lionsarmor/cyber-disk-site/site/boards/controller-r1/READ_BEFORE_ORDER.txt

Drive controller · R1
Audio R1 · routed prototype
Main board includes GP27 filtered PWM audio, LM386 and J6 speaker output. J4 pin6 reserved. Playback firmware and powered tests remain outstanding. Current hardware layout and assembly silkscreen. Static checks pass with zero unrouted connections. Gerbers are for prototype fabrication; powered and printed sample qualification is not yet complete. Firmware is unchanged and experimental.

KiCad 10 required. Stock KiCad libraries are needed in addition to bundled local libraries. ZIP contains this board only. No order is placed by downloading.
Source commit 6aa8da5d3b4f68ce047f3269cee6ab1ada03a126
PCB SHA256 d241955f942fde7b65e0d3dcb7b5b6f4355cdfbe41e1222cc3d9f77006061fe5
