lionsarmor/cyber-disk-site/site/downloads/master-bom.csv

id | supplier | part | mpn | drive | single | ab | sleeve | dock | unit | assembly | status | url | alternative | notes | evidence
E01 | Mouser | 4 MiB SPI flash | MX25L3233FM2I-08G-TR |  | 1 | 2 |  |  | each | Disk PCB | Listed in stock | https://www.mouser.com/en/ProductDetail/Macronix/MX25L3233FM2I-08G-TR?qs=mELouGlnn3cWHP7slfWMaw%3D%3D |  | 95-25L3233FM2I08TR. Replaces EOL W25Q32JVSSIQ. Wide M2 SOP8 only; pinout/land pattern match. Firmware now checks C2 20 16 JEDEC and rejects protected media; hardware testing pending. No larger-capacity alternate qualified. | Supplier listing reviewed 2026-11-07; stock must be rechecked at order time
E02 | Mouser | 100 nF 50 V X7R capacitor · 0805 | C0805C104K5RACTU |  | 1 | 2 |  |  | each | Disk PCB | Listed in stock | https://www.mouser.com/en/ProductDetail/KEMET/C0805C104K5RACTU?qs=Pc30aiB8zWUISNb2Qeyxfw%3D%3D |  | 80-C0805C104K5R. Replaces obsolete GRM21BR71C104KA01L; same capacitance and 0805 footprint. | Supplier listing reviewed 2026-11-07; stock must be rechecked at order time
E03 | Mouser | 10 kΩ 1% resistor · 0805 | RC0805FR-0710KL |  | 3 | 6 |  |  | each | Disk PCB | Listed in stock | https://www.mouser.com/ProductDetail/YAGEO/RC0805FR-0710KL |  | 603-RC0805FR-0710KL. Three pullups per independent storage bank. | Supplier listing reviewed 2026-11-07; stock must be rechecked at order time
E17 | Mouser | 20-way Pico socket strips | SSW-120-01-G-S | 2 |  |  |  | 2 | each | Controller and dock assembly | Specified · prototype validation required | https://www.mouser.com/c/?q=200-SSW12001GS |  | Two per carrier. The actual 8.5 mm socket stack is modeled; Pico 2 H plugs into these strips. | Manufacturer/supplier dimensions reviewed 2026-11-07; inventory not reserved
E18 | Mouser | Solderable metal spring contacts | S7131-45R | 7 |  |  |  |  | each | Contact PCB | Listed in stock | https://www.mouser.com/en/ProductDetail/Harwin/S7131-45R?qs=pffCcXpkxLy98k%2F0F4%2FdwQ%3D%3D |  | 855-S7131-45R. Manufacturer drawing controls: 2.0mm free height, 1.0–1.4mm working range. Mouser summary dimensions disagree; use Harwin drawing. Solder base only; sliding wear unqualified. | Supplier listing reviewed 2026-11-07; stock must be rechecked at order time
H01 | Mouser | M3 short tapered heat-set inserts | IUB-M3-1 | 22 |  |  |  | 2 | each | Drive structure | Specified · prototype validation required | https://www.mouser.com/c/?q=IUB-M3-1 |  | 3.43 mm length, 4.37 mm maximum OD. Pockets follow PEM 3.89–4.04 mm tapered bore and 4.44 mm minimum depth. Print insertion coupons; do not substitute Adafruit 4255. | Manufacturer/supplier dimensions reviewed 2026-11-07; inventory not reserved
H02 | Common hardware / McMaster | M3 × 8 countersunk cassette screws | DIN 7991 M3x8 | 4 |  |  |  | 6 | each | Drive structure | Specified · prototype validation required | https://www.mcmaster.com/screws/thread-size~m3/ |  | Four underside cassette screws. Overall length includes countersunk head; dock uses four bridge and two carrier screws. | Manufacturer/supplier dimensions reviewed 2026-11-07; inventory not reserved
H03 | Common hardware / McMaster | M3 × 10 button-head screws | ISO 7380-1 M3x10 | 6 |  |  |  |  | each | Drive structure | Specified · prototype validation required | https://www.mcmaster.com/screws/thread-size~m3/ |  | Four inside bezel screws and two latch-bracket screws; head Ø5.7 ×1.65 mm. | Manufacturer/supplier dimensions reviewed 2026-11-07; inventory not reserved
H04 | Common hardware / McMaster | M3 × 6 button-head PCB screws | ISO 7380-1 M3x6 | 4 |  |  |  | 6 | each | Controller mounting | Specified · prototype validation required | https://www.mcmaster.com/screws/thread-size~m3/ |  | Head Ø5.7 ×1.65 mm; four captive M3 nuts under main PCB. | Manufacturer/supplier dimensions reviewed 2026-11-07; inventory not reserved
H05 | Common hardware / McMaster | M3 hex nuts | ISO 4032 M3 | 4 |  |  |  | 12 | each | Controller mounting | Specified · prototype validation required | https://www.mcmaster.com/nuts/thread-size~m3/ |  | 5.5 mm AF, 2.4 mm thick; trap clearance in CAD. | Manufacturer/supplier dimensions reviewed 2026-11-07; inventory not reserved
H06 | Common hardware / McMaster | M3 × 6 tower/carrier screws | ISO 7380-1 M3x6 | 4 |  |  |  |  | each | Tower installation | Specified · prototype validation required | https://www.mcmaster.com/screws/thread-size~m3/ |  | Four screws per installation; do not count twice when core is inside external case. Check tower sheet thickness and screw engagement. | Manufacturer/supplier dimensions reviewed 2026-11-07; inventory not reserved
H07 | Common hardware / McMaster | M2 × 6 socket-head hinge-cap screws | DIN 912 M2x6 | 4 |  |  |  |  | each | Flap bearings | Specified · prototype validation required | https://www.mcmaster.com/screws/thread-size~m2/ |  | Four removable bearing-cap screws; Ø3.8 ×2 mm head. | Manufacturer/supplier dimensions reviewed 2026-11-07; inventory not reserved
H08 | Common hardware / McMaster | M2 hex nuts | ISO 4032 M2 | 8 |  |  |  | 4 | each | Flap bearings | Specified · prototype validation required | https://www.mcmaster.com/nuts/thread-size~m2/ |  | 4 mm AF ×1.6 mm thick. Four bearing caps plus four switch mounting nuts. | Manufacturer/supplier dimensions reviewed 2026-11-07; inventory not reserved
H09 | Common hardware / McMaster | M2 × 8 countersunk lid / clamp screws | DIN 7991 M2x8 | 6 |  |  |  | 6 | each | Lid and cable clamp | Specified · prototype validation required | https://www.mcmaster.com/screws/thread-size~m2/ |  | Four core lid screws and two contact-harness clamp screws. Overall length 8 mm. | Manufacturer/supplier dimensions reviewed 2026-11-07; inventory not reserved
H10 | MISUMI | M2 × 5 ultra-low-head contact PCB screws | CBSTSR2-5 | 2 |  |  |  |  | each | Contact cartridge | Specified · prototype validation required | https://my.misumi-ec.com/vona2/detail/110302280540/?HissuCode=CBSTSR2-5 |  | Use the ultra-low-head part only: specified head Ø4 ×0.5 mm. Do not substitute a tall socket head in the disk path. | Manufacturer/supplier dimensions reviewed 2026-11-07; inventory not reserved
H11 | Mouser | M2 heat-set inserts | IUTB-M2 | 6 |  |  |  | 6 | each | Lid and contact PCB | Specified · prototype validation required | https://www.mouser.com/c/?q=IUTB-M2 |  | 4 mm long, 3.73 mm maximum OD; Ø3.23 mm hole, ≥4.76 mm depth. Lid and cartridge mounts. | Manufacturer/supplier dimensions reviewed 2026-11-07; inventory not reserved
H12 | Mouser | M2 harness clamp heat-set inserts | IUTB-M2 | 2 |  |  |  |  | each | Cable clamp | Specified · prototype validation required | https://www.mouser.com/c/?q=IUTB-M2 |  | Same 4 mm insert as H11; clamp bosses deepened accordingly. | Manufacturer/supplier dimensions reviewed 2026-11-07; inventory not reserved
H13 | Common hardware / McMaster | Smooth Ø3 mm steel rod, cut to length | 3 mm precision steel rod | 1 |  |  |  |  | cutting stock | Eject carriage | Specified · prototype validation required | https://www.mcmaster.com/rods/diameter~3-mm/ |  | Cut two 71 mm eject rods and one 11.9 mm left flap pivot. Deburr and polish ends. No grooves, D-flats or threaded sliding surfaces. | Manufacturer/supplier dimensions reviewed 2026-11-07; inventory not reserved
H14 | Lee Spring | Matched eject compression springs | LC022D14M | 2 |  |  |  |  | each | Eject carriage | Specified · prototype validation required | https://www.leespring.in/sites/default/files/2019-09/lee-spring-catalog-in.pdf |  | Two springs: free 63.5 mm, OD7.62, wire0.5588, solid9.93; rate1.10 lbf/in (0.193 N/mm). Installed27.6–55.6 mm; combined nominal preload3.0–13.8 N. Catalog specified; confirm current availability with Lee. | Manufacturer/supplier dimensions reviewed 2026-11-07; inventory not reserved
H15 | Lee Spring | Eject-button return spring | LC018C09M | 1 |  |  |  |  | each | Eject button | Specified · prototype validation required | https://www.leespring.in/sites/default/files/2019-09/lee-spring-catalog-in.pdf |  | Free19.05 mm, OD6.096, wire.4572, solid3.35, rate2.80 lbf/in. Installed8.3–14.3 mm; avoids coil bind at full 6 mm button stroke. | Manufacturer/supplier dimensions reviewed 2026-11-07; inventory not reserved
H16 | Lee Spring | Latch bias spring | CI008BC03M | 1 |  |  |  |  | each | Latch | Specified · prototype validation required | https://www.leespring.in/sites/default/files/2019-09/lee-spring-catalog-in.pdf |  | Free6.35 mm, OD2.3876, wire.2032, solid1.53; rate2.14 lbf/in. Installed2.7–5.5 mm. | Manufacturer/supplier dimensions reviewed 2026-11-07; inventory not reserved
H17 | Lee Spring | Flap torsion spring | LTR014A04M | 1 |  |  |  |  | each | Flap hinge | Specified · prototype validation required | https://www.leespring.in/sites/default/files/2019-09/lee-spring-catalog-in.pdf |  | Right-hand, 180° free legs; OD4.93 mm, wire.3556, body1.91. Trim straight legs to6 mm; closed preload65°, full-open deflection155°. Rated torque.075 in-lb at180°. Physical torque/friction test required. | Manufacturer/supplier dimensions reviewed 2026-11-07; inventory not reserved
H18 | Mouser / common hardware | Flap right pivot screw and metal bearing spacer | R30-5001002 + DIN7991 M3x25 + DIN985 M3 | 1 |  |  |  |  | set | Flap hinge | Specified · prototype validation required | https://www.harwin.com/products/R30-5001002 |  | Spacer is10 mm long, Ø4.76, M3 through-threaded. One countersunk M3x25 and one M3 nylon-lock nut clamp flap and rocker to spacer; round bearing runs freely in split housing. | Manufacturer/supplier dimensions reviewed 2026-11-07; inventory not reserved
H19 | Common hardware / McMaster | Standard metal follower screws | DIN912 M2x20 + DIN912 M2x10 | 1 |  |  |  |  | set | Actuator and latch | Specified · prototype validation required | https://www.mcmaster.com/screws/thread-size~m2/ |  | One M2x20 latch follower and one M2x10 flap follower; replaceable smooth brass sleeves carry cam wear. | Manufacturer/supplier dimensions reviewed 2026-11-07; inventory not reserved
H20 | Common hardware / McMaster | Follower locking nuts | DIN985 M2 | 2 |  |  |  |  | each | Actuator and latch | Specified · prototype validation required | https://www.mcmaster.com/nuts/thread-size~m2/ |  | Two M2 nylon-lock nuts, 4 mm AF ×2.8 mm maximum height. Replaces all small follower retaining clips. | Manufacturer/supplier dimensions reviewed 2026-11-07; inventory not reserved
H21 | Hobby / K&S | Brass wear-sleeve stock | K&S 9821 | 1 |  |  |  |  | cutting stock | Flap actuator | Specified · prototype validation required | https://ksmetals.com/collections/all-products-1?page=10 |  | Ø3 mm OD ×0.45 wall (2.1 mm ID). Cut sleeves3.3 mm,4.4 mm and5.0 mm; square/deburr ends. No retaining grooves required. | Manufacturer/supplier dimensions reviewed 2026-11-07; inventory not reserved
H22 | Common hardware / McMaster | Compliant contact-harness grip pad | Silicone sheet 2 mm, Shore A40 | 1 |  |  |  |  | each | Cable clamp | Specified · prototype validation required | https://www.mcmaster.com/silicone-sheets/ |  | Cut4×5×2 mm. Clamp on insulation only; check grip without crushing conductors. | Manufacturer/supplier dimensions reviewed 2026-11-07; inventory not reserved
E19 | Mouser | 26 AWG stranded contact/switch wire | 6821 BK005 | 2 |  |  |  |  | metres | Contact harness | Specified · prototype validation required | https://www.mouser.com/ProductDetail/Alpha-Wire/6821-BK005 |  | 0.89 mm nominal OD (0.94 mm max), 7/34 strands, compatible with terminal 26–20 AWG range. Seven contact wires cut150 mm each; number both ends 1–7. Colours in preview identify signals; numbered black wire is sufficient. Do not tin ends clamped under screws. Quantity is cut length, not 100 ft spools. | Manufacturer/supplier dimensions reviewed 2026-11-07; inventory not reserved
B01 | PCBWay | Single-bank disk PCB | Custom project PCB |  | 1 |  |  |  | each | Disk PCB | Prototype only | https://www.pcbway.com/pcb-assembly.html |  | 87 x91 x1.6mm R4; 2 layers; verify contact plating and wear. Provisional Gerbers exist. Turnkey assembly is a quote option; components are not included automatically with bare boards. | Supplier listing reviewed 2026-11-07; stock must be rechecked at order time
B02 | PCBWay | Independent A/B disk PCB | Custom project PCB |  |  | 1 |  |  | each | Disk PCB | Prototype only | https://www.pcbway.com/pcb-assembly.html |  | Same outline, two independent banks; both component banks on top for one stencil. Turnkey assembly is a quote option; components are not included automatically with bare boards. | Supplier listing reviewed 2026-11-07; stock must be rechecked at order time
B03 | PCBWay | Passive contact cartridge PCB | Custom project PCB | 1 |  |  |  |  | each | Contact PCB | Prototype only | https://www.pcbway.com/pcb-assembly.html |  | 18.525 x49 x1.6mm; routed R1; seven soldered spring lands and pigtail pads. Turnkey assembly is a quote option; components are not included automatically with bare boards. | Supplier listing reviewed 2026-11-07; stock must be rechecked at order time
B04 | PCBWay | Routed drive-controller PCB | cyber-drive-controller-r1 | 1 |  |  |  |  | each | Controller PCB | Specified · prototype validation required | https://www.pcbway.com/ |  | 136×65×1.6 mm; rounded corners; current R3 hardware changes, silkscreen/logo, isolated media rails and interlock. Use current per-board Gerbers, not R0. | Manufacturer/supplier dimensions reviewed 2026-11-07; inventory not reserved
P01 | Print at home | 01 base tray | Project STL / STEP | 1 |  |  |  |  | each | Drive printed parts | Prototype only | index.html?model=drive%2Fexploded |  | Print material, orientation and tolerances require prototype testing. | Current drive R4 parts.json
P02 | Print at home | 02 top cover | Project STL / STEP | 1 |  |  |  |  | each | Drive printed parts | Prototype only | index.html?model=drive%2Fexploded |  | Print material, orientation and tolerances require prototype testing. | Current drive R4 parts.json
P03 | Print at home | 04b left hinge bearing cap | Project STL / STEP | 1 |  |  |  |  | each | Drive printed parts | Prototype only | index.html?model=drive%2Fexploded |  | Print material, orientation and tolerances require prototype testing. | Current drive R4 parts.json
P04 | Print at home | 04b right hinge bearing cap | Project STL / STEP | 1 |  |  |  |  | each | Drive printed parts | Prototype only | index.html?model=drive%2Fexploded |  | Print material, orientation and tolerances require prototype testing. | Current drive R4 parts.json
P05 | Print at home | 03 bezel | Project STL / STEP | 1 |  |  |  |  | each | Drive printed parts | Prototype only | index.html?model=drive%2Fexploded |  | Print material, orientation and tolerances require prototype testing. | Current drive R4 parts.json
P06 | Print at home | 04 door flap | Project STL / STEP | 1 |  |  |  |  | each | Drive printed parts | Prototype only | index.html?model=drive%2Fexploded |  | Print material, orientation and tolerances require prototype testing. | Current drive R4 parts.json
P07 | Print at home | flap actuator rocker | Project STL / STEP | 1 |  |  |  |  | each | Drive printed parts | Prototype only | index.html?model=drive%2Fexploded |  | Print material, orientation and tolerances require prototype testing. | Current drive R4 parts.json
P08 | Print at home | 05 left guide | Project STL / STEP | 1 |  |  |  |  | each | Drive printed parts | Prototype only | index.html?model=drive%2Fexploded |  | Print material, orientation and tolerances require prototype testing. | Current drive R4 parts.json
P09 | Print at home | 06 right guide | Project STL / STEP | 1 |  |  |  |  | each | Drive printed parts | Prototype only | index.html?model=drive%2Fexploded |  | Print material, orientation and tolerances require prototype testing. | Current drive R4 parts.json
P10 | Print at home | 07b left eject sled | Project STL / STEP | 1 |  |  |  |  | each | Drive printed parts | Prototype only | index.html?model=drive%2Fexploded |  | Print material, orientation and tolerances require prototype testing. | Current drive R4 parts.json
P11 | Print at home | 07 right eject sled and keeper | Project STL / STEP | 1 |  |  |  |  | each | Drive printed parts | Prototype only | index.html?model=drive%2Fexploded |  | Print material, orientation and tolerances require prototype testing. | Current drive R4 parts.json
P12 | Print at home | 08 keyed latch slide | Project STL / STEP | 1 |  |  |  |  | each | Drive printed parts | Prototype only | index.html?model=drive%2Fexploded |  | Print material, orientation and tolerances require prototype testing. | Current drive R4 parts.json
P13 | Print at home | 09 latch guide block | Project STL / STEP | 1 |  |  |  |  | each | Drive printed parts | Prototype only | index.html?model=drive%2Fexploded |  | Print material, orientation and tolerances require prototype testing. | Current drive R4 parts.json
P14 | Print at home | 10 sequenced eject slider | Project STL / STEP | 1 |  |  |  |  | each | Drive printed parts | Prototype only | index.html?model=drive%2Fexploded |  | Print material, orientation and tolerances require prototype testing. | Current drive R4 parts.json
P15 | Print at home | 12 bottom contact cassette | Project STL / STEP | 1 |  |  |  |  | each | Drive printed parts | Prototype only | index.html?model=drive%2Fexploded |  | Print material, orientation and tolerances require prototype testing. | Current drive R4 parts.json
P16 | Print at home | 13 harness strain clamp | Project STL / STEP | 1 |  |  |  |  | each | Drive printed parts | Prototype only | index.html?model=drive%2Fexploded |  | Print material, orientation and tolerances require prototype testing. | Current drive R4 parts.json
P30 | Print at home | Upper and lower disk shell | Matching style and single / A/B geometry |  | 2 | 2 |  |  | halves | Disk shell | Prototype only | index.html?model=basic%2Fab |  | Current snap-fit shells; no disk-face screws or nuts. Choose basic, recessed, Cyber Runner or Deep Space. Do not mix archived screw-service shells. | Current inspector model catalog
P31 | Print at home | Optional Cyber Runner accents / inlays | 4 accents + 4 inlay pieces |  |  |  |  |  | 8 per styled disk | Optional styling | Prototype only | index.html?model=cyber-runner%2Fab |  | Per styled disk: 8 optional printed pieces. Excluded from base disk quantity totals. | Current inspector model catalog
P32 | Print at home | Optional Deep Space accents | 4 wrap accents |  |  |  |  |  | 4 per styled disk | Optional styling | Prototype only | index.html?model=deep-space%2Fab |  | Per styled disk: 4 optional accents. Excluded from base disk quantity totals. | Current inspector model catalog
P33 | Print at home | Modular sleeve | Project sleeve R0 |  |  |  | 1 |  | each | Sleeve | Prototype only | index.html?model=sleeve%2Fempty |  | Optional accessory; slide joints and Sega case fit remain unverified. | Current inspector model catalog
A01 | Local print / office supplier | White wrap label | Single-sided or full A/B wrap |  | 1 | 1 |  |  | each | Artwork | Unselected |  |  | Use the current rounded straight-fold template, white stock and Roddy branding; adhesive/finish and exact stock not selected. | Project requirement; not a sourced SKU
A02 | Included | Media isolation and interlock hardware | Included in controller + CR1-SW |  |  |  |  |  | each | Controller and interlock | Specified · prototype validation required | http://disk.roddy.world/electrical.html |  | No extra unselected isolation board: switched rail, signal isolation, active discharge and physical switches are in current hardware. Avoid double-counting components. | Manufacturer/supplier dimensions reviewed 2026-11-07; inventory not reserved
A03 | Included | Sound / lighting / external ports | Included in dock and DX86/DX90 |  |  |  |  |  | each | External dock features | Specified · prototype validation required | http://disk.roddy.world/?model=pcb%2Fdock |  | USB-B, RS232, Commodore IEC and custom3.3V accessory connector. ESP32/Next protocol adapters and emulation software are separate from this board; connector presence is not firmware support. | Manufacturer/supplier dimensions reviewed 2026-11-07; inventory not reserved
A04 | Not specified yet | External host cables and optional Sega case | Choose for host / packaging |  |  |  |  |  | As required | Optional accessories | Unselected |  |  | Optional host-side cables and retail packaging depend on the chosen computer. The regulated 5V supply is already specified separately as DX80; do not count another supply here. | Not yet specified
A05 | Local hardware / electronics supplier | Solder or paste, flux and heat-shrink | Assembly consumables |  |  |  |  |  | As required | Assembly supplies | Unselected |  |  | Tools and consumables are not counted as fitted parts. A stencil is optional for paste assembly; PCBWay can quote stencils. | Assembly requirement; not a sourced SKU
DX81 | Mouser | Internal USB-A to micro-B jumper, 6.5 inch | Adafruit 898 |  |  |  |  | 1 | each | External dock R3 | Fit pending | https://www.mouser.com/ProductDetail/Adafruit/898 |  | 485-898. Plugs into J10 and Pico micro-B; no test-pad soldering. Cable envelope needs physical fit test. | Mouser listing and Adafruit specification reviewed 2026-11-07
DX86 | Mouser | Through-hole diffused addressable RGB LEDs | Adafruit 1938 |  |  |  |  | 1 | five-pack | External dock R3 | Specified · prototype validation required | https://www.mouser.com/c/?q=485-1938 |  | Three fitted LEDs from one five-pack, max60mA each, total180mA within200mA light allocation. Three local100nF caps required. Screw-retained lightwell; programmable effects are firmware work. | Manufacturer/supplier dimensions reviewed 2026-11-07; inventory not reserved
DX80 | Mouser | External regulated 5V 2A adapter, centre positive | WSU050-2000 |  |  |  |  | 1 | each | External dock R3 | Listed in stock; electrical qualification pending | https://www.mouser.com/en/ProductDetail/Triad-Magnetics/WSU050-2000?qs=B4sXYbYweUrLCvb6OyMLMA%3D%3D |  | 553-WSU050-2000. 5.5 x 2.1 x 11 mm plug. About $7.62 each when checked. Verify loaded board voltage including cable/ripple; not an internal supply. | Mouser US listing read 2026-11-07; 60 shown, not reserved
DX88 | Common hardware / Mouser | External-case fasteners and feet | See hardware cut/fastener table |  |  |  |  |  | reference only | External dock R3 | Specified · prototype validation required | https://www.mcmaster.com/ |  | SixM2x8 lid screws+IUTB-M2 inserts; fourM3x8 chassis screws+M3 nuts; sixM3x6 board screws; twoM2x10 lightwell screws+M2 nuts; fourM3x6 core side screws shared with H06. Four10×10×2 mm rubber feet. See assembly drawing for retention hardware. | Manufacturer/supplier dimensions reviewed 2026-11-07; inventory not reserved
DX89 | 3D print | Rounded enclosure, carriers and opal diffuser | External dock R4 |  |  |  |  | 1 | printed set | External dock R3 | Specified · prototype validation required | http://disk.roddy.world/?model=external%2Fclosed |  | 168×280×57 mm including feet; shallow roof recess, shell-matched RODDY artwork and wraparound diffuser. Core raised for solid TH-LED retention bridge; same bay-standard core. | Manufacturer/supplier dimensions reviewed 2026-11-07; inventory not reserved
DX27 | Mouser | 10-way 1:1 internal signal ribbon | 1658621-1 + 3365/10-100SF |  |  |  |  | 1 | harness | External dock R3 | Specified · prototype validation required | https://www.mouser.com/c/?q=571-1658621-1 |  | Two TE10-way IDC sockets,220 mm of 3M1.27 mm pitch28AWG ribbon. Straight1:1, no PC floppy twist. Pin1 stripe matched at both ends; dock pins2/7 remain NC. | Manufacturer/supplier dimensions reviewed 2026-11-07; inventory not reserved
DX28 | Mouser | 5V internal power harness | 171822-4 + 170204-2 + 3051 BK005 |  |  |  |  | 1 | harness | External dock R3 | Specified · prototype validation required | https://www.mouser.com/c/?q=571-1718224 |  | TE4-way housing, two170204-2 sockets.22AWG stranded Alpha3051 wire,150 mm each red-marked5V and blackGND. Other end Harwin2-way J6. Berg cavity4(12V) remains empty; verify continuity before connection. | Manufacturer/supplier dimensions reviewed 2026-11-07; inventory not reserved
CR1-SW | Mouser | Seat NO and pre-eject NC switches | D2F-01-D | 2 |  |  |  |  | each | Drive mechanism | Specified · prototype validation required | https://www.mouser.com/c/?q=653-D2F-01-D |  | Compact solder-lug plunger version. SW1 NO and SW2 NC in series to J5. R5 includes screw mounts, cams and lug wiring. Adjust to manufacturer operating position before powered tests. | Manufacturer/supplier dimensions reviewed 2026-11-07; inventory not reserved
H02G | Common hardware / McMaster | M3 × 6 countersunk guide screws | DIN 7991 M3x6 | 4 |  |  |  |  | each | Hardware R3 | Specified · prototype validation required | https://www.mcmaster.com/screws/thread-size~m3/ |  | Four guide screws; 6 mm overall, head diameter 6 mm. | Manufacturer/supplier dimensions reviewed 2026-11-07; inventory not reserved
H23 | Common hardware / McMaster | Switch mounting screws | DIN912 M2x12 + DIN7991 M2x12 | 1 |  |  |  |  | set | Hardware R3 | Specified · prototype validation required | https://www.mcmaster.com/screws/thread-size~m2/ |  | Two socket-head screws for seat switch, two countersunk screws through base for eject switch. | Manufacturer/supplier dimensions reviewed 2026-11-07; inventory not reserved
HX01 | Mouser | Contact-board seven-way screw terminal | 1725708 | 1 |  |  |  |  | each | Hardware R3 | Specified · prototype validation required | https://www.mouser.com/c/?q=651-1725708 |  | Phoenix MPT0.5/7-2.54; 18.24×6.2×8.5 mm installed. Mounted underneath contact PCB; wire 1:1 to identical core J3. Core terminal is counted in CR1 BOM. Strip 4.5 mm, torque 0.12–0.15 Nm; support housing while tightening. Trim contact-board solder tails to <=0.5 mm above PCB. | Manufacturer/supplier dimensions reviewed 2026-11-07; inventory not reserved
HX02 | Mouser | 2-way removable header housings | M20-1060200 | 2 |  |  |  | 2 | each | Hardware R3 | Specified · prototype validation required | https://www.mouser.com/c/?q=855-M20-1060200 |  | Drive J5 interlock and J6 speaker; dock J6 power and J8 passive piezo. | Manufacturer/supplier dimensions reviewed 2026-11-07; inventory not reserved
HX03 | Mouser | 3-way lighting header housing | M20-1060300 |  |  |  |  | 1 | each | Hardware R3 | Specified · prototype validation required | https://www.mouser.com/c/?q=855-M20-1060300 |  | Dock J7: verify 5V/data/GND order against silkscreen. | Manufacturer/supplier dimensions reviewed 2026-11-07; inventory not reserved
HX04 | Mouser | Loose crimp sockets,22–30 AWG | M20-1180042 | 4 |  |  |  | 7 | each | Hardware R3 | Specified · prototype validation required | https://www.mouser.com/c/?q=855-M20-1180042 |  | Harwin M20 socket contacts; one per populated housing cavity. Crimp with proper die, pull-test each wire. | Manufacturer/supplier dimensions reviewed 2026-11-07; inventory not reserved
DX90 | Mouser | Passive piezo sounder | PS1240P02CT3 |  |  |  |  | 1 | each | Hardware R3 | Specified · prototype validation required | https://www.mouser.com/c/?q=810-PS1240P02CT3 |  | 12.2×3.5 mm TDK piezo; existing GPIO26 feeds J8 through added R11=1k. Maximum pin current3.3mA; intended for chirps/tones. | Manufacturer/supplier dimensions reviewed 2026-11-07; inventory not reserved
DX91 | Mouser | LED local decoupling capacitors | C315C104M5U5TA |  |  |  |  | 3 | each | Hardware R3 | Specified · prototype validation required | https://www.mouser.com/c/?q=80-C315C104M5U |  | One100nF across each TH pixel supply, short leads; insulate hand-wired connections. | Manufacturer/supplier dimensions reviewed 2026-11-07; inventory not reserved
H24 | Common hardware / McMaster | M2 × 10 countersunk lightwell / piezo screws | DIN7991 M2x10 |  |  |  |  | 4 | each | Hardware R3 | Specified · prototype validation required | https://www.mcmaster.com/screws/thread-size~m2/ |  | Two lightwell and two piezo-cap screws; nuts counted in H08. | Manufacturer/supplier dimensions reviewed 2026-11-07; inventory not reserved
H25 | Common hardware / McMaster | M3 × 10 countersunk rear-tray screws | DIN7991 M3x10 |  |  |  |  | 2 | each | Hardware R3 | Specified · prototype validation required | https://www.mcmaster.com/screws/thread-size~m3/ |  | Two rear panel screws; inserts counted in H01. | Manufacturer/supplier dimensions reviewed 2026-11-07; inventory not reserved
H26 | Common hardware / McMaster | Self-adhesive rubber feet | 10 × 10 × 2 mm |  |  |  |  | 4 | each | Hardware R3 | Specified · prototype validation required | https://www.mcmaster.com/rubber-feet/ |  | Four feet; use at least 2 mm height for underfloor joint bridge clearance. | Manufacturer/supplier dimensions reviewed 2026-11-07; inventory not reserved
H27 | Common hardware / McMaster | Piezo isolation washer | 2 mm closed-cell foam |  |  |  |  | 1 | each | Hardware R3 | Specified · prototype validation required | https://www.mcmaster.com/foam/ |  | Cut 12 mm OD / 8 mm ID ring; supports piezo above insulated solder joints. | Manufacturer/supplier dimensions reviewed 2026-11-07; inventory not reserved
B05 | PCBWay | Routed external daughterboard PCB | cyber-external-dock-r3 |  |  |  |  | 1 | each | Hardware R3 | Specified · prototype validation required | https://www.pcbway.com/ |  | Current dock R3 board with RODDY silkscreen and board-mounted ports. Use external-r3 PCBWay Gerber package; no mains circuitry. | Manufacturer/supplier dimensions reviewed 2026-11-07; inventory not reserved
SP01 | Mouser | Drive dynamic speaker, 20 mm × 3 mm, 8 ohm 0.5 W | AS02008MR-R | 1 |  |  |  |  | each | Hardware R3 | Specified · prototype validation required | https://www.mouser.com/en/ProductDetail/PUI-Audio/AS02008MR-R?qs=e16JbV5WBEsk5k09rzRy6w%3D%3D |  | Main-board LM386 drives this speaker through J6. Solder two 26 AWG leads to pads (<=3 seconds per PUI); terminate in removable 2-way housing. Rear-wall printed cradle and screw ring, no diaphragm loading. Mouser 665-AS02008MRR listed in stock at review; not reserved. | Manufacturer/supplier dimensions reviewed 2026-11-07; inventory not reserved
SP02 | Common hardware / McMaster | Speaker retention hardware | M2x8 + M2x10 countersunk + M2 nuts | 1 |  |  |  |  | set | Hardware R3 | Specified · prototype validation required | https://www.mcmaster.com/screws/thread-size~m2/ |  | Two M2x8 ring screws, two M2x10 rear cradle screws and four M2 nuts; keep separate from existing mechanism fastener counts. | Manufacturer/supplier dimensions reviewed 2026-11-07; inventory not reserved
SP03 | Common hardware / McMaster | Speaker rim isolation foam | 0.6 mm closed-cell foam | 1 |  |  |  |  | each | Hardware R3 | Specified · prototype validation required | https://www.mcmaster.com/foam/ |  | Cut 20.4 mm OD / 19.2 mm ID ring, compressed to approximately0.4 mm. Frame only: never cover or press diaphragm. Verify supplied speaker rim on physical sample. | Manufacturer/supplier dimensions reviewed 2026-11-07; inventory not reserved
SP04 | Mouser | Speaker wiring pair | Alpha 6821 BK005 | 1 |  |  |  |  | pair | Hardware R3 | Specified · prototype validation required | https://www.mouser.com/ProductDetail/Alpha-Wire/6821-BK005 |  | Two 100 mm lengths of26AWG stranded wire, red-mark positive; 2 Harwin M20 crimp contacts for J6 housing (same family as interlock). Measure final loom before cutting. | Manufacturer/supplier dimensions reviewed 2026-11-07; inventory not reserved
CR1-01 | Mouser | 34-PIN PC FLOPPY | 5103310-7 | 1 |  |  |  |  | each | Controller R1 | Specified · listed by supplier | https://www.mouser.com/c/?q=571-5103310-7 |  | J1; Connector_IDC:IDC-Header_2x17_P2.54mm_Horizontal. Builder assembly through-hole; Pico is a factory-assembled module. Check stock when ordering. | Saved-board BOM reconciled 2026-11-07; exact Mouser SKU 571-5103310-7
CR1-02 | Mouser | FLOPPY POWER 5V GND GND 12V | 171826-4 | 1 |  |  |  |  | each | Controller R1 | Specified · listed by supplier | https://www.mouser.com/c/?q=571-1718264 |  | J2; Drive:TE_171826-4. Builder assembly through-hole; Pico is a factory-assembled module. Check stock when ordering. | Saved-board BOM reconciled 2026-11-07; exact Mouser SKU 571-1718264
CR1-03 | Mouser | PICO 2 SC1632 SOCKETED | SC1632 | 1 |  |  |  |  | each | Controller R1 | Specified · listed by supplier | https://www.mouser.com/c/?q=358-SC1632 |  | A1; Module:RaspberryPi_Pico_Common_THT. Builder assembly through-hole; Pico is a factory-assembled module. Check stock when ordering. | Saved-board BOM reconciled 2026-11-07; exact Mouser SKU 358-SC1632
CR1-04 | Mouser | SN74LVC245AN / 5V-TOL INPUT | SN74LVC245AN | 3 |  |  |  |  | each | Controller R1 | Specified · listed by supplier | https://www.mouser.com/c/?q=595-SN74LVC245AN |  | U1, U2, U4; Package_DIP:DIP-20_W7.62mm. Builder assembly through-hole; Pico is a factory-assembled module. Check stock when ordering. | Saved-board BOM reconciled 2026-11-07; exact Mouser SKU 595-SN74LVC245AN
CR1-05 | Mouser | TN0702 / FDD INDEX | TN0702N3-G | 9 |  |  |  |  | each | Controller R1 | Specified · listed by supplier | https://www.mouser.com/c/?q=689-TN0702N3-G |  | Q4, Q5, Q6, Q7, Q8, Q2, Q3, Q10, Q11; Package_TO_SOT_THT:TO-92_Inline. Builder assembly through-hole; Pico is a factory-assembled module. Check stock when ordering. | Saved-board BOM reconciled 2026-11-07; exact Mouser SKU 689-TN0702N3-G
CR1-06 | Mouser | 8x10k BUSSED / COMMON PIN1 | 4609X-101-103LF | 2 |  |  |  |  | each | Controller R1 | Specified · listed by supplier | https://www.mouser.com/c/?q=652-4609X-1LF-10K |  | RN1, RN2; Resistor_THT:R_Array_SIP9. Builder assembly through-hole; Pico is a factory-assembled module. Check stock when ordering. | Saved-board BOM reconciled 2026-11-07; exact Mouser SKU 652-4609X-1LF-10K
CR1-07 | Mouser | 8x1k BUSSED / COMMON GND | 4609X-101-102LF | 1 |  |  |  |  | each | Controller R1 | Specified · listed by supplier | https://www.mouser.com/c/?q=652-4609X-1LF-1K |  | RN3; Resistor_THT:R_Array_SIP9. Builder assembly through-hole; Pico is a factory-assembled module. Check stock when ordering. | Saved-board BOM reconciled 2026-11-07; exact Mouser SKU 652-4609X-1LF-1K
CR1-08 | Mouser | 2A FAST / LOW DROP | 0251002.MXL | 1 |  |  |  |  | each | Controller R1 | Specified · listed by supplier | https://www.mouser.com/c/?q=576-0251002.MXL |  | F1; Resistor_THT:R_Axial_DIN0309_L9.0mm_D3.2mm_P12.70mm_Horizontal. Builder assembly through-hole; Pico is a factory-assembled module. Check stock when ordering. | Saved-board BOM reconciled 2026-11-07; exact Mouser SKU 576-0251002.MXL
CR1-09 | Mouser | 1N5819 / USB BACKFEED BLOCK | 1N5819-E3/54 | 1 |  |  |  |  | each | Controller R1 | Specified · listed by supplier | https://www.mouser.com/c/?q=625-1N5819-E3 |  | D1; Diode_THT:D_DO-41_SOD81_P10.16mm_Horizontal. Builder assembly through-hole; Pico is a factory-assembled module. Check stock when ordering. | Saved-board BOM reconciled 2026-11-07; exact Mouser SKU 625-1N5819-E3
CR1-10 | Mouser | 47uF 16V | EEU-FC1C470 | 2 |  |  |  |  | each | Controller R1 | Specified · listed by supplier | https://www.mouser.com/c/?q=667-EEU-FC1C470 |  | C1, C14; Capacitor_THT:CP_Radial_D5.0mm_P2.00mm. Builder assembly through-hole; Pico is a factory-assembled module. Check stock when ordering. | Saved-board BOM reconciled 2026-11-07; exact Mouser SKU 667-EEU-FC1C470
CR1-11 | Mouser | 100nF 50V | C315C104M5U5TA | 7 |  |  |  |  | each | Controller R1 | Specified · listed by supplier | https://www.mouser.com/c/?q=80-C315C104M5U |  | C2, C3, C5, C7, C12, C15, C16; Drive:KEMET_C315_P2.54. Builder assembly through-hole; Pico is a factory-assembled module. Check stock when ordering. | Saved-board BOM reconciled 2026-11-07; exact Mouser SKU 80-C315C104M5U
CR1-12 | Mouser | 1725708 / CONTACT WIRES 1 TO 7 | 1725708 | 1 |  |  |  |  | each | Controller R1 | Specified · listed by supplier | https://www.mouser.com/c/?q=651-1725708 |  | J3; HardwareSilk:Terminal7_Phoenix1725708. Builder assembly through-hole; Pico is a factory-assembled module. Check stock when ordering. | Saved-board BOM reconciled 2026-11-07; exact Mouser SKU 651-1725708
CR1-13 | Mouser | DOCK LINK 3V3 UART | TSW-105-07-G-D | 1 |  |  |  |  | each | Controller R1 | Specified · listed by supplier | https://www.mouser.com/c/?q=200-TSW10507GD |  | J4; Connector_PinHeader_2.54mm:PinHeader_2x05_P2.54mm_Vertical. Builder assembly through-hole; Pico is a factory-assembled module. Check stock when ordering. | Saved-board BOM reconciled 2026-11-07; exact Mouser SKU 200-TSW10507GD
CR1-14 | Mouser | 10k SPI CS DEFAULT | MFR-25FBF52-10K | 5 |  |  |  |  | each | Controller R1 | Specified · listed by supplier | https://www.mouser.com/c/?q=603-MFR-25FBF52-10K |  | R1, R2, R5, R9, R13; Resistor_THT:R_Axial_DIN0207_L6.3mm_D2.5mm_P7.62mm_Horizontal. Builder assembly through-hole; Pico is a factory-assembled module. Check stock when ordering. | Saved-board BOM reconciled 2026-11-07; exact Mouser SKU 603-MFR-25FBF52-10K
CR1-15 | Mouser | 3V3 OUT / INTERLOCK RETURN | TSW-102-07-G-S | 2 |  |  |  |  | each | Controller R1 | Specified · listed by supplier | https://www.mouser.com/c/?q=200-TSW10207GS |  | J5, J6; Connector_PinHeader_2.54mm:PinHeader_1x02_P2.54mm_Vertical. Builder assembly through-hole; Pico is a factory-assembled module. Check stock when ordering. | Saved-board BOM reconciled 2026-11-07; exact Mouser SKU 200-TSW10207GS
CR1-16 | Mouser | LP2951ACN / SWITCHED 3V1 100mA | LP2951ACN/NOPB | 1 |  |  |  |  | each | Controller R1 | Specified · listed by supplier | https://www.mouser.com/c/?q=926-LP2951ACN/NOPB |  | U6; Package_DIP:DIP-8_W7.62mm. Builder assembly through-hole; Pico is a factory-assembled module. Check stock when ordering. | Saved-board BOM reconciled 2026-11-07; exact Mouser SKU 926-LP2951ACN/NOPB
CR1-17 | Mouser | 15k 1% | MFR-25FBF52-15K | 1 |  |  |  |  | each | Controller R1 | Specified · listed by supplier | https://www.mouser.com/c/?q=603-MFR-25FBF52-15K |  | R4; Resistor_THT:R_Axial_DIN0207_L6.3mm_D2.5mm_P7.62mm_Horizontal. Builder assembly through-hole; Pico is a factory-assembled module. Check stock when ordering. | Saved-board BOM reconciled 2026-11-07; exact Mouser SKU 603-MFR-25FBF52-15K
CR1-18 | Mouser | 68R FAILSAFE BLEED | MF1/4DC68R0F | 1 |  |  |  |  | each | Controller R1 | Specified · listed by supplier | https://www.mouser.com/c/?q=660-MF1/4DC68R0F |  | R6; Resistor_THT:R_Axial_DIN0207_L6.3mm_D2.5mm_P7.62mm_Horizontal. Builder assembly through-hole; Pico is a factory-assembled module. Check stock when ordering. | Saved-board BOM reconciled 2026-11-07; exact Mouser SKU 660-MF1/4DC68R0F
CR1-19 | Mouser | 680R DEFAULT OFF | MFR-25FBF52-680R | 1 |  |  |  |  | each | Controller R1 | Specified · listed by supplier | https://www.mouser.com/c/?q=603-MFR-25FBF52-680R |  | R7; Resistor_THT:R_Axial_DIN0207_L6.3mm_D2.5mm_P7.62mm_Horizontal. Builder assembly through-hole; Pico is a factory-assembled module. Check stock when ordering. | Saved-board BOM reconciled 2026-11-07; exact Mouser SKU 603-MFR-25FBF52-680R
CR1-20 | Mouser | 2R2 DISCHARGE | MFR-25FBF52-2R2 | 1 |  |  |  |  | each | Controller R1 | Specified · listed by supplier | https://www.mouser.com/c/?q=603-MFR-25FBF52-2R2 |  | R8; Resistor_THT:R_Axial_DIN0207_L6.3mm_D2.5mm_P7.62mm_Horizontal. Builder assembly through-hole; Pico is a factory-assembled module. Check stock when ordering. | Saved-board BOM reconciled 2026-11-07; exact Mouser SKU 603-MFR-25FBF52-2R2
CR1-21 | Mouser | 1 OHM CAP ESR | MFR-25FBF52-1R | 1 |  |  |  |  | each | Controller R1 | Specified · listed by supplier | https://www.mouser.com/c/?q=603-MFR-25FBF52-1R |  | R10; Resistor_THT:R_Axial_DIN0207_L6.3mm_D2.5mm_P7.62mm_Horizontal. Builder assembly through-hole; Pico is a factory-assembled module. Check stock when ordering. | Saved-board BOM reconciled 2026-11-07; exact Mouser SKU 603-MFR-25FBF52-1R
CR1-22 | Mouser | 2k2 ARM GATE | MFR-25FBF52-2K2 | 4 |  |  |  |  | each | Controller R1 | Specified · listed by supplier | https://www.mouser.com/c/?q=603-MFR-25FBF52-2K2 |  | R11, R12, R15, R16; Resistor_THT:R_Axial_DIN0207_L6.3mm_D2.5mm_P7.62mm_Horizontal. Builder assembly through-hole; Pico is a factory-assembled module. Check stock when ordering. | Saved-board BOM reconciled 2026-11-07; exact Mouser SKU 603-MFR-25FBF52-2K2
CR1-23 | Mouser | IRLZ44N / HARD DISCHARGE | IRLZ44NPBF | 1 |  |  |  |  | each | Controller R1 | Specified · listed by supplier | https://www.mouser.com/c/?q=942-IRLZ44NPBF |  | Q1; Package_TO_SOT_THT:TO-220-3_Vertical. Builder assembly through-hole; Pico is a factory-assembled module. Check stock when ordering. | Saved-board BOM reconciled 2026-11-07; exact Mouser SKU 942-IRLZ44NPBF
CR1-24 | Mouser | 22uF 16V / OUTPUT | EEU-FC1C220 | 2 |  |  |  |  | each | Controller R1 | Specified · listed by supplier | https://www.mouser.com/c/?q=667-EEU-FC1C220 |  | C6, C17; Capacitor_THT:CP_Radial_D5.0mm_P2.00mm. Builder assembly through-hole; Pico is a factory-assembled module. Check stock when ordering. | Saved-board BOM reconciled 2026-11-07; exact Mouser SKU 667-EEU-FC1C220
CR1-25 | Mouser | 1uF 50V X7R | C330C105K5R5TA | 1 |  |  |  |  | each | Controller R1 | Specified · listed by supplier | https://www.mouser.com/c/?q=80-C330C105K5R |  | C9; Drive:KEMET_C340_P5.08. Builder assembly through-hole; Pico is a factory-assembled module. Check stock when ordering. | Saved-board BOM reconciled 2026-11-07; exact Mouser SKU 80-C330C105K5R
CR1-26 | Mouser | SUP53P06 / MEDIA INPUT CUT | SUP53P06-20-E3 | 1 |  |  |  |  | each | Controller R1 | Specified · listed by supplier | https://www.mouser.com/c/?q=781-SUP53P06-20-E3 |  | Q9; Package_TO_SOT_THT:TO-220-3_Vertical. Builder assembly through-hole; Pico is a factory-assembled module. Check stock when ordering. | Saved-board BOM reconciled 2026-11-07; exact Mouser SKU 781-SUP53P06-20-E3
CR1-27 | Mouser | LM386N-1 / SAMPLE AUDIO | LM386N-1/NOPB | 1 |  |  |  |  | each | Controller R1 | Specified · listed by supplier | https://www.mouser.com/c/?q=926-LM386N-1/NOPB |  | U7; Package_DIP:DIP-8_W7.62mm. Builder assembly through-hole; Pico is a factory-assembled module. Check stock when ordering. | Saved-board BOM reconciled 2026-11-07; exact Mouser SKU 926-LM386N-1/NOPB
CR1-28 | Mouser | 47k AUDIO ATTENUATOR | MFR-25FBF52-47K | 1 |  |  |  |  | each | Controller R1 | Specified · listed by supplier | https://www.mouser.com/c/?q=603-MFR-25FBF52-47K |  | R14; Resistor_THT:R_Axial_DIN0207_L6.3mm_D2.5mm_P7.62mm_Horizontal. Builder assembly through-hole; Pico is a factory-assembled module. Check stock when ordering. | Saved-board BOM reconciled 2026-11-07; exact Mouser SKU 603-MFR-25FBF52-47K
CR1-29 | Mouser | 10R AUDIO STABILITY | MFR-25FBF52-10R | 1 |  |  |  |  | each | Controller R1 | Specified · listed by supplier | https://www.mouser.com/c/?q=603-MFR-25FBF52-10R |  | R17; Resistor_THT:R_Axial_DIN0207_L6.3mm_D2.5mm_P7.62mm_Horizontal. Builder assembly through-hole; Pico is a factory-assembled module. Check stock when ordering. | Saved-board BOM reconciled 2026-11-07; exact Mouser SKU 603-MFR-25FBF52-10R
CR1-30 | Mouser | 22nF AUDIO LP1 | C315C223K5R5TA | 2 |  |  |  |  | each | Controller R1 | Specified · listed by supplier | https://www.mouser.com/c/?q=80-C315C223K5R |  | C10, C11; Drive:KEMET_C315_P2.54. Builder assembly through-hole; Pico is a factory-assembled module. Check stock when ordering. | Saved-board BOM reconciled 2026-11-07; exact Mouser SKU 80-C315C223K5R
CR1-31 | Mouser | 100uF 16V / SPEAKER DC BLOCK | EEU-FC1C101 | 1 |  |  |  |  | each | Controller R1 | Specified · listed by supplier | https://www.mouser.com/c/?q=667-EEU-FC1C101 |  | C13; Capacitor_THT:CP_Radial_D6.3mm_P2.50mm. Builder assembly through-hole; Pico is a factory-assembled module. Check stock when ordering. | Saved-board BOM reconciled 2026-11-07; exact Mouser SKU 667-EEU-FC1C101
DR3-01 | Mouser | Pico 2 / internal USB jumper | SC1632 |  |  |  |  | 1 | each | Daughterboard R3 | Specified · listed by supplier | https://www.mouser.com/c/?q=358-SC1632 |  | A1; Module:RaspberryPi_Pico_Common_THT. Builder assembly through-hole; Pico is a factory-assembled module. Check stock when ordering. | Saved-board BOM reconciled 2026-11-07; exact Mouser SKU 358-SC1632
DR3-02 | Mouser | SN74LVC245AN | SN74LVC245AN |  |  |  |  | 3 | each | Daughterboard R3 | Specified · listed by supplier | https://www.mouser.com/c/?q=595-SN74LVC245AN |  | U1, U4, U5; Package_DIP:DIP-20_W7.62mm. Builder assembly through-hole; Pico is a factory-assembled module. Check stock when ordering. | Saved-board BOM reconciled 2026-11-07; exact Mouser SKU 595-SN74LVC245AN
DR3-03 | Mouser | TN0702 / IEC CLK | TN0702N3-G |  |  |  |  | 3 | each | Daughterboard R3 | Specified · listed by supplier | https://www.mouser.com/c/?q=689-TN0702N3-G |  | Q2, Q3, Q4; Package_TO_SOT_THT:TO-92_Inline. Builder assembly through-hole; Pico is a factory-assembled module. Check stock when ordering. | Saved-board BOM reconciled 2026-11-07; exact Mouser SKU 689-TN0702N3-G
DR3-04 | Mouser | MAX232N / 5V RS232 | MAX232N |  |  |  |  | 1 | each | Daughterboard R3 | Specified · listed by supplier | https://www.mouser.com/c/?q=595-MAX232N |  | U3; Package_DIP:DIP-16_W7.62mm. Builder assembly through-hole; Pico is a factory-assembled module. Check stock when ordering. | Saved-board BOM reconciled 2026-11-07; exact Mouser SKU 595-MAX232N
DR3-05 | Mouser | SN74AHCT125N / LED + serial TX | SN74AHCT125N |  |  |  |  | 1 | each | Daughterboard R3 | Specified · listed by supplier | https://www.mouser.com/c/?q=595-SN74AHCT125N |  | U6; Package_DIP:DIP-14_W7.62mm. Builder assembly through-hole; Pico is a factory-assembled module. Check stock when ordering. | Saved-board BOM reconciled 2026-11-07; exact Mouser SKU 595-SN74AHCT125N
DR3-06 | Mouser | IEC / Switchcraft sequential pin numbers | 61PC6F |  |  |  |  | 1 | each | Daughterboard R3 | Specified · listed by supplier | https://www.mouser.com/c/?q=502-61PC6F |  | J1; Dock:DIN_61PC6F. Builder assembly through-hole; Pico is a factory-assembled module. Check stock when ordering. | Saved-board BOM reconciled 2026-11-07; exact Mouser SKU 502-61PC6F
DR3-07 | Mouser | DE9 female DCE | 09661527612 |  |  |  |  | 1 | each | Daughterboard R3 | Specified · listed by supplier | https://www.mouser.com/c/?q=617-09-66-152-7612 |  | J2; Dock:DE9_09661527612. Builder assembly through-hole; Pico is a factory-assembled module. Check stock when ordering. | Saved-board BOM reconciled 2026-11-07; exact Mouser SKU 617-09-66-152-7612
DR3-08 | Mouser | ACCESSORY SPI / 3V3 SIGNALS / NO POWER | 61202021721 |  |  |  |  | 1 | each | Daughterboard R3 | Specified · listed by supplier | https://www.mouser.com/c/?q=710-61202021721 |  | J3; Dock:WR_BHD_61202021721. Builder assembly through-hole; Pico is a factory-assembled module. Check stock when ordering. | Saved-board BOM reconciled 2026-11-07; exact Mouser SKU 710-61202021721
DR3-09 | Mouser | USB-B / HOST INPUT | 61729-0010BLF |  |  |  |  | 1 | each | Daughterboard R3 | Specified · listed by supplier | https://www.mouser.com/c/?q=649-61729-0010BLF |  | J9; Dock:USB_B_61729. Builder assembly through-hole; Pico is a factory-assembled module. Check stock when ordering. | Saved-board BOM reconciled 2026-11-07; exact Mouser SKU 649-61729-0010BLF
DR3-10 | Mouser | INTERNAL ONLY / TO PICO | 67643-0910 |  |  |  |  | 1 | each | Daughterboard R3 | Specified · listed by supplier | https://www.mouser.com/c/?q=538-67643-0910 |  | J10; Connector_USB:USB_A_Molex_67643_Horizontal. Builder assembly through-hole; Pico is a factory-assembled module. Check stock when ordering. | Saved-board BOM reconciled 2026-11-07; exact Mouser SKU 538-67643-0910
DR3-11 | Mouser | CORE J4 / SIGNALS ONLY | 61201021621 |  |  |  |  | 1 | each | Daughterboard R3 | Specified · listed by supplier | https://www.mouser.com/c/?q=710-61201021621 |  | J4; Connector_IDC:IDC-Header_2x05_P2.54mm_Vertical. Builder assembly through-hole; Pico is a factory-assembled module. Check stock when ordering. | Saved-board BOM reconciled 2026-11-07; exact Mouser SKU 710-61201021621
DR3-12 | Mouser | 5V ONLY / CENTRE + | PJ-102AH |  |  |  |  | 1 | each | Daughterboard R3 | Specified · listed by supplier | https://www.mouser.com/c/?q=490-PJ-102AH |  | J5; Dock:BarrelJack_PJ102AH_2024. Builder assembly through-hole; Pico is a factory-assembled module. Check stock when ordering. | Saved-board BOM reconciled 2026-11-07; exact Mouser SKU 490-PJ-102AH
DR3-13 | Mouser | 2A fast / input | 0251002.MXL |  |  |  |  | 1 | each | Daughterboard R3 | Specified · listed by supplier | https://www.mouser.com/c/?q=576-0251002.MXL |  | F1; Resistor_THT:R_Axial_DIN0309_L9.0mm_D3.2mm_P12.70mm_Horizontal. Builder assembly through-hole; Pico is a factory-assembled module. Check stock when ordering. | Saved-board BOM reconciled 2026-11-07; exact Mouser SKU 576-0251002.MXL
DR3-14 | Mouser | SUP53P06-20-E3 / reverse polarity | SUP53P06-20-E3 |  |  |  |  | 1 | each | Daughterboard R3 | Specified · listed by supplier | https://www.mouser.com/c/?q=781-SUP53P06-20-E3 |  | Q1; Package_TO_SOT_THT:TO-220-3_Vertical. Builder assembly through-hole; Pico is a factory-assembled module. Check stock when ordering. | Saved-board BOM reconciled 2026-11-07; exact Mouser SKU 781-SUP53P06-20-E3
DR3-15 | Mouser | CORE BERG 5V / 12V NC | TSW-102-07-G-S |  |  |  |  | 2 | each | Daughterboard R3 | Specified · listed by supplier | https://www.mouser.com/c/?q=200-TSW10207GS |  | J6, J8; Connector_PinHeader_2.54mm:PinHeader_1x02_P2.54mm_Vertical. Builder assembly through-hole; Pico is a factory-assembled module. Check stock when ordering. | Saved-board BOM reconciled 2026-11-07; exact Mouser SKU 200-TSW10207GS
DR3-16 | Mouser | LED STRIP 5V / 0.2A MAX | TSW-103-07-G-S |  |  |  |  | 1 | each | Daughterboard R3 | Specified · listed by supplier | https://www.mouser.com/c/?q=200-TSW10307GS |  | J7; Connector_PinHeader_2.54mm:PinHeader_1x03_P2.54mm_Vertical. Builder assembly through-hole; Pico is a factory-assembled module. Check stock when ordering. | Saved-board BOM reconciled 2026-11-07; exact Mouser SKU 200-TSW10307GS
DR3-17 | Mouser | 1N5819 / VSYS feed only | 1N5819-E3/54 |  |  |  |  | 1 | each | Daughterboard R3 | Specified · listed by supplier | https://www.mouser.com/c/?q=625-1N5819-E3 |  | D1; Diode_THT:D_DO-41_SOD81_P10.16mm_Horizontal. Builder assembly through-hole; Pico is a factory-assembled module. Check stock when ordering. | Saved-board BOM reconciled 2026-11-07; exact Mouser SKU 625-1N5819-E3
DR3-18 | Mouser | 1uF 50V nonpolar | C330C105K5R5TA |  |  |  |  | 4 | each | Daughterboard R3 | Specified · listed by supplier | https://www.mouser.com/c/?q=80-C330C105K5R |  | C1, C2, C3, C4; Dock:C330_P5.08. Builder assembly through-hole; Pico is a factory-assembled module. Check stock when ordering. | Saved-board BOM reconciled 2026-11-07; exact Mouser SKU 80-C330C105K5R
DR3-19 | Mouser | 100nF 50V | C315C104M5U5TA |  |  |  |  | 6 | each | Daughterboard R3 | Specified · listed by supplier | https://www.mouser.com/c/?q=80-C315C104M5U |  | C5, C7, C8, C9, C10, C11; Dock:C315_P2.54. Builder assembly through-hole; Pico is a factory-assembled module. Check stock when ordering. | Saved-board BOM reconciled 2026-11-07; exact Mouser SKU 80-C315C104M5U
DR3-20 | Mouser | 100uF 16V | EEU-FR1C101 |  |  |  |  | 1 | each | Daughterboard R3 | Specified · listed by supplier | https://www.mouser.com/c/?q=667-EEU-FR1C101 |  | C12; Capacitor_THT:CP_Radial_D6.3mm_P2.50mm. Builder assembly through-hole; Pico is a factory-assembled module. Check stock when ordering. | Saved-board BOM reconciled 2026-11-07; exact Mouser SKU 667-EEU-FR1C101
DR3-21 | Mouser | 1000uF 10V LED bulk | EEU-FR1A102 |  |  |  |  | 1 | each | Daughterboard R3 | Specified · listed by supplier | https://www.mouser.com/c/?q=667-EEU-FR1A102 |  | C13; Capacitor_THT:CP_Radial_D10.0mm_P5.00mm. Builder assembly through-hole; Pico is a factory-assembled module. Check stock when ordering. | Saved-board BOM reconciled 2026-11-07; exact Mouser SKU 667-EEU-FR1A102
DR3-22 | Mouser | 5 x 47k IEC DISCONNECTED LOW | 4606X-101-473LF |  |  |  |  | 1 | each | Daughterboard R3 | Specified · listed by supplier | https://www.mouser.com/c/?q=652-4606X-1LF-47K |  | RN1; Resistor_THT:R_Array_SIP6. Builder assembly through-hole; Pico is a factory-assembled module. Check stock when ordering. | Saved-board BOM reconciled 2026-11-07; exact Mouser SKU 652-4606X-1LF-47K
DR3-23 | Mouser | 3 x 1k GATE boot pulldown | 4604X-101-102LF |  |  |  |  | 1 | each | Daughterboard R3 | Specified · listed by supplier | https://www.mouser.com/c/?q=652-4604X-1LF-1K |  | RN2; Resistor_THT:R_Array_SIP4. Builder assembly through-hole; Pico is a factory-assembled module. Check stock when ordering. | Saved-board BOM reconciled 2026-11-07; exact Mouser SKU 652-4604X-1LF-1K
DR3-24 | Mouser | 10k | MFR-25FBF52-10K |  |  |  |  | 7 | each | Daughterboard R3 | Specified · listed by supplier | https://www.mouser.com/c/?q=603-MFR-25FBF52-10K |  | R1, R2, R3, R5, R6, R9, R10; Resistor_THT:R_Axial_DIN0207_L6.3mm_D2.5mm_P7.62mm_Horizontal. Builder assembly through-hole; Pico is a factory-assembled module. Check stock when ordering. | Saved-board BOM reconciled 2026-11-07; exact Mouser SKU 603-MFR-25FBF52-10K
DR3-25 | Mouser | 330 | MFR-25FBF52-330R |  |  |  |  | 1 | each | Daughterboard R3 | Specified · listed by supplier | https://www.mouser.com/c/?q=603-MFR-25FBF52-330R |  | R4; Resistor_THT:R_Axial_DIN0207_L6.3mm_D2.5mm_P7.62mm_Horizontal. Builder assembly through-hole; Pico is a factory-assembled module. Check stock when ordering. | Saved-board BOM reconciled 2026-11-07; exact Mouser SKU 603-MFR-25FBF52-330R
DR3-26 | Mouser | 8 x 4k7 INPUT DEFAULTS | 4609X-101-472LF |  |  |  |  | 1 | each | Daughterboard R3 | Specified · listed by supplier | https://www.mouser.com/c/?q=652-4609X-1LF-4.7K |  | RN3; Resistor_THT:R_Array_SIP9. Builder assembly through-hole; Pico is a factory-assembled module. Check stock when ordering. | Saved-board BOM reconciled 2026-11-07; exact Mouser SKU 652-4609X-1LF-4.7K
DR3-27 | Mouser | 4k7 MARK / DEASSERT | MFR-25FBF52-4K7 |  |  |  |  | 2 | each | Daughterboard R3 | Specified · listed by supplier | https://www.mouser.com/c/?q=603-MFR-25FBF52-4K7 |  | R7, R8; Resistor_THT:R_Axial_DIN0207_L6.3mm_D2.5mm_P7.62mm_Horizontal. Builder assembly through-hole; Pico is a factory-assembled module. Check stock when ordering. | Saved-board BOM reconciled 2026-11-07; exact Mouser SKU 603-MFR-25FBF52-4K7
DR3-28 | Mouser | 1k PIEZO CURRENT LIMIT | MFR-25FBF52-1K |  |  |  |  | 1 | each | Daughterboard R3 | Specified · listed by supplier | https://www.mouser.com/c/?q=603-MFR-25FBF52-1K |  | R11; Resistor_THT:R_Axial_DIN0207_L6.3mm_D2.5mm_P7.62mm_Horizontal. Builder assembly through-hole; Pico is a factory-assembled module. Check stock when ordering. | Saved-board BOM reconciled 2026-11-07; exact Mouser SKU 603-MFR-25FBF52-1K
