lionsarmor/cyber-disk-site/site/boards/contact-r1/documents/BOM.csv

Reference | Qty | Part | Supplier | Assembly
SC1-SC7 | 7 | Harwin S7131-45R | https://www.mouser.com/ProductDetail/Harwin/S7131-45R | SMD; 3.30 x 2.80 mm land; hand solder or reflow
J1 | 1 | Phoenix Contact 1725708 / MPT 0.5/7-2.54 | https://www.mouser.com/ProductDetail/Phoenix-Contact/1725708 | Through-hole, underside; trim soldered tails to <=0.5 mm above top face. 26 AWG stranded wire, strip 4.5 mm, torque 0.12-0.15 Nm.
PCB | 1 | 18.525 x 49 x 1.6 mm FR4, two layers | PCB fabrication | R1 outline; 2 x 2.2 mm NPTH M2
