lionsarmor/cyber-disk-site/site/boards/single-r0/documents/cyber-disk-single-r0-bom.csv

References | Quantity | Value | Footprint | Suggested_MPN | Notes
U1 | 1 | 4 MiB SPI NOR | SOIC-8 5.3x5.3mm 1.27mm | W25Q32JVSSIQ | Default; optionally substitute W25Q128JVSIQ 16 MiB after verification
C1 | 1 | 100nF 16V X7R | 0805 | GRM21BR71C104KA01L | Candidate order code; confirm supplier/package/reflow spec
R1,R2,R3 | 3 | 10k 1% | 0805 | RC0805FR-0710KL | Candidate; three pull-ups per circuit
