lionsarmor/cyber-disk-site/site/boards/controller-r0/READ_BEFORE_ORDER.txt

Drive controller · R0
Unrouted · do not fabricate
Electrical R1: 1k reset/ARM defaults, buffered dock RX, 20 component positions. Still unrouted; contact isolation/interlock, power budget and firmware unfinished. Reference files only; do not manufacture.

KiCad 10 required. Stock KiCad libraries are needed in addition to bundled local libraries. ZIP contains this board only. No order is placed by downloading.
Source commit a20239f2e25a1f29534a25ecbcd7e1e4af3bcc7d
PCB SHA256 6add68c0985c42701c7ce6b39f055b023740ebd5bcd876f170098fd5c3c0395b
