lionsarmor/cyber-disk-site/site/downloads/recessed-single-assembly.step

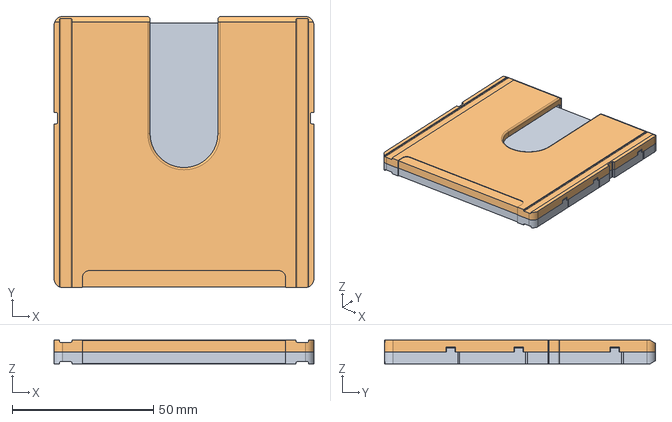
[picture p2: CAD file, 2026-11-07]
site/downloads/recessed-single-assembly.step
92.0 x 96.0 x 8.50 mm
body-lower
body-upper
