lionsarmor/cyber-disk-site/site/downloads/recessed-ab-assembly.step

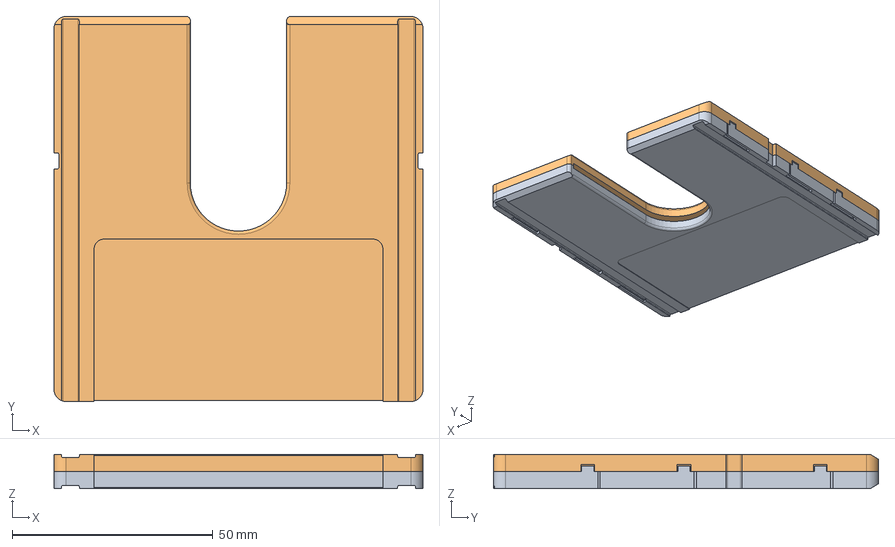
[picture p3: CAD file, 2026-11-07]
site/downloads/recessed-ab-assembly.step
92.0 x 96.0 x 8.50 mm
body-lower
body-upper
