lionsarmor/cyber-disk-site/site/downloads/deep-space-ab-assembly.step

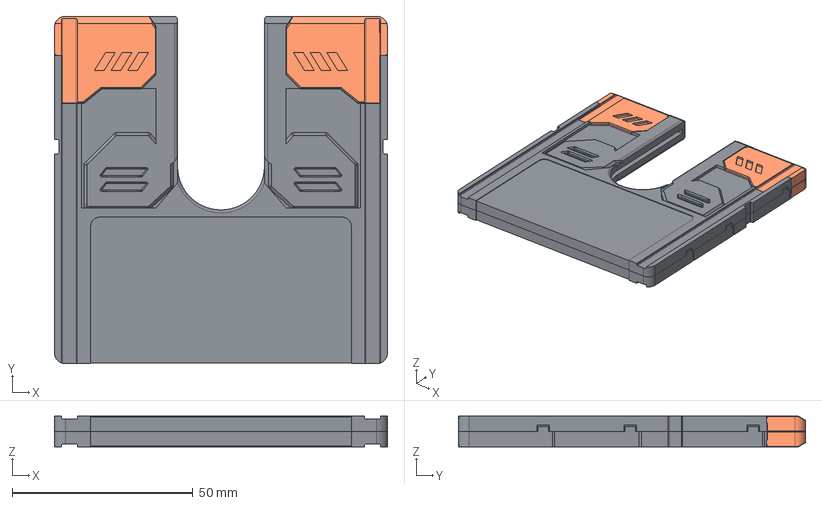
[picture p5: CAD file, 2026-11-07]
site/downloads/deep-space-ab-assembly.step
92.0 x 96.0 x 8.50 mm
body-lower
body-upper
accent-left-A
accent-left-B
accent-right-A
accent-right-B
