lionsarmor/cyber-disk-site/site/boards/contact-r1/kicad/models/Terminal7_Phoenix1725708.step

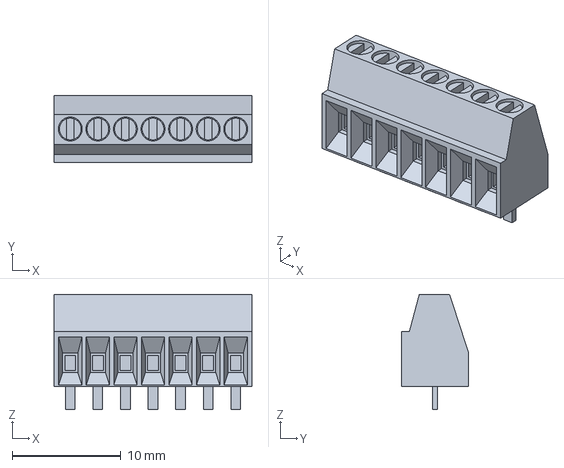
[picture p6: CAD file, 2026-11-08]
site/boards/contact-r1/kicad/models/Terminal7_Phoenix1725708.step
18.2 x 6.20 x 10.6 mm
