lionsarmor/cyber-disk-site/site/boards/controller-r1/kicad/models/KEMET-C315-envelope.step

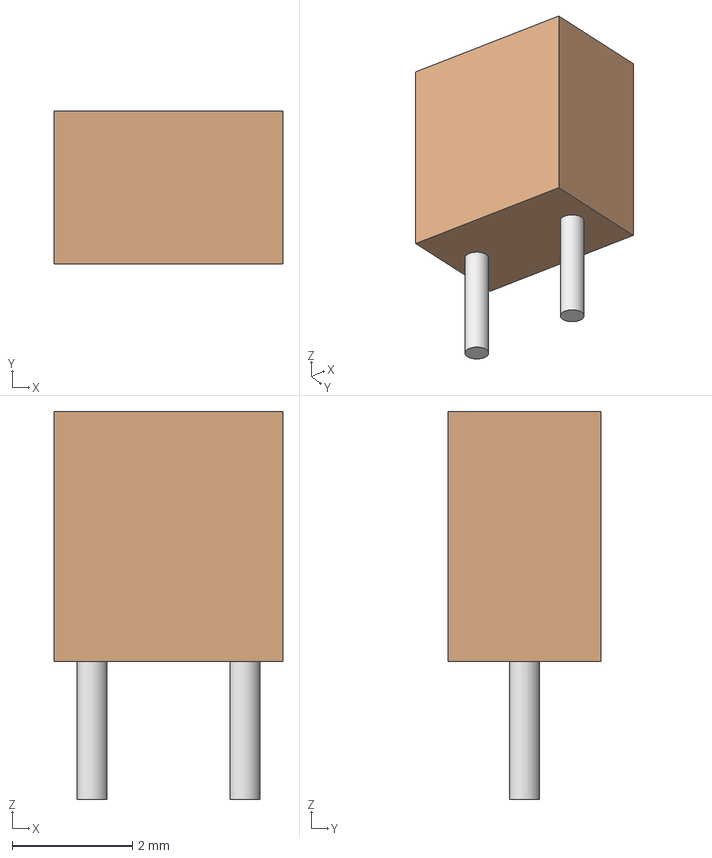
[picture p7: CAD file, 2026-11-08]
site/boards/controller-r1/kicad/models/KEMET-C315-envelope.step
3.81 x 2.54 x 6.46 mm
ceramic-body
lead-0
lead-2.54
