lionsarmor/cyber-disk-site/site/boards/external-r3/kicad/models/DE9_09661527612.step

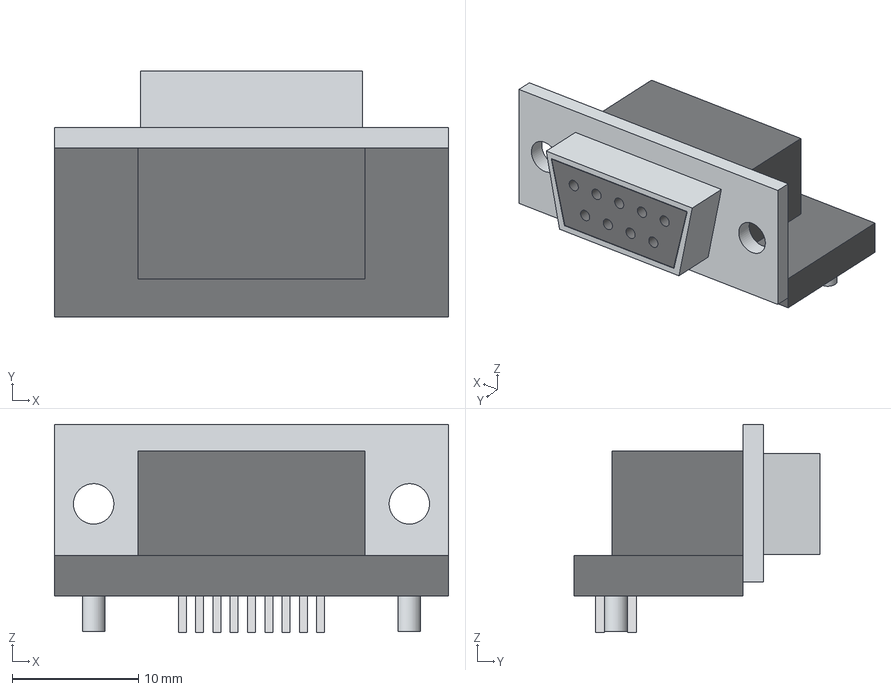
[picture p8: CAD file, 2026-11-07]
site/boards/external-r3/kicad/models/DE9_09661527612.step
31.2 x 19.5 x 16.5 mm
insulator
mounting-flange-4-40
D-shell
socket-insulator
pin-1
pin-2
pin-3
pin-4
pin-5
pin-6
pin-7
pin-8
pin-9
shell-tail-0
shell-tail-1
