lionsarmor/cyber-disk-site/site/boards/contact-r1/kicad/models/S7131-45R-envelope.step

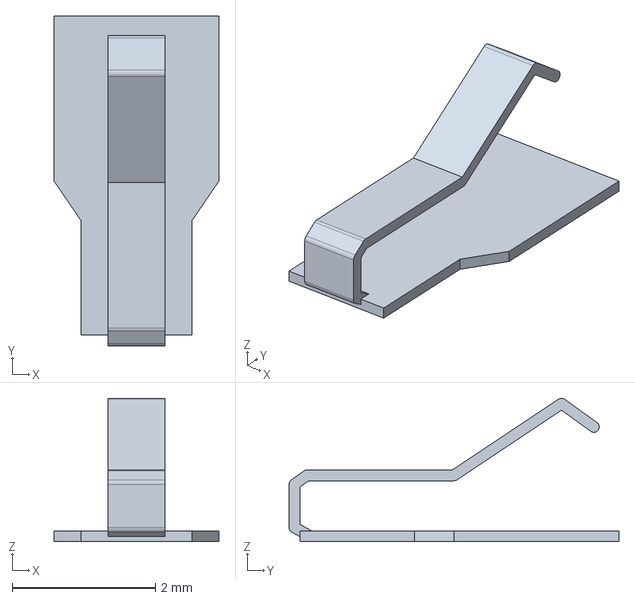
[picture p10: CAD file, 2026-11-07]
site/boards/contact-r1/kicad/models/S7131-45R-envelope.step
2.30 x 4.60 x 2.00 mm
