lionsarmor/cyber-disk-site/site/boards/external-r3/kicad/models/USB_B_61729.step

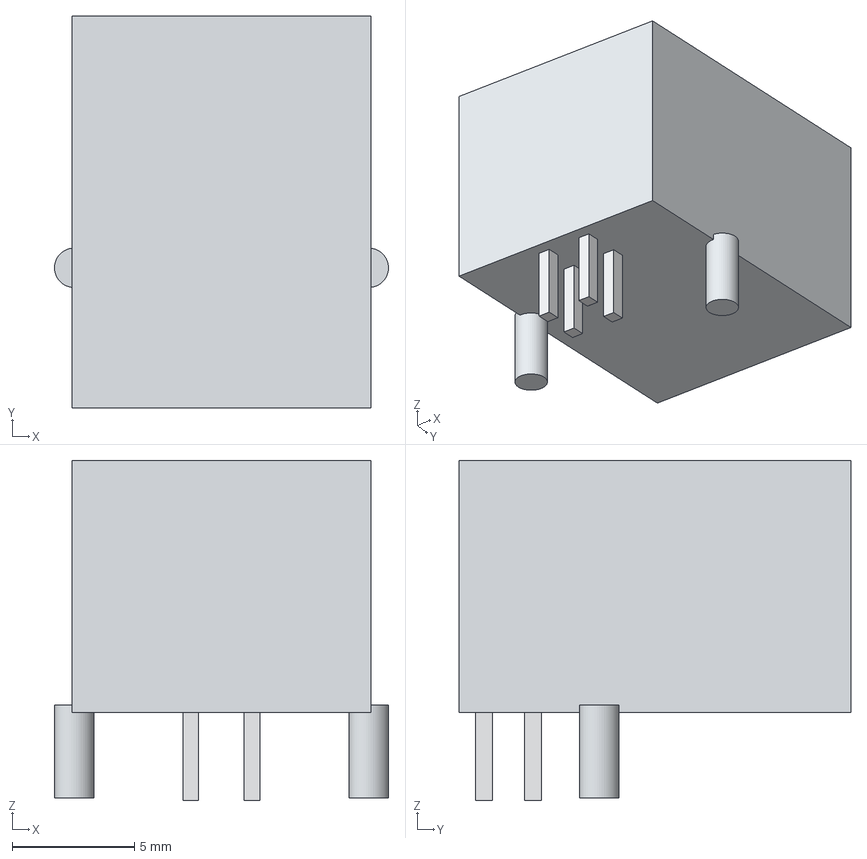
[picture p11: CAD file, 2026-11-07]
site/boards/external-r3/kicad/models/USB_B_61729.step
13.6 x 16.0 x 13.9 mm
metal-shell
insulator
pin-1
pin-2
pin-3
pin-4
shell-tail-0
shell-tail-1
