lionsarmor/cyber-disk-site/site/downloads/drive-audio-r1-15-removable-speaker-cradle.stl

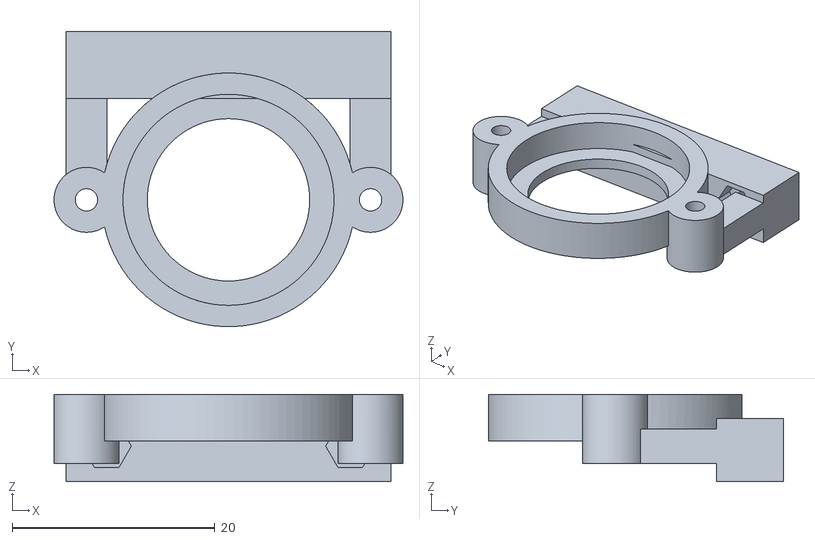
[picture p12: CAD file, 2026-11-08]
site/downloads/drive-audio-r1-15-removable-speaker-cradle.stl
34.4 x 29.1 x 8.60
