lionsarmor/cyber-disk-site/site/boards/contact-r1/kicad/models/board-outline.step

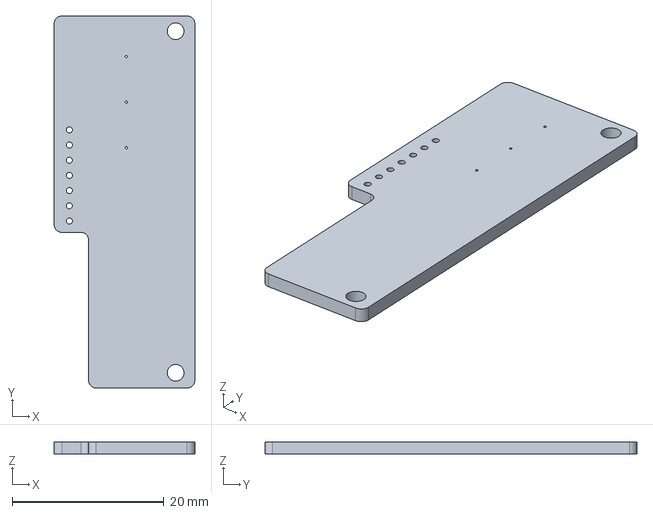
[picture p13: CAD file, 2026-11-07]
site/boards/contact-r1/kicad/models/board-outline.step
18.5 x 49.0 x 1.60 mm
