lionsarmor/cyber-disk-site/site/boards/controller-r1/kicad/models/Terminal7_Phoenix1725708.step

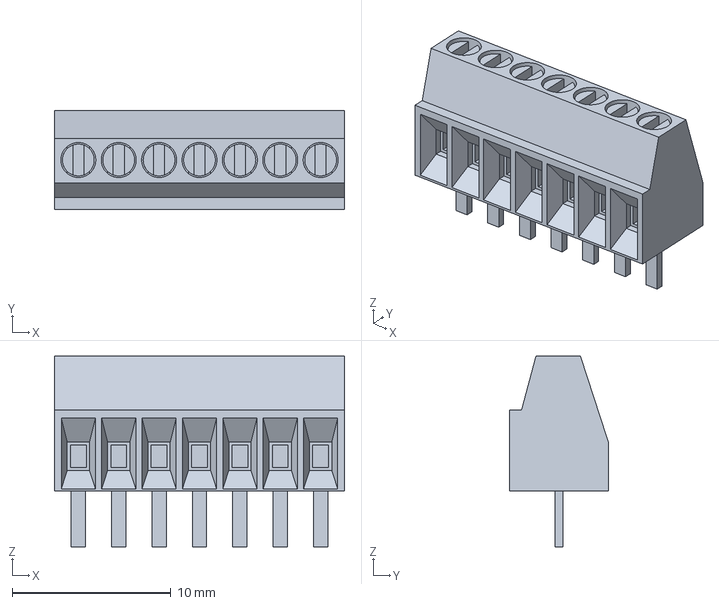
[picture p14: CAD file, 2026-11-08]
site/boards/controller-r1/kicad/models/Terminal7_Phoenix1725708.step
18.2 x 6.20 x 12.0 mm
