lionsarmor/cyber-disk-site/site/boards/external-r3/kicad/models/DIN_61PC6F.step

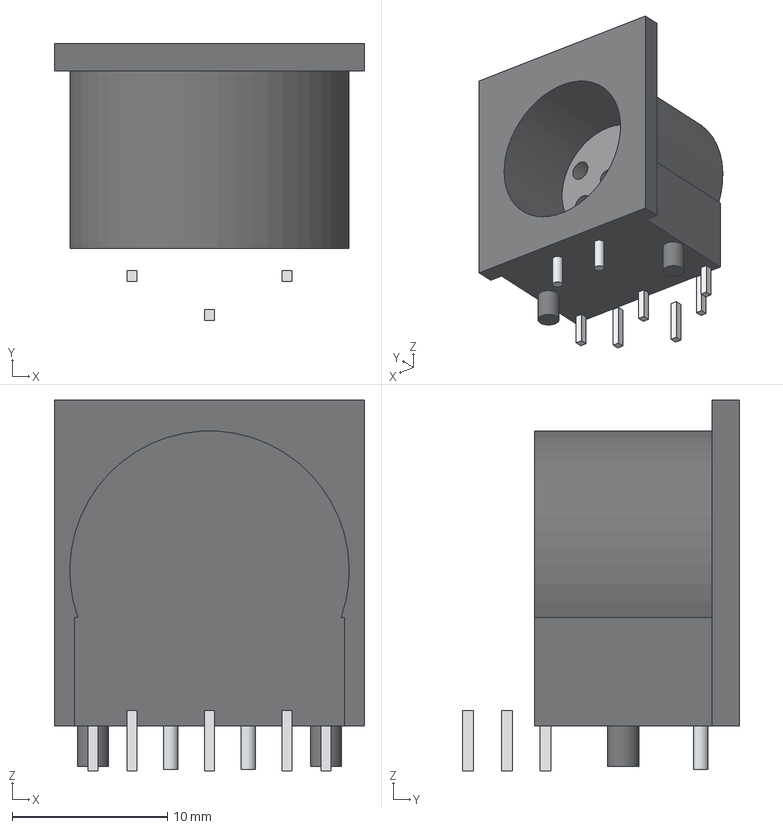
[picture p15: CAD file, 2026-11-07]
site/boards/external-r3/kicad/models/DIN_61PC6F.step
20.0 x 17.9 x 23.9 mm
DIN-housing
contact-insert
pin-1
pin-2
pin-3
pin-4
pin-5
pin-6
shell-tail-0
shell-tail-1
