lionsarmor/cyber-disk-site/site/downloads/drive-audio-r1-14-speaker-retaining-ring.stl

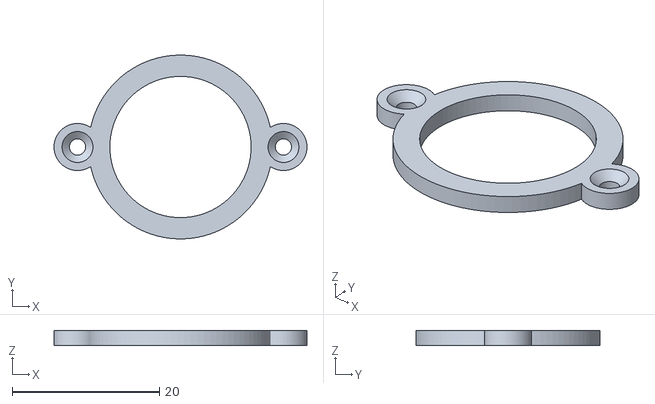
[picture p16: CAD file, 2026-11-08]
site/downloads/drive-audio-r1-14-speaker-retaining-ring.stl
34.4 x 25.0 x 2.00
