lionsarmor/cyber-disk-site/site/boards/external-r3/kicad/models/PJ102AH-envelope.step

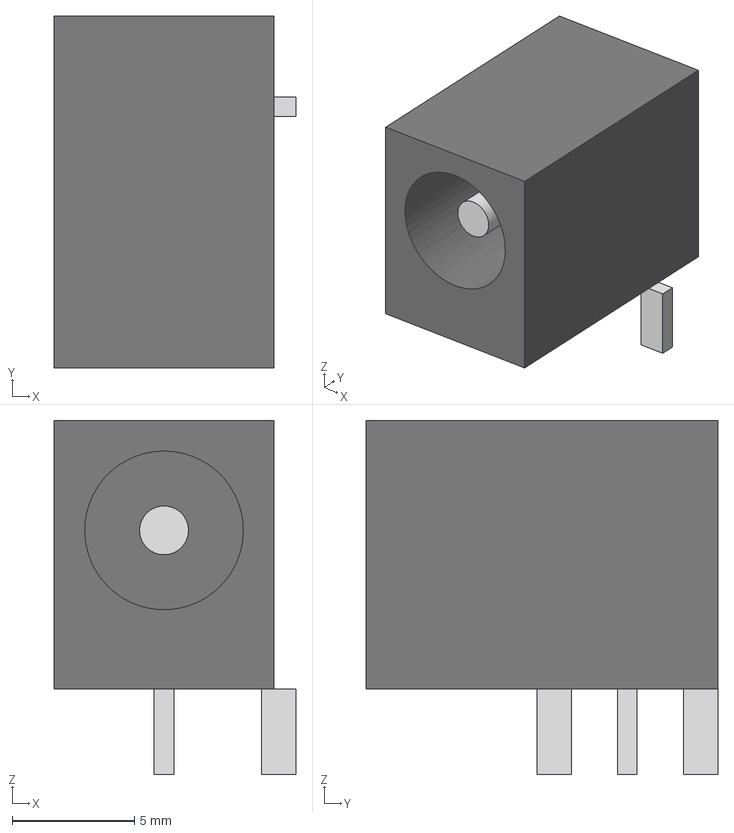
[picture p17: CAD file, 2026-11-07]
site/boards/external-r3/kicad/models/PJ102AH-envelope.step
9.90 x 14.4 x 14.5 mm
housing
centre-positive-pin
lead1
lead2
lead3
