lionsarmor/cyber-disk-site/site/downloads/drive-audio-r1-closed.step

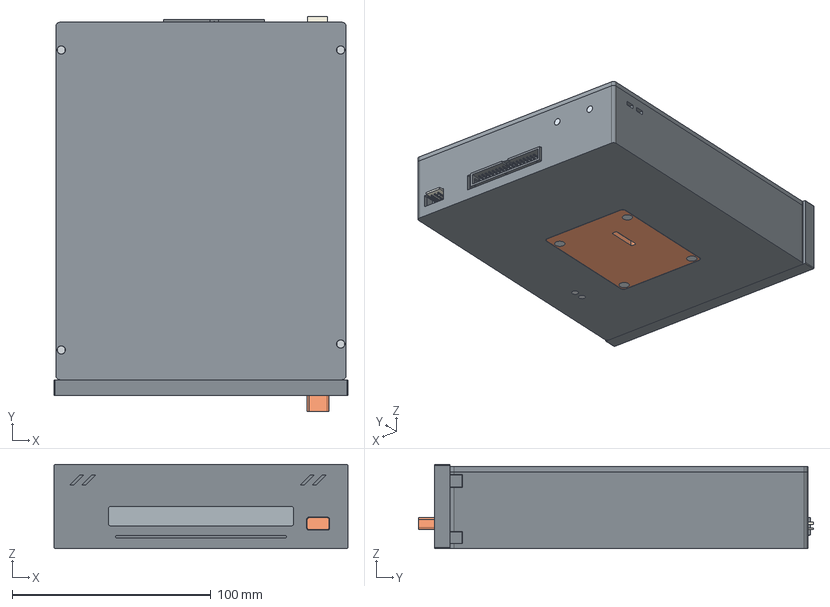
[picture p18: CAD file, 2026-11-08]
site/downloads/drive-audio-r1-closed.step
148.0 x 198.9 x 42.3 mm
15-removable-speaker-cradle
01-base-tray
02-top-cover
hinge-cap-left-M2-nut-1
hinge-cap-left-M2-screw-1
hinge-cap-left-M2-nut-2
hinge-cap-left-M2-screw-2
04b-left-hinge-bearing-cap
hinge-cap-right-M2-nut-1
hinge-cap-right-M2-screw-1
hinge-cap-right-M2-nut-2
hinge-cap-right-M2-screw-2
04b-right-hinge-bearing-cap
03-bezel
04-door-flap
flap-smooth-pivot-1
flap-bearing-spacer-R30-5001002
flap-smooth-pivot-2
flap-shaft-M3-nyloc
flap-actuator-rocker
flap-actuator-steel-follower
flap-actuator-wear-sleeve
flap-actuator-M2-nyloc
flap-torsion-coil-envelope
flap-torsion-fixed-leg-envelope
flap-torsion-moving-leg-envelope
05-left-guide
06-right-guide
disk-body-lower
disk-body-upper
disk-pcb-reference
disk-gold-contact-A
disk-gold-contact-B
pcb-main-reference
current-controller-components
floppy-power-header-TE1718264
07b-left-eject-sled
07-right-eject-sled-and-keeper
steel-rod-10.5
steel-rod-138
eject-spring-10.5
eject-spring-138
08-keyed-latch-slide
latch-steel-follower
latch-follower-lower-bush
latch-follower-upper-bush
latch-follower-M2-nyloc
09-latch-guide-block
10-sequenced-eject-slider
button-return-spring
latch-bias-coil
12-bottom-contact-cassette
pcb-contact-cartridge
harness-contact-termination-pads
harness-clamp-M2-screw-55
harness-clamp-M2-insert-55
harness-clamp-M2-screw-66
harness-clamp-M2-insert-66
13-harness-strain-clamp
harness-clamp-compliant-pad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
