lionsarmor/cyber-disk-site/site/boards/external-r3/kicad/models/C330-envelope.step

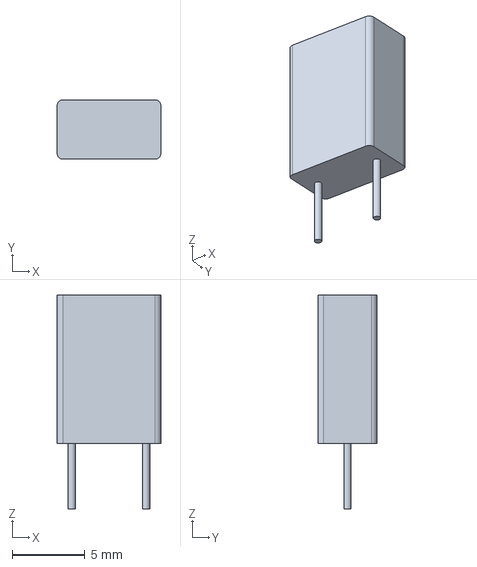
[picture p19: CAD file, 2026-11-07]
site/boards/external-r3/kicad/models/C330-envelope.step
7.11 x 4.07 x 14.7 mm
