lionsarmor/cyber-disk-site/site/downloads/pcb-controller-audio-r1.step

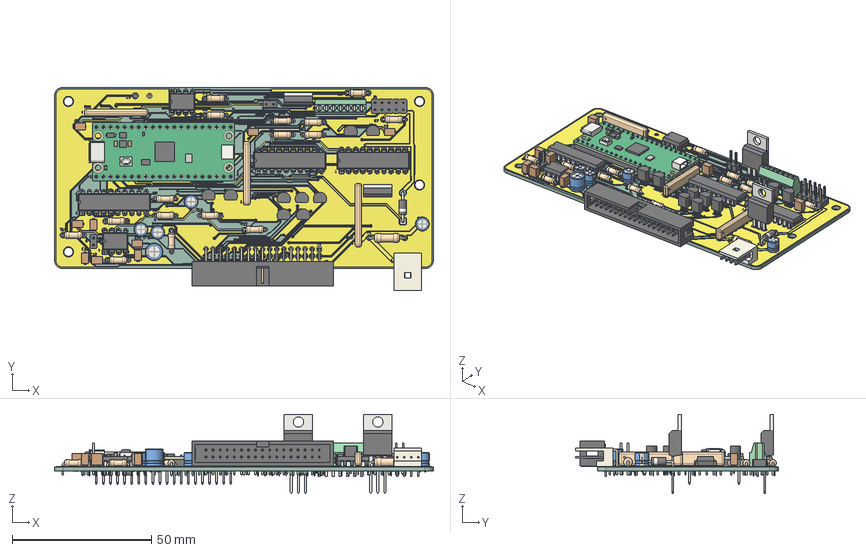
[picture p20: CAD file, 2026-11-08]
site/downloads/pcb-controller-audio-r1.step
136.0 x 72.9 x 28.5 mm
DIP-8_W7.62mm x 2
ceramic-body x 9
lead-0 x 9
lead-2.54 x 9
R_Axial_DIN0207_L63mm_D25mm_P762mm_Horizontal x 16
PinHeader_2x05_P254mm_Vertical
TO-92_Inline_Narrow x 9
TerminalBlock_Phoenix_MPT_05_7_254_1x07_P254mm_Horizontal
RaspberryPi_Pico_H_Module_KiCad
RaspberryPi_Pico_Header_DIP-40_H2.54mm_KiCad
IDC_Header_2x17_P254mm_Horizontal
TO-220-3_Vertical x 2
R_Array_SIP9 x 3
PinHeader_1x02_P254mm_Vertical x 2
CP_Radial_D50mm_P200mm x 4
D_DO-41_SOD81_P10.16mm_Horizontal
DIP-20_W7.62mm x 3
CP_Radial_D63mm_P250mm
TE1718264-floppy-power-body
TE1718264-pin-1
TE1718264-pin-2
TE1718264-pin-3
TE1718264-pin-4
R_Axial_DIN0309_L90mm_D32mm_P1270mm_Horizontal
cyber-drive-controller-r1_copper
cyber-drive-controller-r1_pad
cyber-drive-controller-r1_via
cyber-drive-controller-r1_silkscreen x 2
cyber-drive-controller-r1_PCB
