lionsarmor/cyber-disk-site/site/downloads/external-r4-01-front-chassis.stl

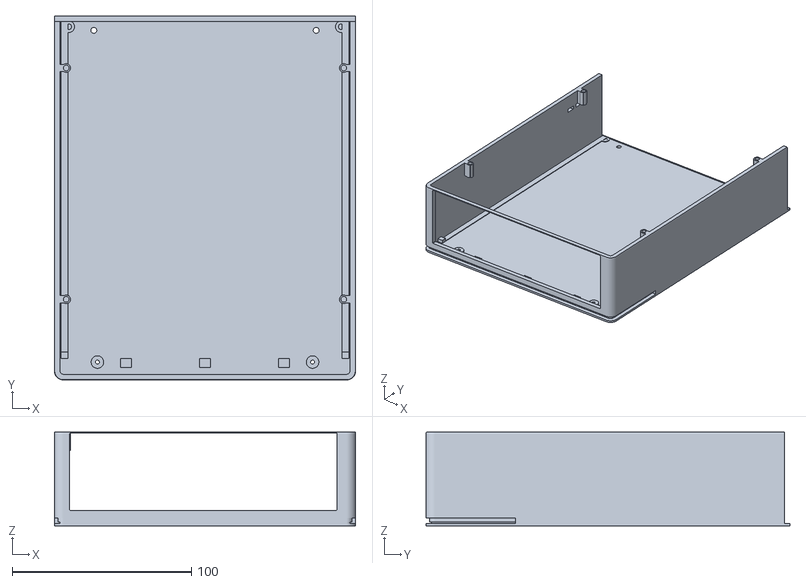
[picture p21: CAD file, 2026-11-08]
site/downloads/external-r4-01-front-chassis.stl
168.0 x 203.0 x 52.2
