lionsarmor/cyber-disk-site/site/downloads/drive-audio-r1-01-base-tray.stl

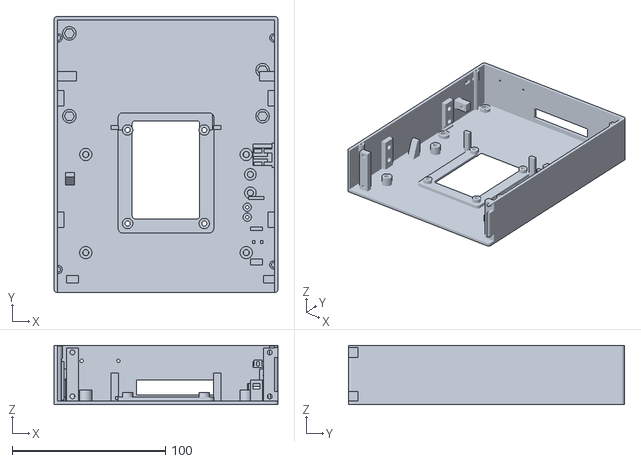
[picture p22: CAD file, 2026-11-08]
site/downloads/drive-audio-r1-01-base-tray.stl
146.1 x 180.0 x 38.5
