lionsarmor/cyber-disk-site/site/downloads/drive-audio-r1-12-bottom-contact-cassette.stl

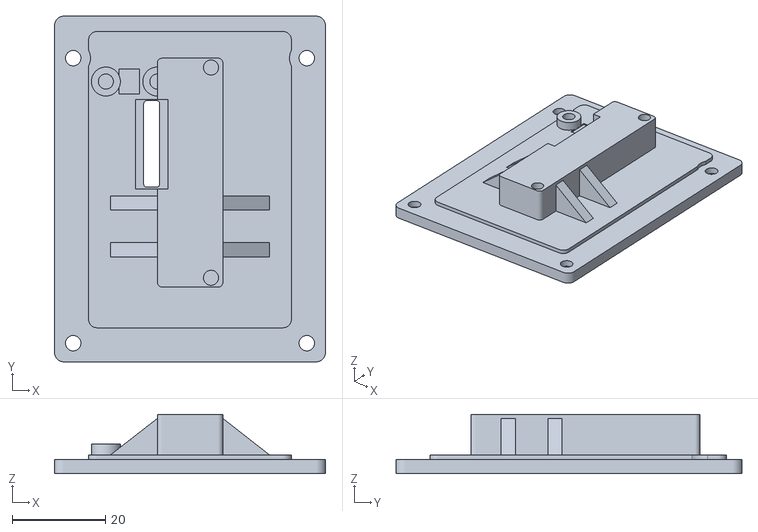
[picture p25: CAD file, 2026-11-08]
site/downloads/drive-audio-r1-12-bottom-contact-cassette.stl
58.0 x 74.0 x 12.6
