lionsarmor/cyber-disk-site/site/downloads/pcb-contact-terminals-r1.step

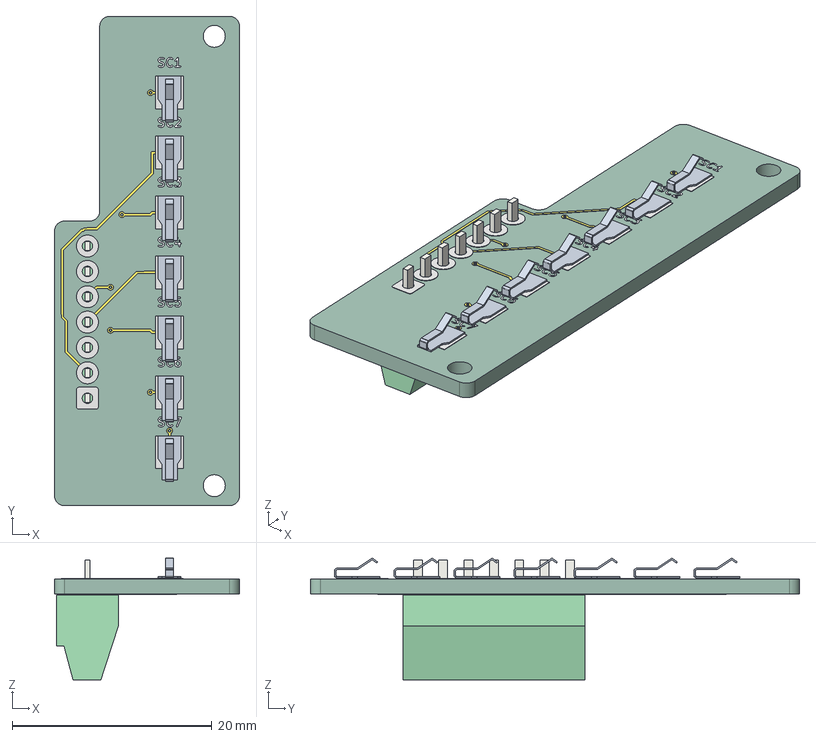
[picture p26: CAD file, 2026-11-08]
site/downloads/pcb-contact-terminals-r1.step
18.5 x 49.0 x 12.2 mm
TerminalBlock_Phoenix_MPT_05_7_254_1x07_P254mm_Horizontal
cyber-drive-contact-r1_copper
cyber-drive-contact-r1_pad
cyber-drive-contact-r1_via
cyber-drive-contact-r1_silkscreen x 2
cyber-drive-contact-r1_PCB
