lionsarmor/cyber-disk-site/site/downloads/drive-audio-r1-flap-actuator-rocker.stl

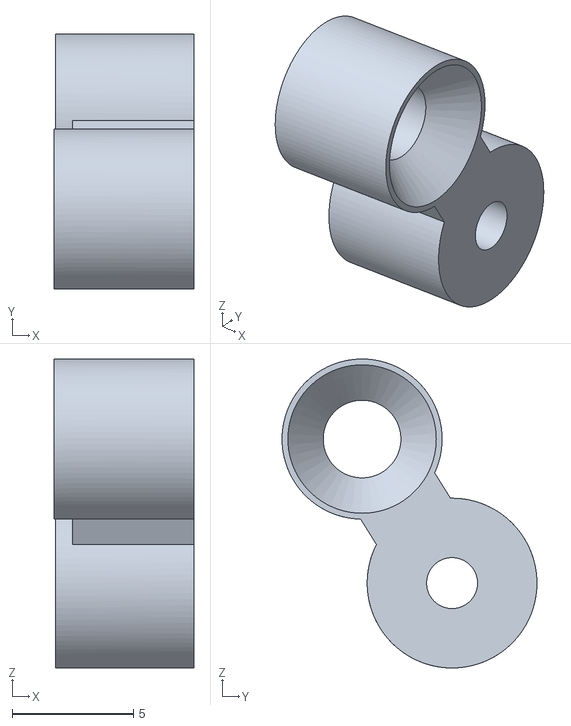
[picture p27: CAD file, 2026-11-08]
site/downloads/drive-audio-r1-flap-actuator-rocker.stl
5.75 x 10.5 x 12.7
