lionsarmor/cyber-disk-site/site/downloads/external-r4-07-daughterboard-slide-tray.stl

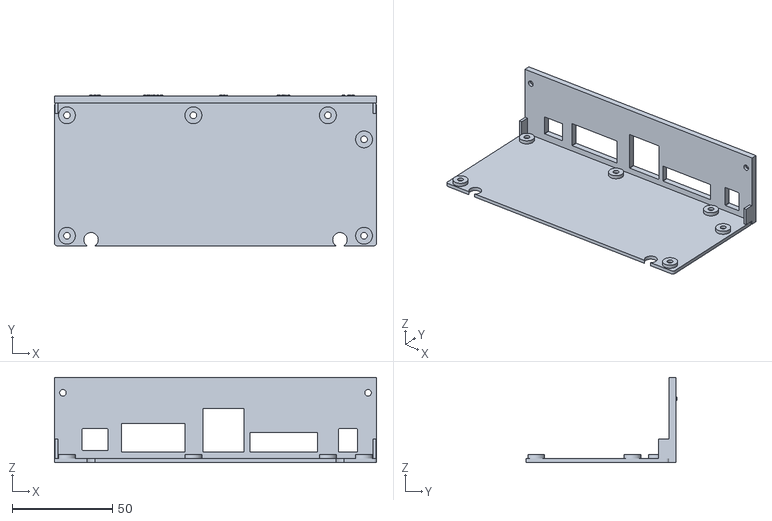
[picture p28: CAD file, 2026-11-08]
site/downloads/external-r4-07-daughterboard-slide-tray.stl
160.4 x 75.0 x 42.5
