lionsarmor/cyber-disk-site/site/downloads/drive-audio-r1-07-right-eject-sled-and-keeper.stl

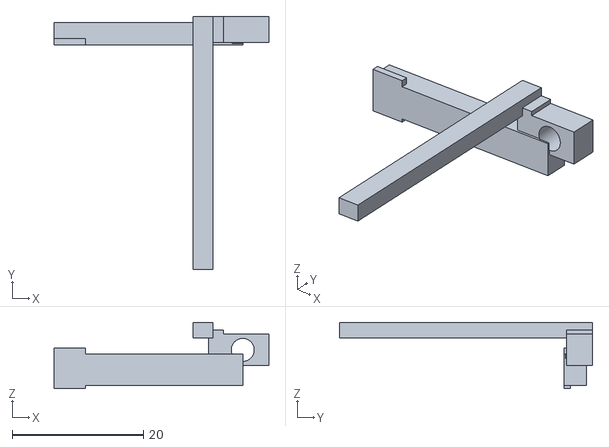
[picture p29: CAD file, 2026-11-08]
site/downloads/drive-audio-r1-07-right-eject-sled-and-keeper.stl
32.8 x 38.6 x 10.1
