lionsarmor/cyber-disk-site/site/downloads/external-r4-11-rear-lid.stl

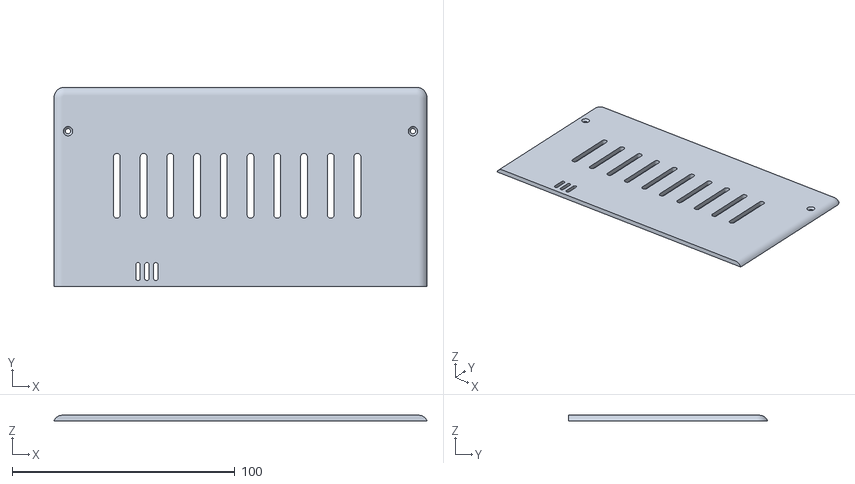
[picture p30: CAD file, 2026-11-08]
site/downloads/external-r4-11-rear-lid.stl
167.4 x 89.5 x 2.50
