lionsarmor/cyber-disk-site/site/downloads/external-r4-10-front-lid.stl

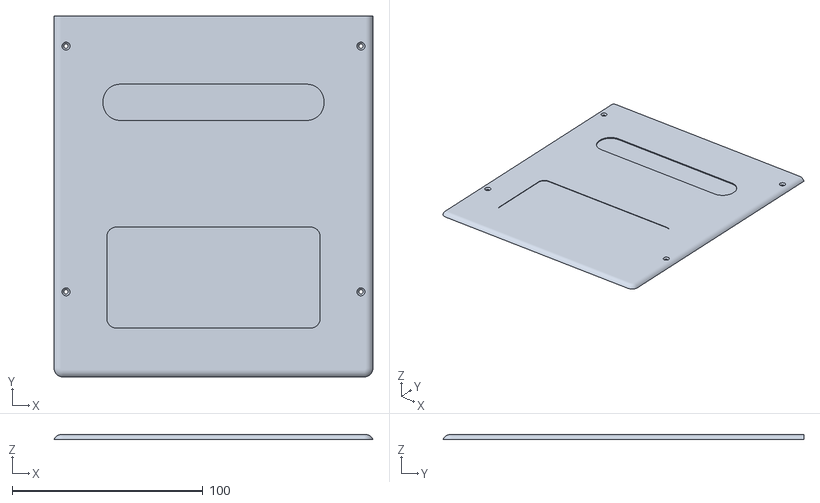
[picture p31: CAD file, 2026-11-08]
site/downloads/external-r4-10-front-lid.stl
167.4 x 189.5 x 2.50
