lionsarmor/cyber-disk-site/site/downloads/drive-audio-r1-03-bezel.stl

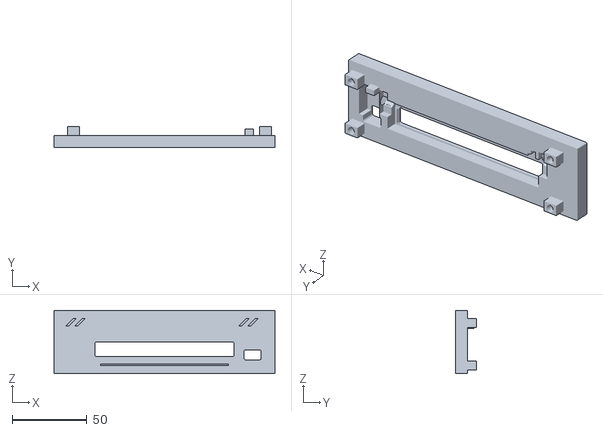
[picture p32: CAD file, 2026-11-08]
site/downloads/drive-audio-r1-03-bezel.stl
148.0 x 14.0 x 42.3
