lionsarmor/cyber-disk-site/site/downloads/drive-audio-r1-04b-right-hinge-bearing-cap.stl

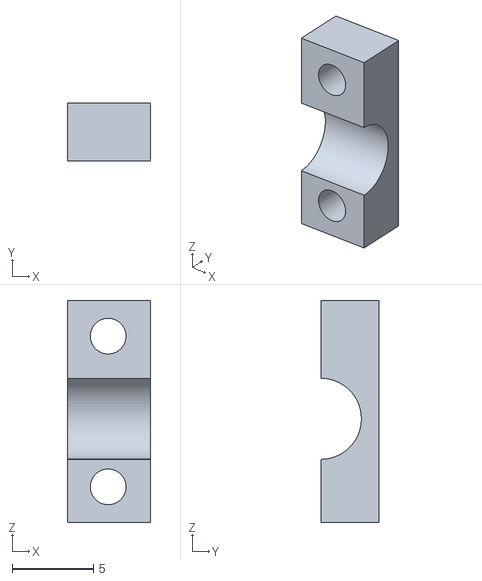
[picture p34: CAD file, 2026-11-08]
site/downloads/drive-audio-r1-04b-right-hinge-bearing-cap.stl
5.10 x 3.60 x 13.7
