lionsarmor/cyber-disk-site/site/downloads/external-r4-piezo-retaining-cap.stl

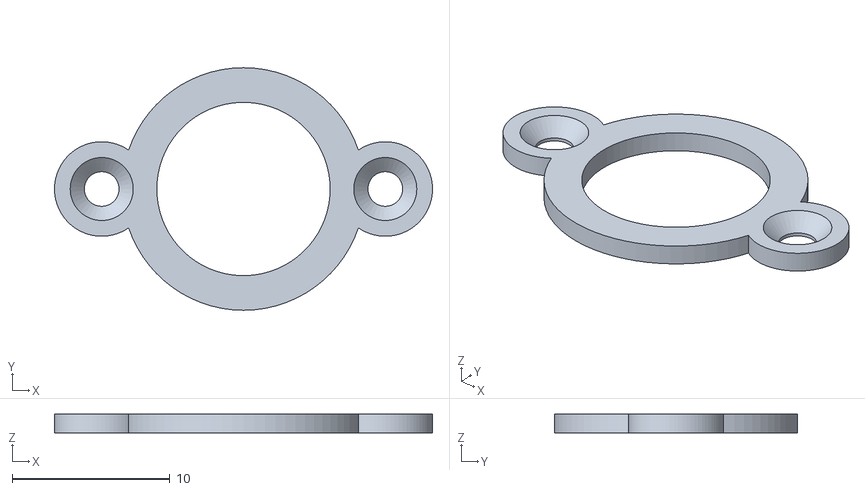
[picture p35: CAD file, 2026-11-08]
site/downloads/external-r4-piezo-retaining-cap.stl
24.0 x 15.4 x 1.20
