lionsarmor/cyber-disk-site/site/downloads/external-r4-02-rear-chassis.stl

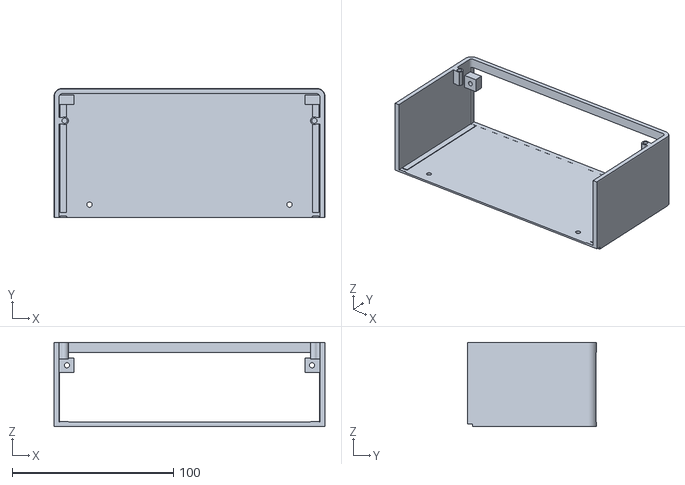
[picture p36: CAD file, 2026-11-08]
site/downloads/external-r4-02-rear-chassis.stl
168.0 x 80.0 x 52.2
