lionsarmor/cyber-disk-site/site/downloads/external-r4-05-lightwell.stl

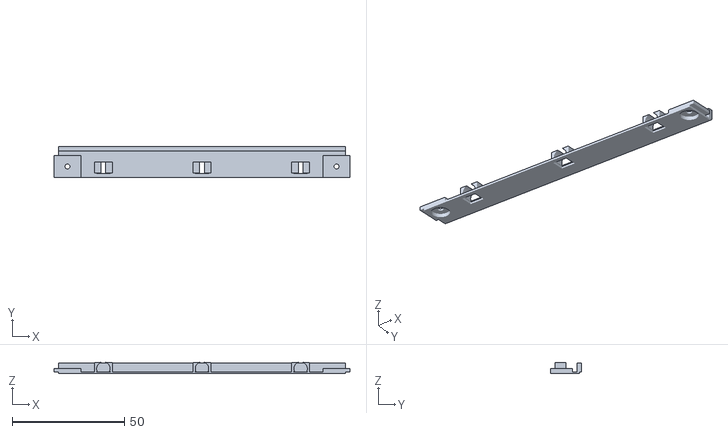
[picture p37: CAD file, 2026-11-08]
site/downloads/external-r4-05-lightwell.stl
132.0 x 14.0 x 5.00
