lionsarmor/cyber-disk-site/site/downloads/pcb-single-hardware-r3.step

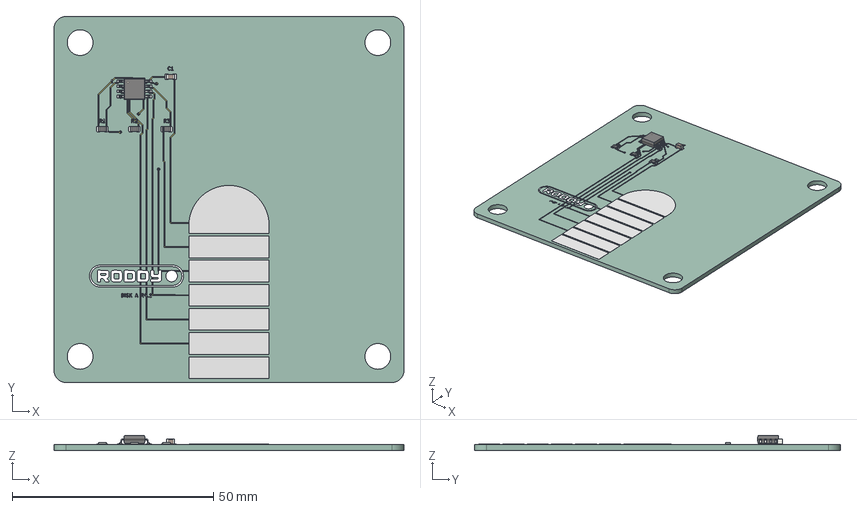
[picture p38: CAD file, 2026-11-08]
site/downloads/pcb-single-hardware-r3.step
87.0 x 91.0 x 3.79 mm
SOIC-8_5.3x5.3mm_P1.27mm
R_0805_2012Metric x 3
C_0805_2012Metric
cyber-disk-single-r4_copper
cyber-disk-single-r4_pad
cyber-disk-single-r4_via
cyber-disk-single-r4_silkscreen
cyber-disk-single-r4_PCB
