lionsarmor/cyber-disk-site/site/downloads/drive-audio-r1-09-latch-guide-block.stl

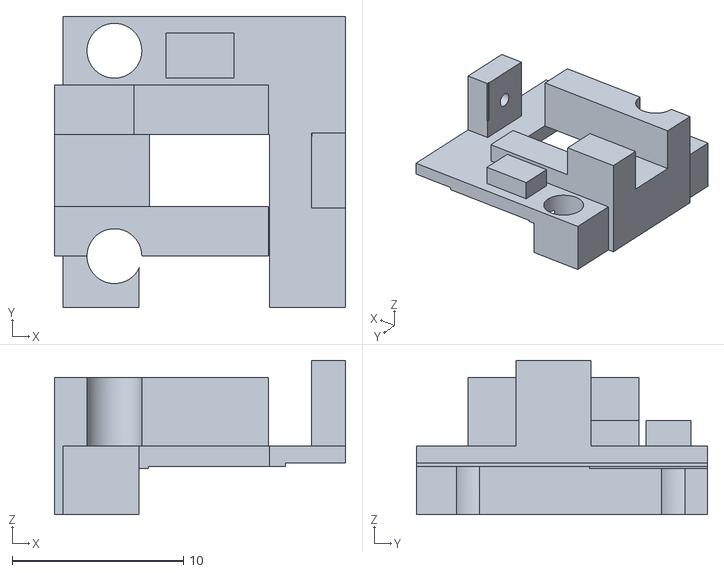
[picture p39: CAD file, 2026-11-08]
site/downloads/drive-audio-r1-09-latch-guide-block.stl
17.0 x 17.0 x 9.00
