lionsarmor/cyber-disk-site/site/downloads/drive-audio-r1-10-sequenced-eject-slider.stl

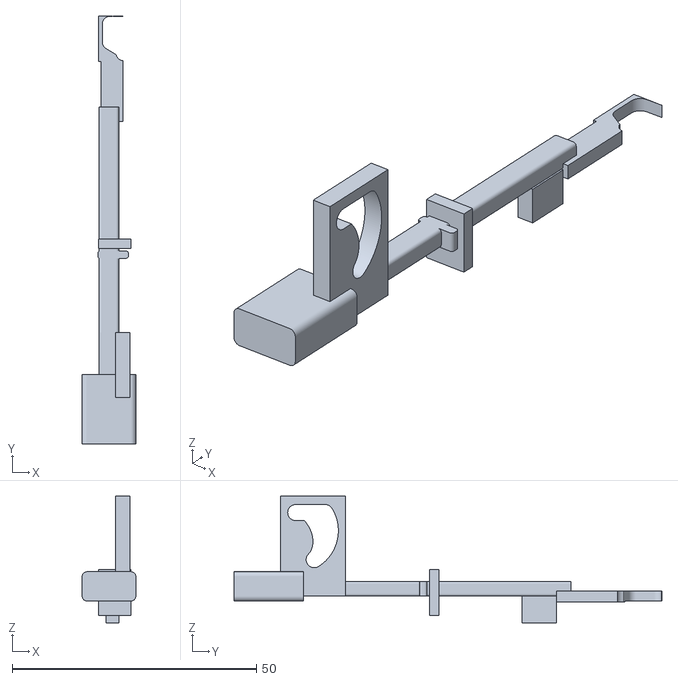
[picture p40: CAD file, 2026-11-08]
site/downloads/drive-audio-r1-10-sequenced-eject-slider.stl
11.0 x 87.6 x 26.0
