lionsarmor/cyber-disk-site/site/downloads/drive-audio-r1-08-keyed-latch-slide.stl

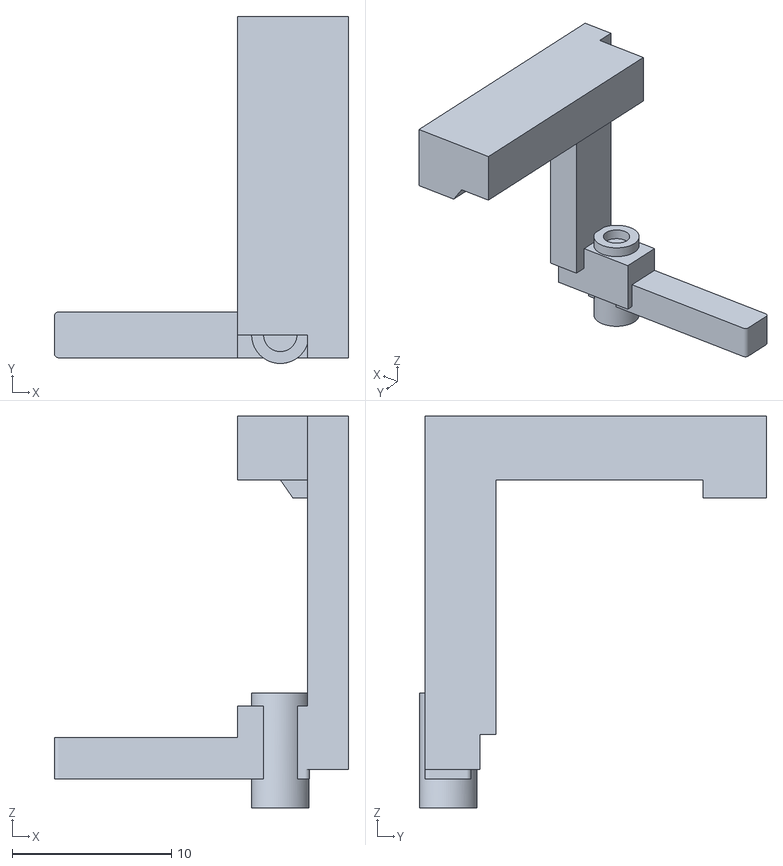
[picture p41: CAD file, 2026-11-08]
site/downloads/drive-audio-r1-08-keyed-latch-slide.stl
18.5 x 21.8 x 24.6
