lionsarmor/cyber-disk-site/site/downloads/drive-audio-r1-07b-left-eject-sled.stl

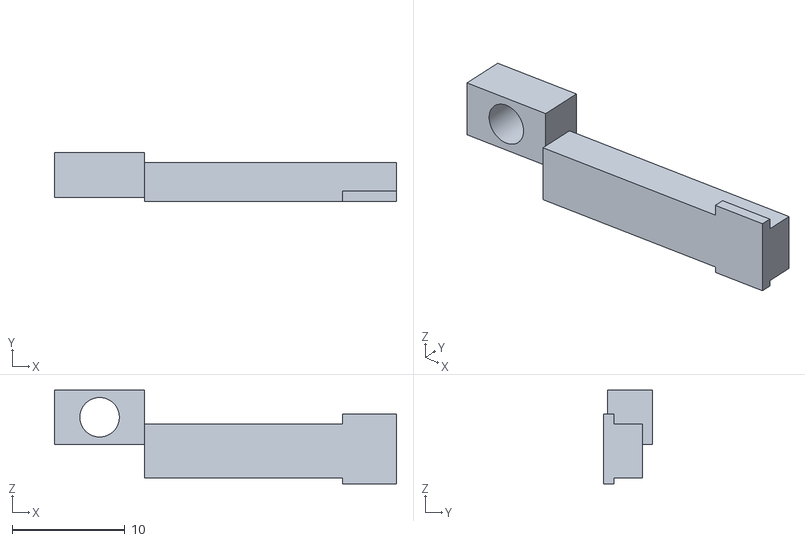
[picture p42: CAD file, 2026-11-08]
site/downloads/drive-audio-r1-07b-left-eject-sled.stl
30.3 x 4.35 x 8.30
