lionsarmor/cyber-disk-site/site/downloads/external-r4-04-core-slide-carrier.stl

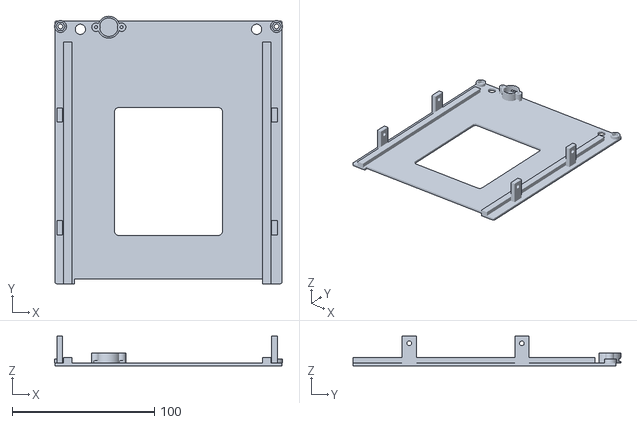
[picture p43: CAD file, 2026-11-08]
site/downloads/external-r4-04-core-slide-carrier.stl
160.4 x 188.2 x 20.8
