lionsarmor/cyber-disk-site/site/downloads/pcb-ab-hardware-r3.step

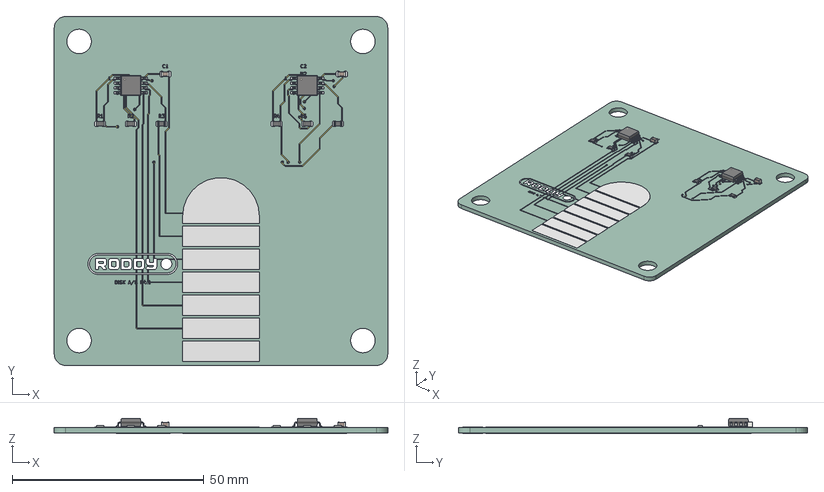
[picture p44: CAD file, 2026-11-08]
site/downloads/pcb-ab-hardware-r3.step
87.0 x 91.0 x 3.79 mm
R_0805_2012Metric x 6
SOIC-8_5.3x5.3mm_P1.27mm x 2
C_0805_2012Metric x 2
cyber-disk-ab-r4_copper
cyber-disk-ab-r4_pad
cyber-disk-ab-r4_via
cyber-disk-ab-r4_silkscreen
cyber-disk-ab-r4_PCB
