lionsarmor/cyber-disk-site/site/downloads/drive-audio-r1-04-door-flap.stl

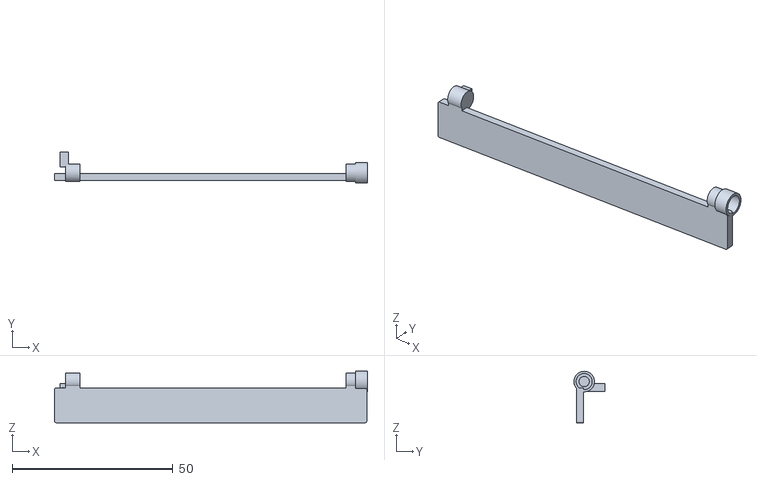
[picture p45: CAD file, 2026-11-08]
site/downloads/drive-audio-r1-04-door-flap.stl
97.2 x 9.70 x 16.0
