lionsarmor/cyber-disk-site/site/downloads/external-r4-lightwell-retaining-strip.stl

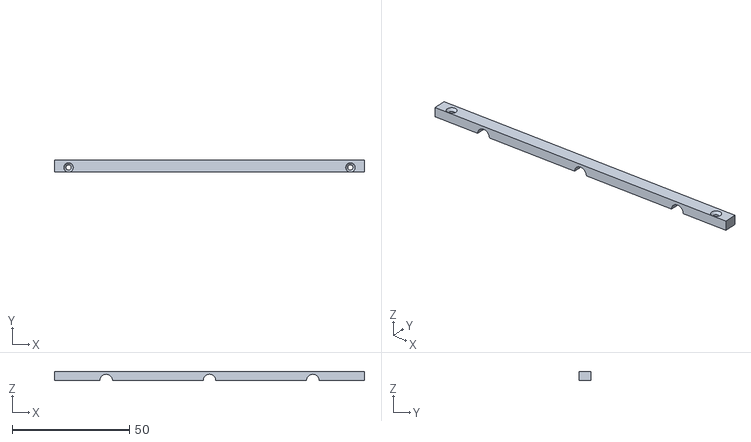
[picture p46: CAD file, 2026-11-08]
site/downloads/external-r4-lightwell-retaining-strip.stl
132.0 x 5.30 x 3.80
