lionsarmor/cyber-disk-site/site/downloads/external-r4-06-opal-base-diffuser.stl

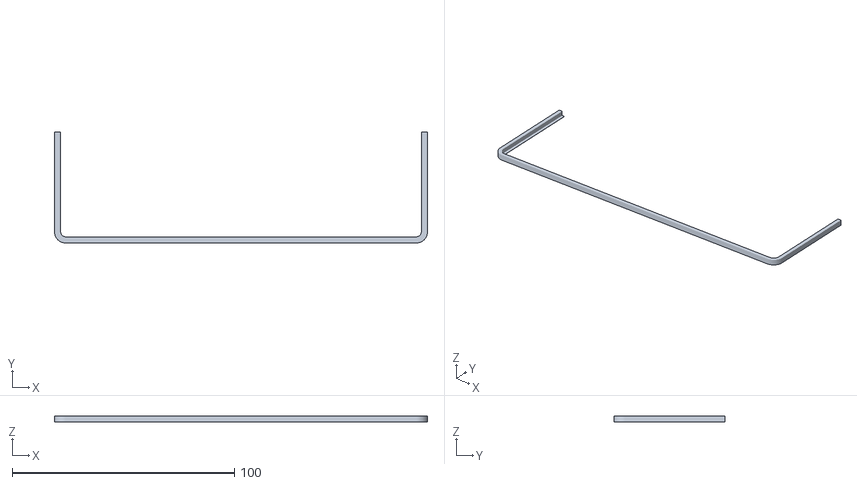
[picture p47: CAD file, 2026-11-07]
site/downloads/external-r4-06-opal-base-diffuser.stl
168.0 x 50.0 x 2.70
