lionsarmor/cyber-disk-site/site/downloads/external-r4-03-underfloor-joint-bridge.stl

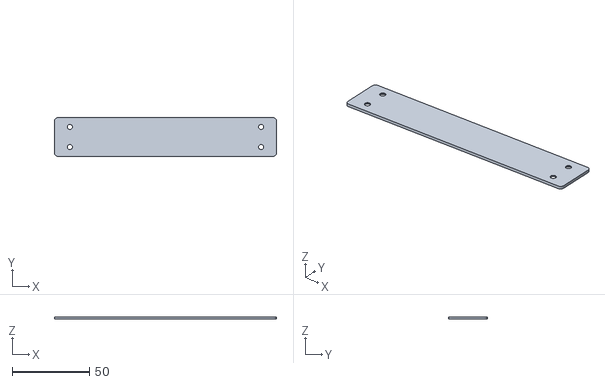
[picture p48: CAD file, 2026-11-07]
site/downloads/external-r4-03-underfloor-joint-bridge.stl
144.0 x 25.0 x 1.60
