lionsarmor/cyber-disk-site/site/downloads/drive-audio-r1-02-top-cover.stl

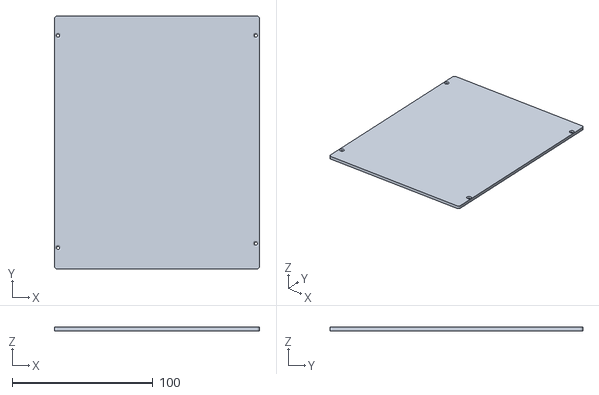
[picture p49: CAD file, 2026-11-07]
site/downloads/drive-audio-r1-02-top-cover.stl
146.1 x 180.0 x 2.70
