lionsarmor/cyber-disk-site/site/downloads/drive-audio-r1-13-harness-strain-clamp.stl

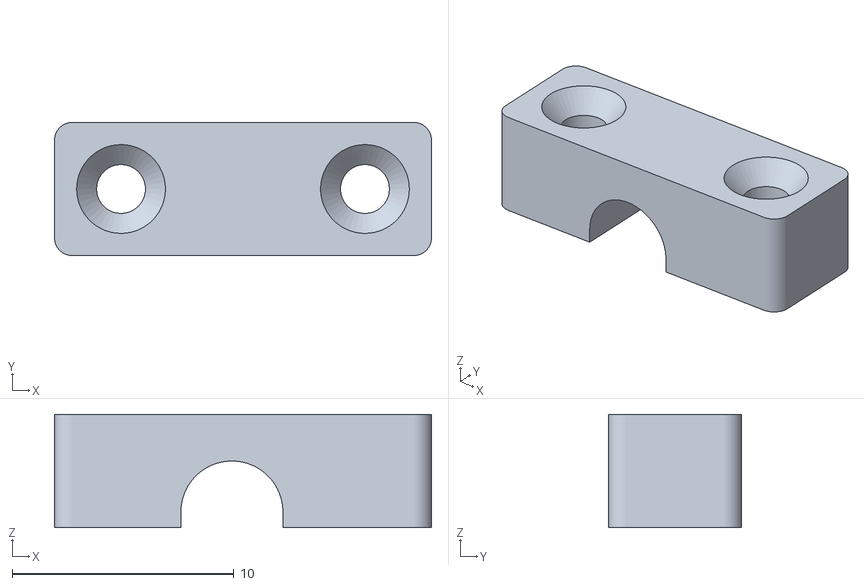
[picture p50: CAD file, 2026-11-07]
site/downloads/drive-audio-r1-13-harness-strain-clamp.stl
17.0 x 6.00 x 5.10
