lionsarmor/cyber-disk-site/site/downloads/pcb-single-r0.step

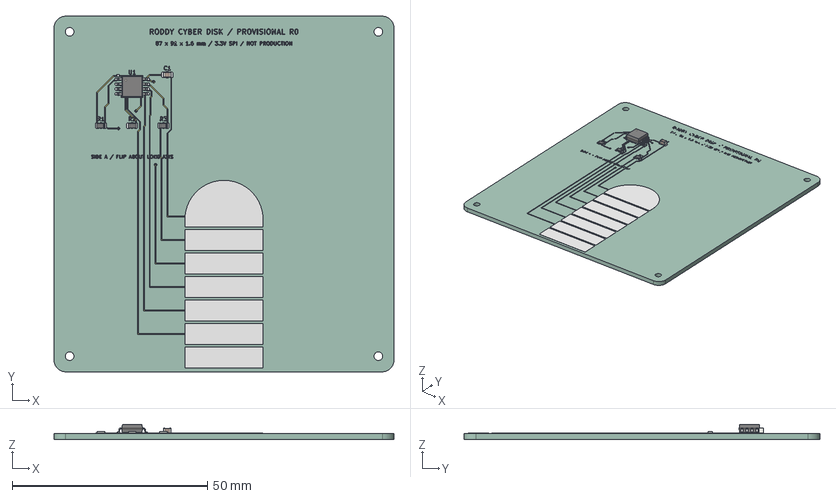
[picture p51: CAD file, 2026-11-07]
site/downloads/pcb-single-r0.step
87.0 x 91.0 x 3.79 mm
R_0805_2012Metric x 3
SOIC-8_5.3x5.3mm_P1.27mm
C_0805_2012Metric
cyber-disk-single-r0_copper
cyber-disk-single-r0_pad
cyber-disk-single-r0_via
cyber-disk-single-r0_silkscreen
cyber-disk-single-r0_PCB
