lionsarmor/cyber-disk-site/site/downloads/drive-audio-r1-06-right-guide.stl

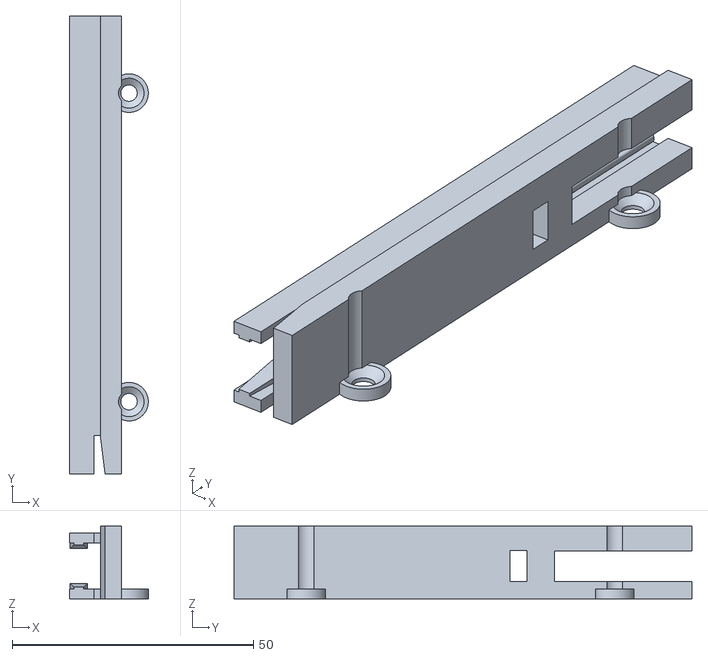
[picture p52: CAD file, 2026-11-07]
site/downloads/drive-audio-r1-06-right-guide.stl
16.3 x 95.0 x 15.1
