lionsarmor/cyber-disk-site/site/downloads/cyber-runner-ab-inlay-tracer-A-print.stl

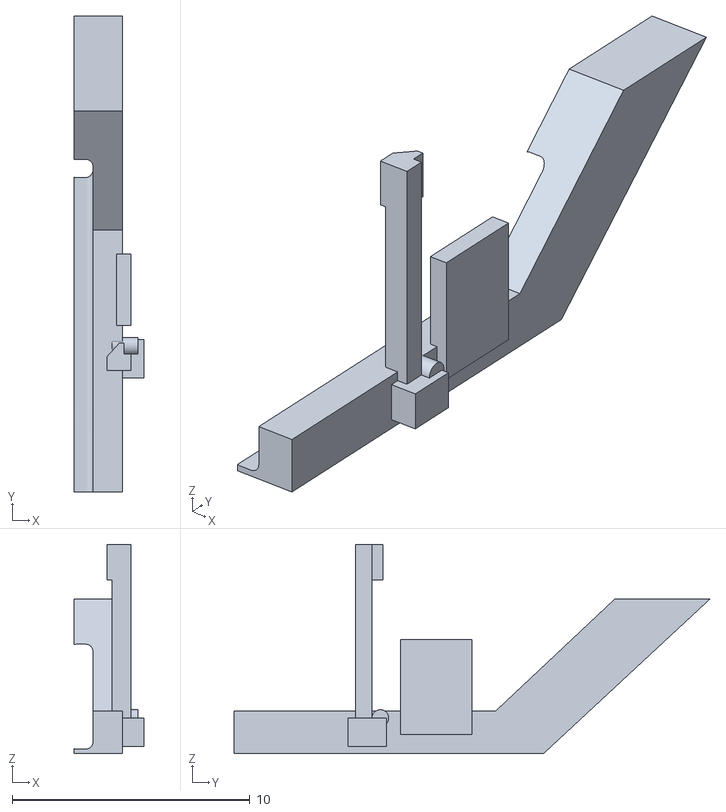
[picture p53: CAD file, 2026-11-07]
site/downloads/cyber-runner-ab-inlay-tracer-A-print.stl
2.95 x 20.0 x 8.80
