lionsarmor/cyber-disk-site/site/downloads/recessed-ab-body-upper-print.stl

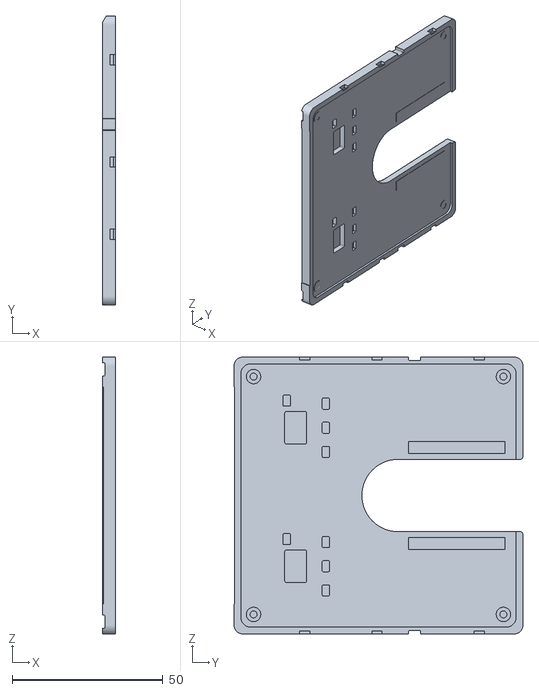
[picture p56: CAD file, 2026-11-07]
site/downloads/recessed-ab-body-upper-print.stl
4.25 x 96.0 x 92.0
