lionsarmor/cyber-disk-site/site/downloads/deep-space-single-accent-right-A-print.stl

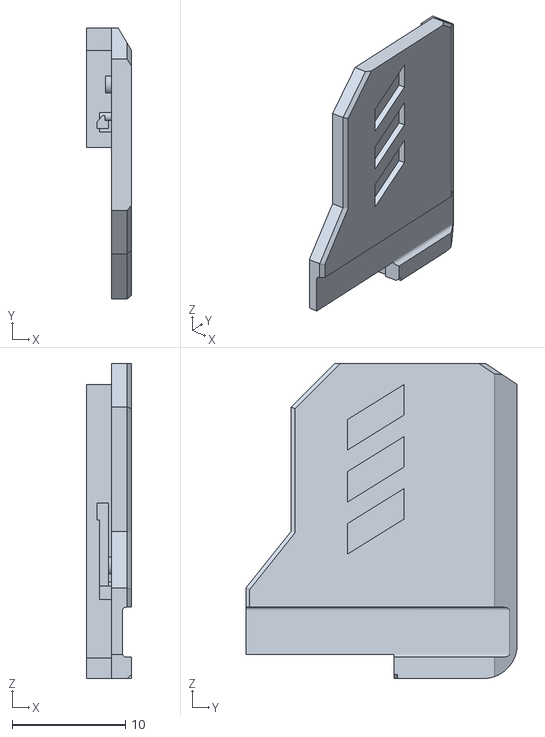
[picture p57: CAD file, 2026-11-07]
site/downloads/deep-space-single-accent-right-A-print.stl
4.00 x 24.0 x 27.9
