lionsarmor/cyber-disk-site/site/downloads/cyber-runner-ab-accent-left-B-print.stl

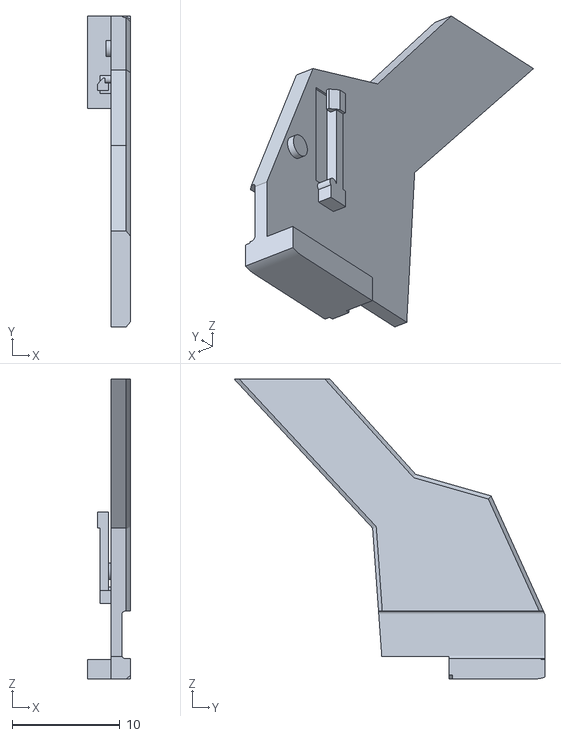
[picture p58: CAD file, 2026-11-07]
site/downloads/cyber-runner-ab-accent-left-B-print.stl
4.00 x 28.9 x 27.9
