lionsarmor/cyber-disk-site/site/downloads/deep-space-single-accent-right-B-print.stl

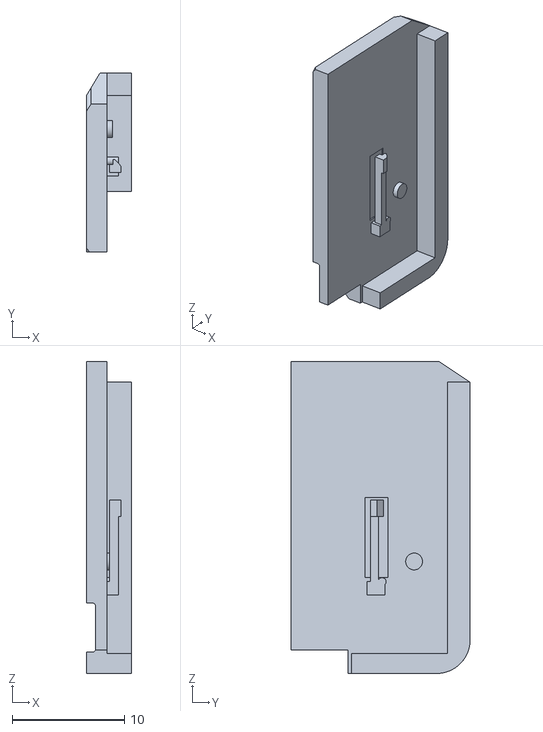
[picture p59: CAD file, 2026-11-07]
site/downloads/deep-space-single-accent-right-B-print.stl
4.00 x 16.0 x 27.9
