lionsarmor/cyber-disk-site/site/downloads/cyber-runner-ab-accent-right-A-print.stl

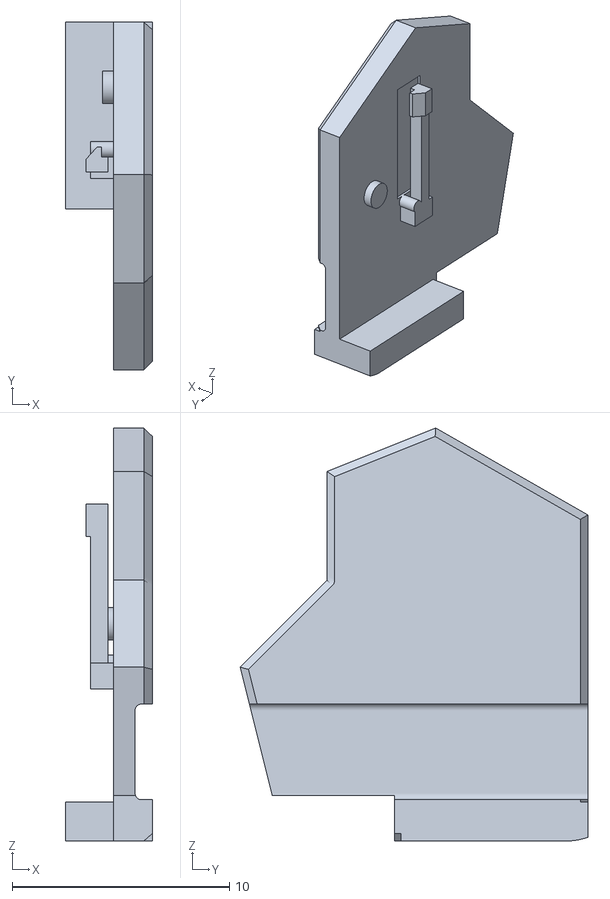
[picture p60: CAD file, 2026-11-07]
site/downloads/cyber-runner-ab-accent-right-A-print.stl
4.00 x 16.0 x 19.0
