lionsarmor/cyber-disk-site/site/downloads/cyber-runner-ab-inlay-stripes-A-print.stl

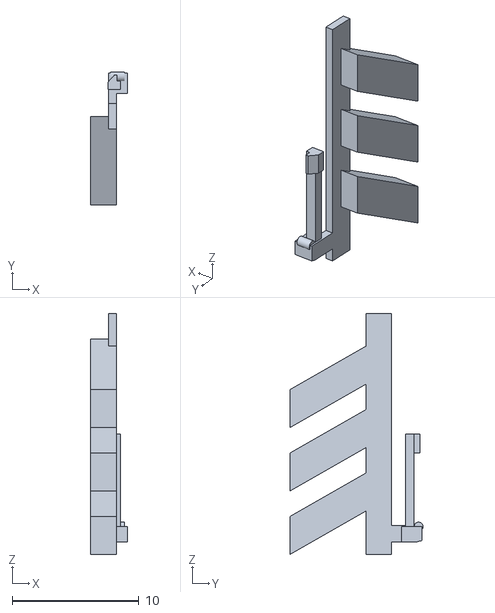
[picture p61: CAD file, 2026-11-07]
site/downloads/cyber-runner-ab-inlay-stripes-A-print.stl
2.95 x 10.5 x 19.0
