lionsarmor/cyber-disk-site/site/downloads/basic-ab-body-lower-print.stl

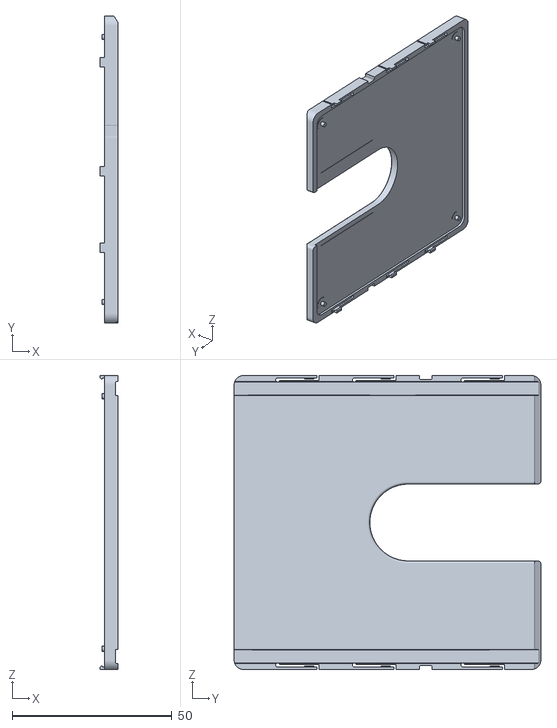
[picture p62: CAD file, 2026-11-07]
site/downloads/basic-ab-body-lower-print.stl
5.60 x 96.0 x 92.0
