lionsarmor/cyber-disk-site/site/downloads/cyber-runner-ab-body-upper-print.stl

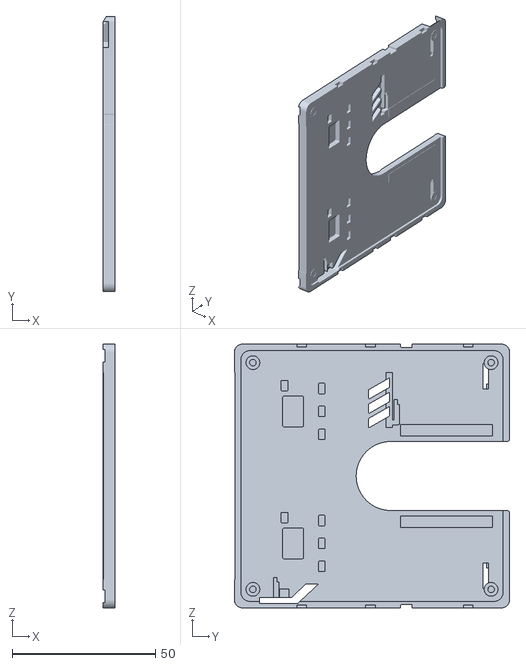
[picture p63: CAD file, 2026-11-07]
site/downloads/cyber-runner-ab-body-upper-print.stl
4.25 x 96.0 x 92.0
