lionsarmor/cyber-disk-site/site/downloads/cyber-runner-single-accent-right-B-print.stl

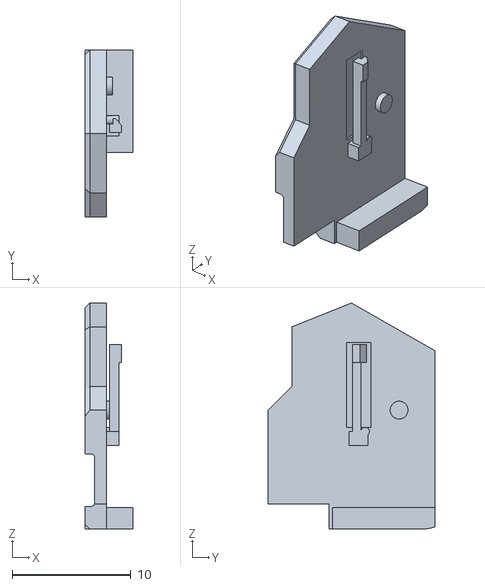
[picture p64: CAD file, 2026-11-07]
site/downloads/cyber-runner-single-accent-right-B-print.stl
4.00 x 14.0 x 19.0
