lionsarmor/cyber-disk-site/site/downloads/sleeve-r0.step

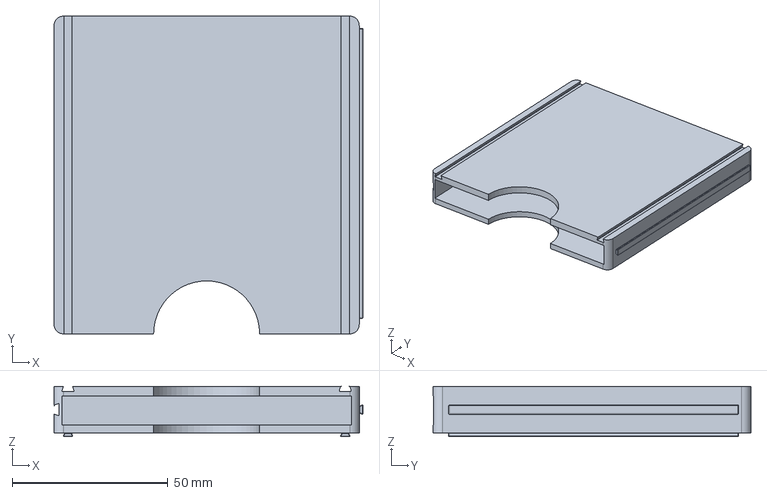
[picture p65: CAD file, 2026-11-07]
site/downloads/sleeve-r0.step
99.2 x 102.0 x 16.2 mm
