lionsarmor/cyber-disk-site/site/downloads/cyber-runner-single-accent-left-B-print.stl

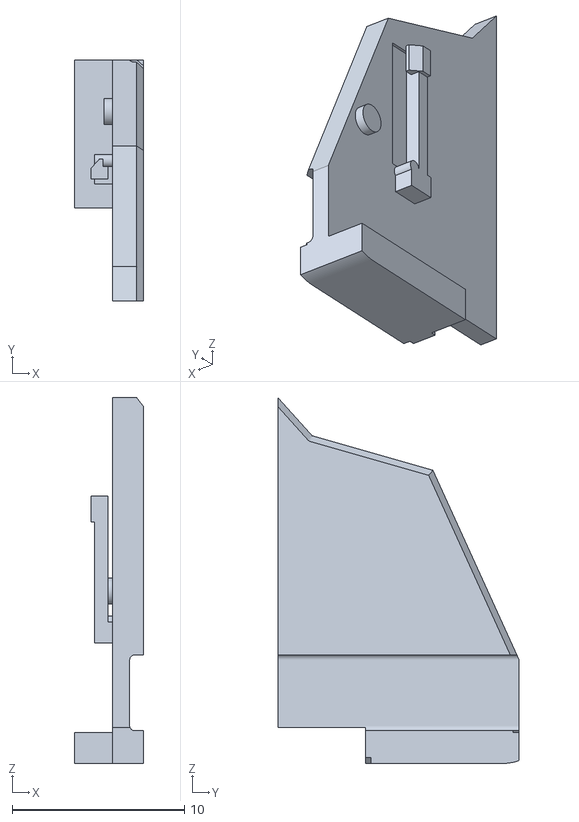
[picture p66: CAD file, 2026-11-07]
site/downloads/cyber-runner-single-accent-left-B-print.stl
4.00 x 14.0 x 21.2
