lionsarmor/cyber-disk-site/(list of files, cad)

Other CAD files:
site/downloads/basic-ab-assembly.step
site/downloads/basic-single-assembly.step
site/downloads/cyber-runner-ab-assembly.step
site/downloads/external-r4-core-base-with-dock-cable-exit.stl
site/downloads/drive-audio-r1-service.step
site/downloads/pcb-dock-hardware-r3.step
site/downloads/pcb-ab-r0.step
site/downloads/drive-audio-r1-05-left-guide.stl
site/downloads/deep-space-single-body-upper-print.stl
site/downloads/deep-space-ab-body-lower-print.stl
site/downloads/deep-space-single-accent-left-A-print.stl
site/downloads/deep-space-ab-accent-left-A-print.stl
site/downloads/cyber-runner-single-accent-left-A-print.stl
site/downloads/basic-single-body-lower-print.stl
site/downloads/cyber-runner-ab-accent-left-A-print.stl
site/downloads/deep-space-single-accent-left-B-print.stl
site/downloads/cyber-runner-ab-accent-right-B-print.stl
site/downloads/cyber-runner-single-body-upper-print.stl
site/downloads/cyber-runner-ab-inlay-tracer-B-print.stl
site/downloads/deep-space-ab-accent-left-B-print.stl
site/downloads/basic-single-body-upper-print.stl
site/downloads/basic-ab-body-upper-print.stl
site/downloads/deep-space-ab-body-upper-print.stl
site/downloads/recessed-single-body-lower-print.stl
site/downloads/deep-space-ab-accent-right-B-print.stl
site/downloads/cyber-runner-ab-inlay-stripes-B-print.stl
site/downloads/recessed-single-body-upper-print.stl
site/downloads/recessed-ab-body-lower-print.stl
site/boards/controller-r1/kicad/models/TE1718264-floppy-power.step
site/downloads/sleeve-r0.stl
