lionsarmor/cyber-disk-site/site/boards/controller-r1/schematic.pdf

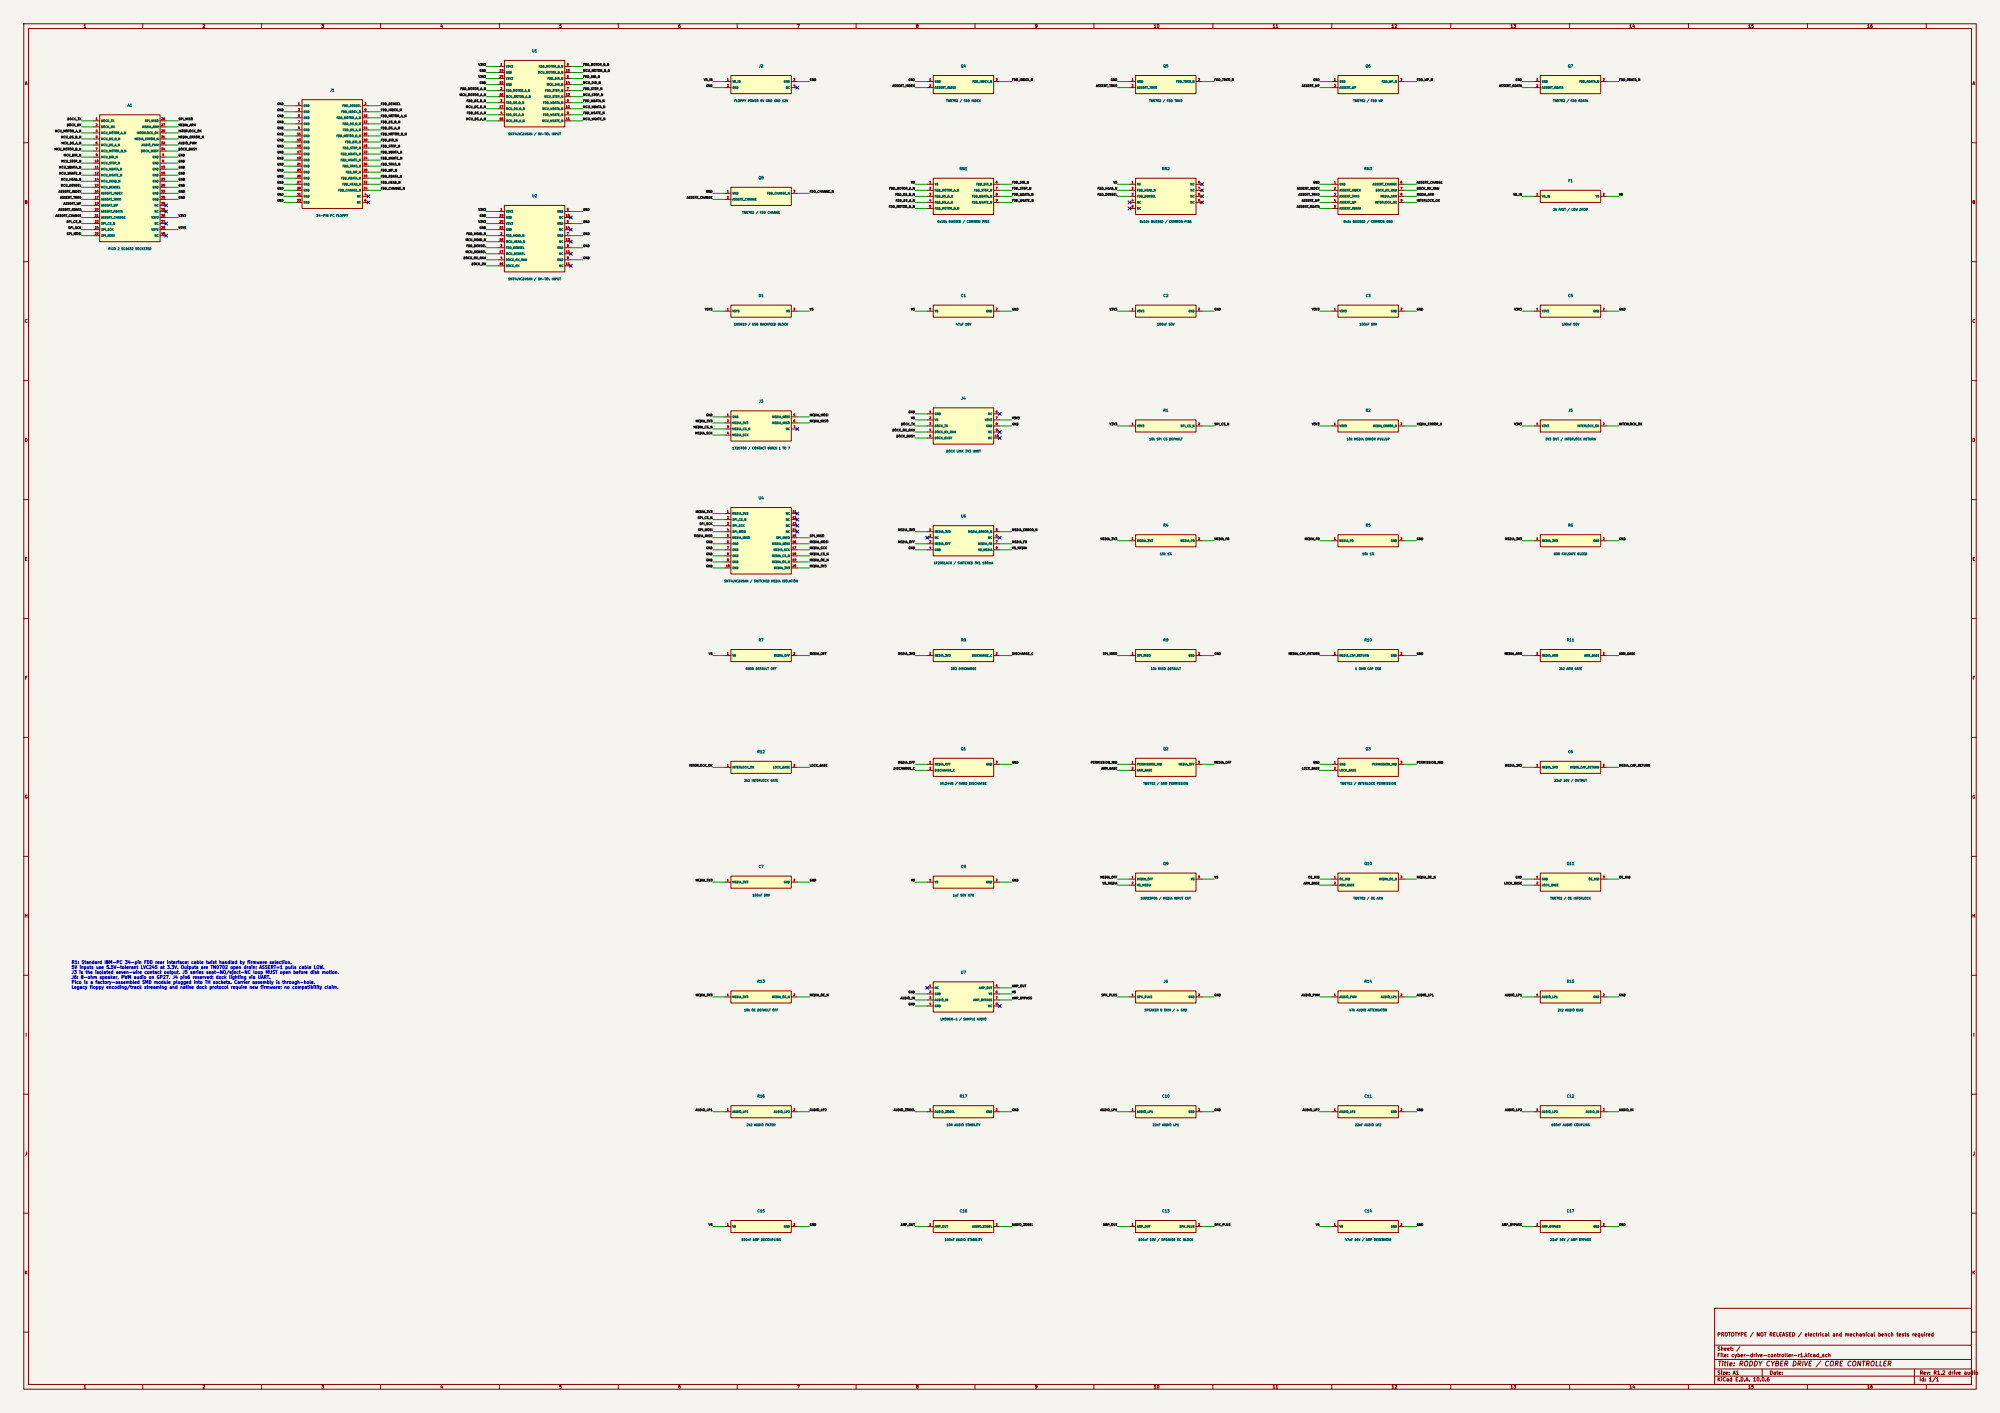
[picture p68: page 1]

FLOPPY POWER 5V GND GND 12V

R1: Standard IBM-PC 34-pin FDD rear interface; cable twist handled by firmware selection. 5V inputs use 5.5V-tolerant LVC245 at 3.3V. Outputs are TN0702 open drain; ASSERT=1 pulls cable LOW. J3 is the isolated seven-wire contact output. J5 series seat-NO/eject-NC loop MUST open before disk motion. J6: 8-ohm speaker, PWM audio on GP27. J4 pin6 reserved; dock lighting via UART. Pico is a factory-assembled SMD module plugged into TH sockets. Carrier assembly is through-hole.

Legacy floppy encoding/track streaming and native dock protocol require new firmware; no compatibility claim.

PROTOTYPE / NOT RELEASED / electrical and mechanical bench tests required

Sheet: /
File: cyber-drive-controller-r1.kicad_sch
Title: RODDY CYBER DRIVE / CORE CONTROLLER
