lionsarmor/cyber-disk-site/site/boards/contact-r1/schematic.pdf

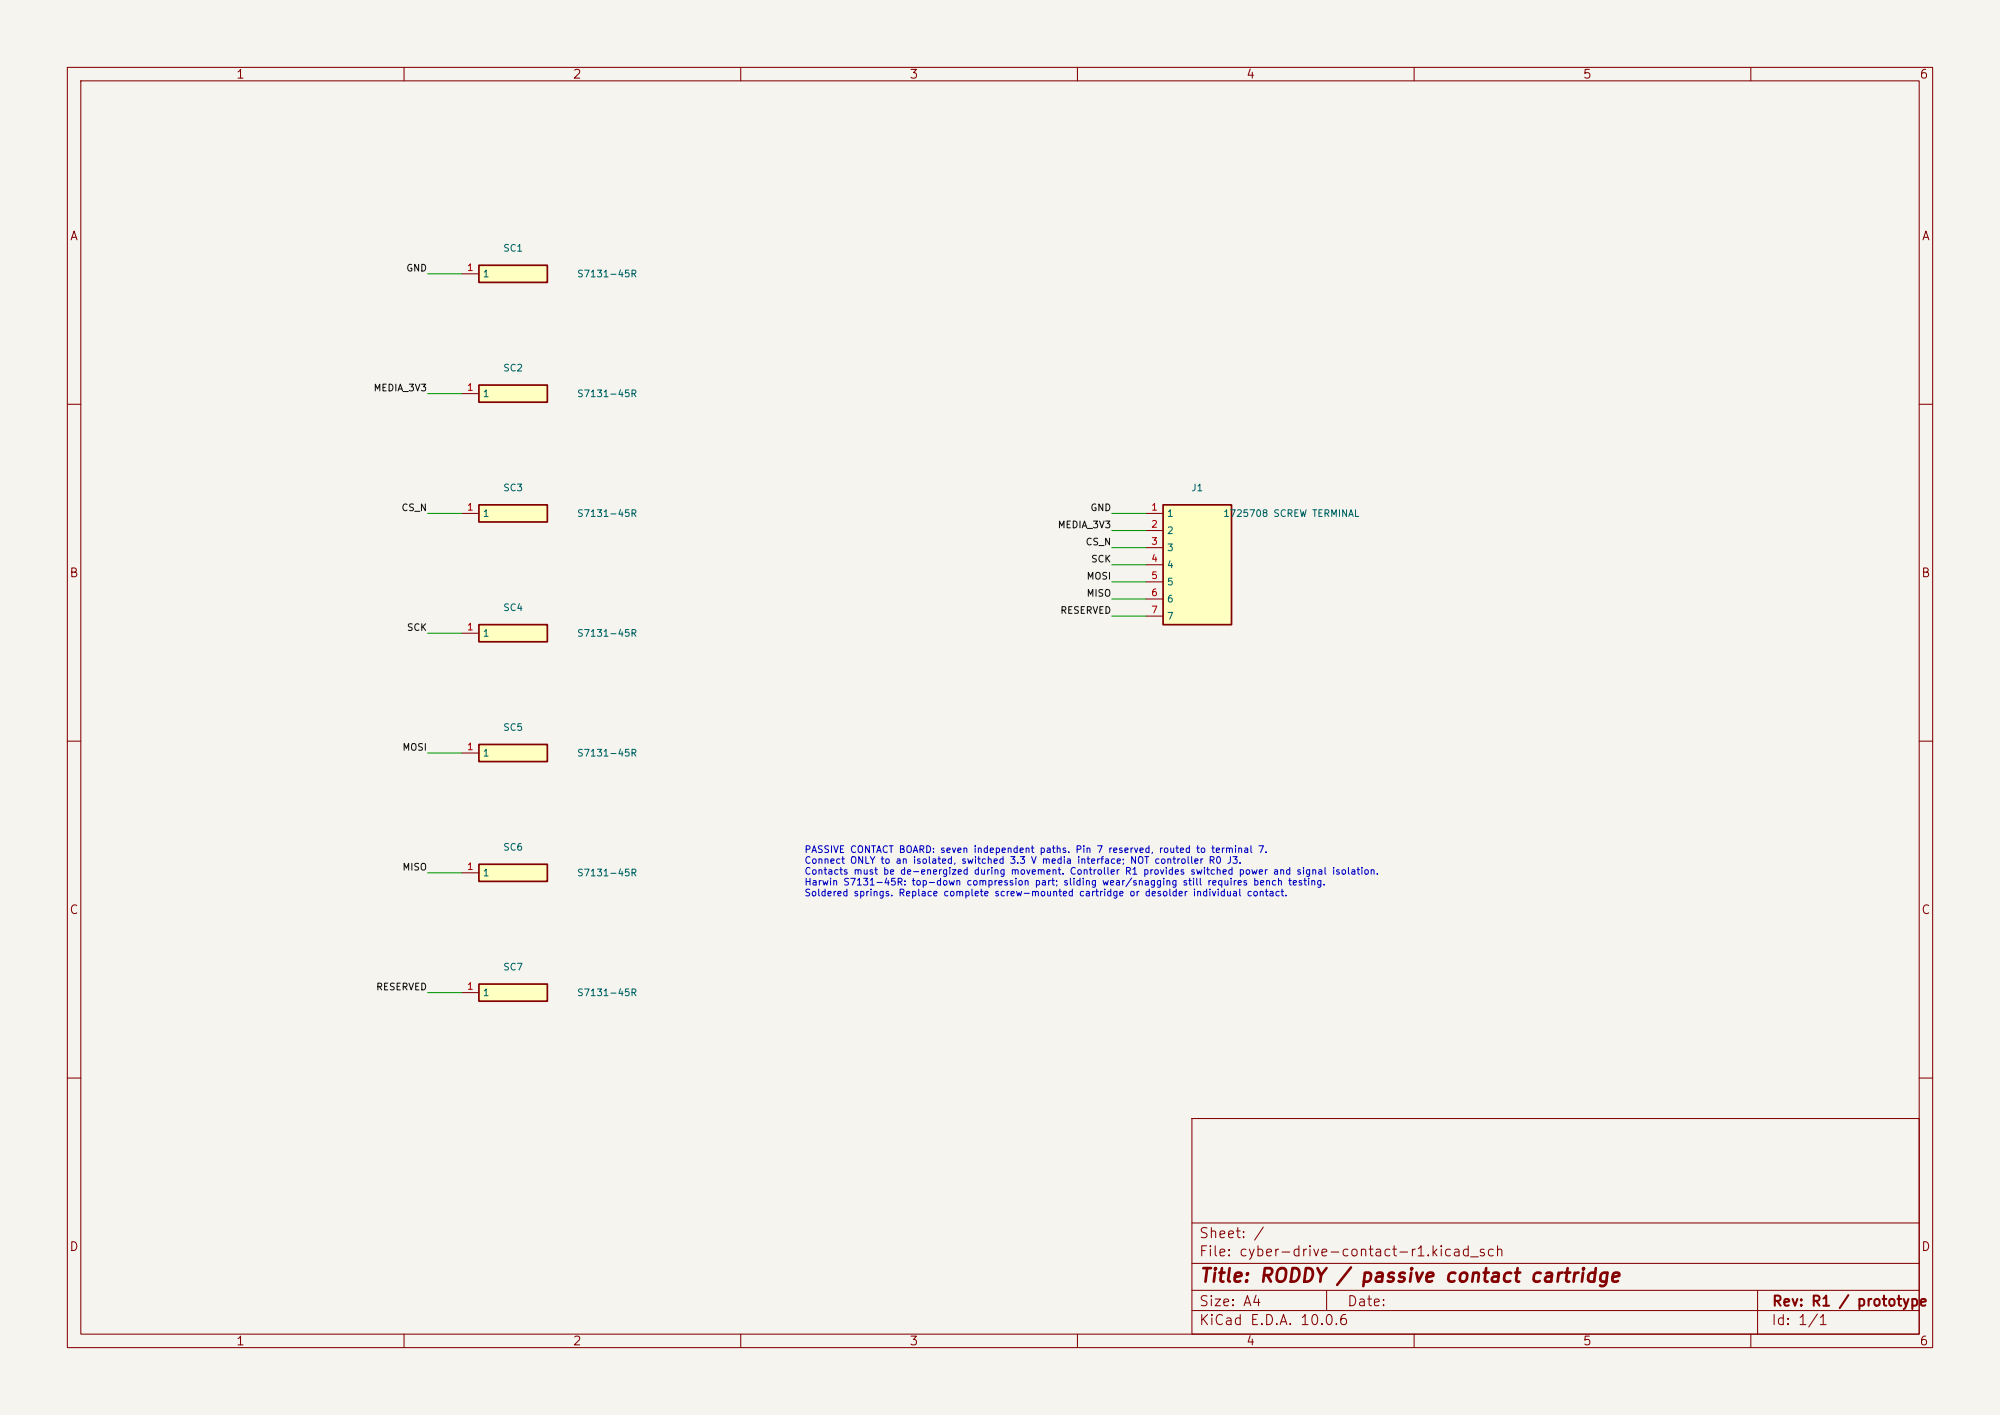
[picture p69: page 1]

1725708 SCREW TERMINAL MEDIA_3V3 GND MOSI MISO

Sheet: /
File: cyber-drive-contact-r1.kicad_sch
Title: RODDY / passive contact cartridge
KiCad E.D.A. 10.0.6
