lionsarmor/cyber-disk-site/site/boards/ab-r4/schematic.pdf

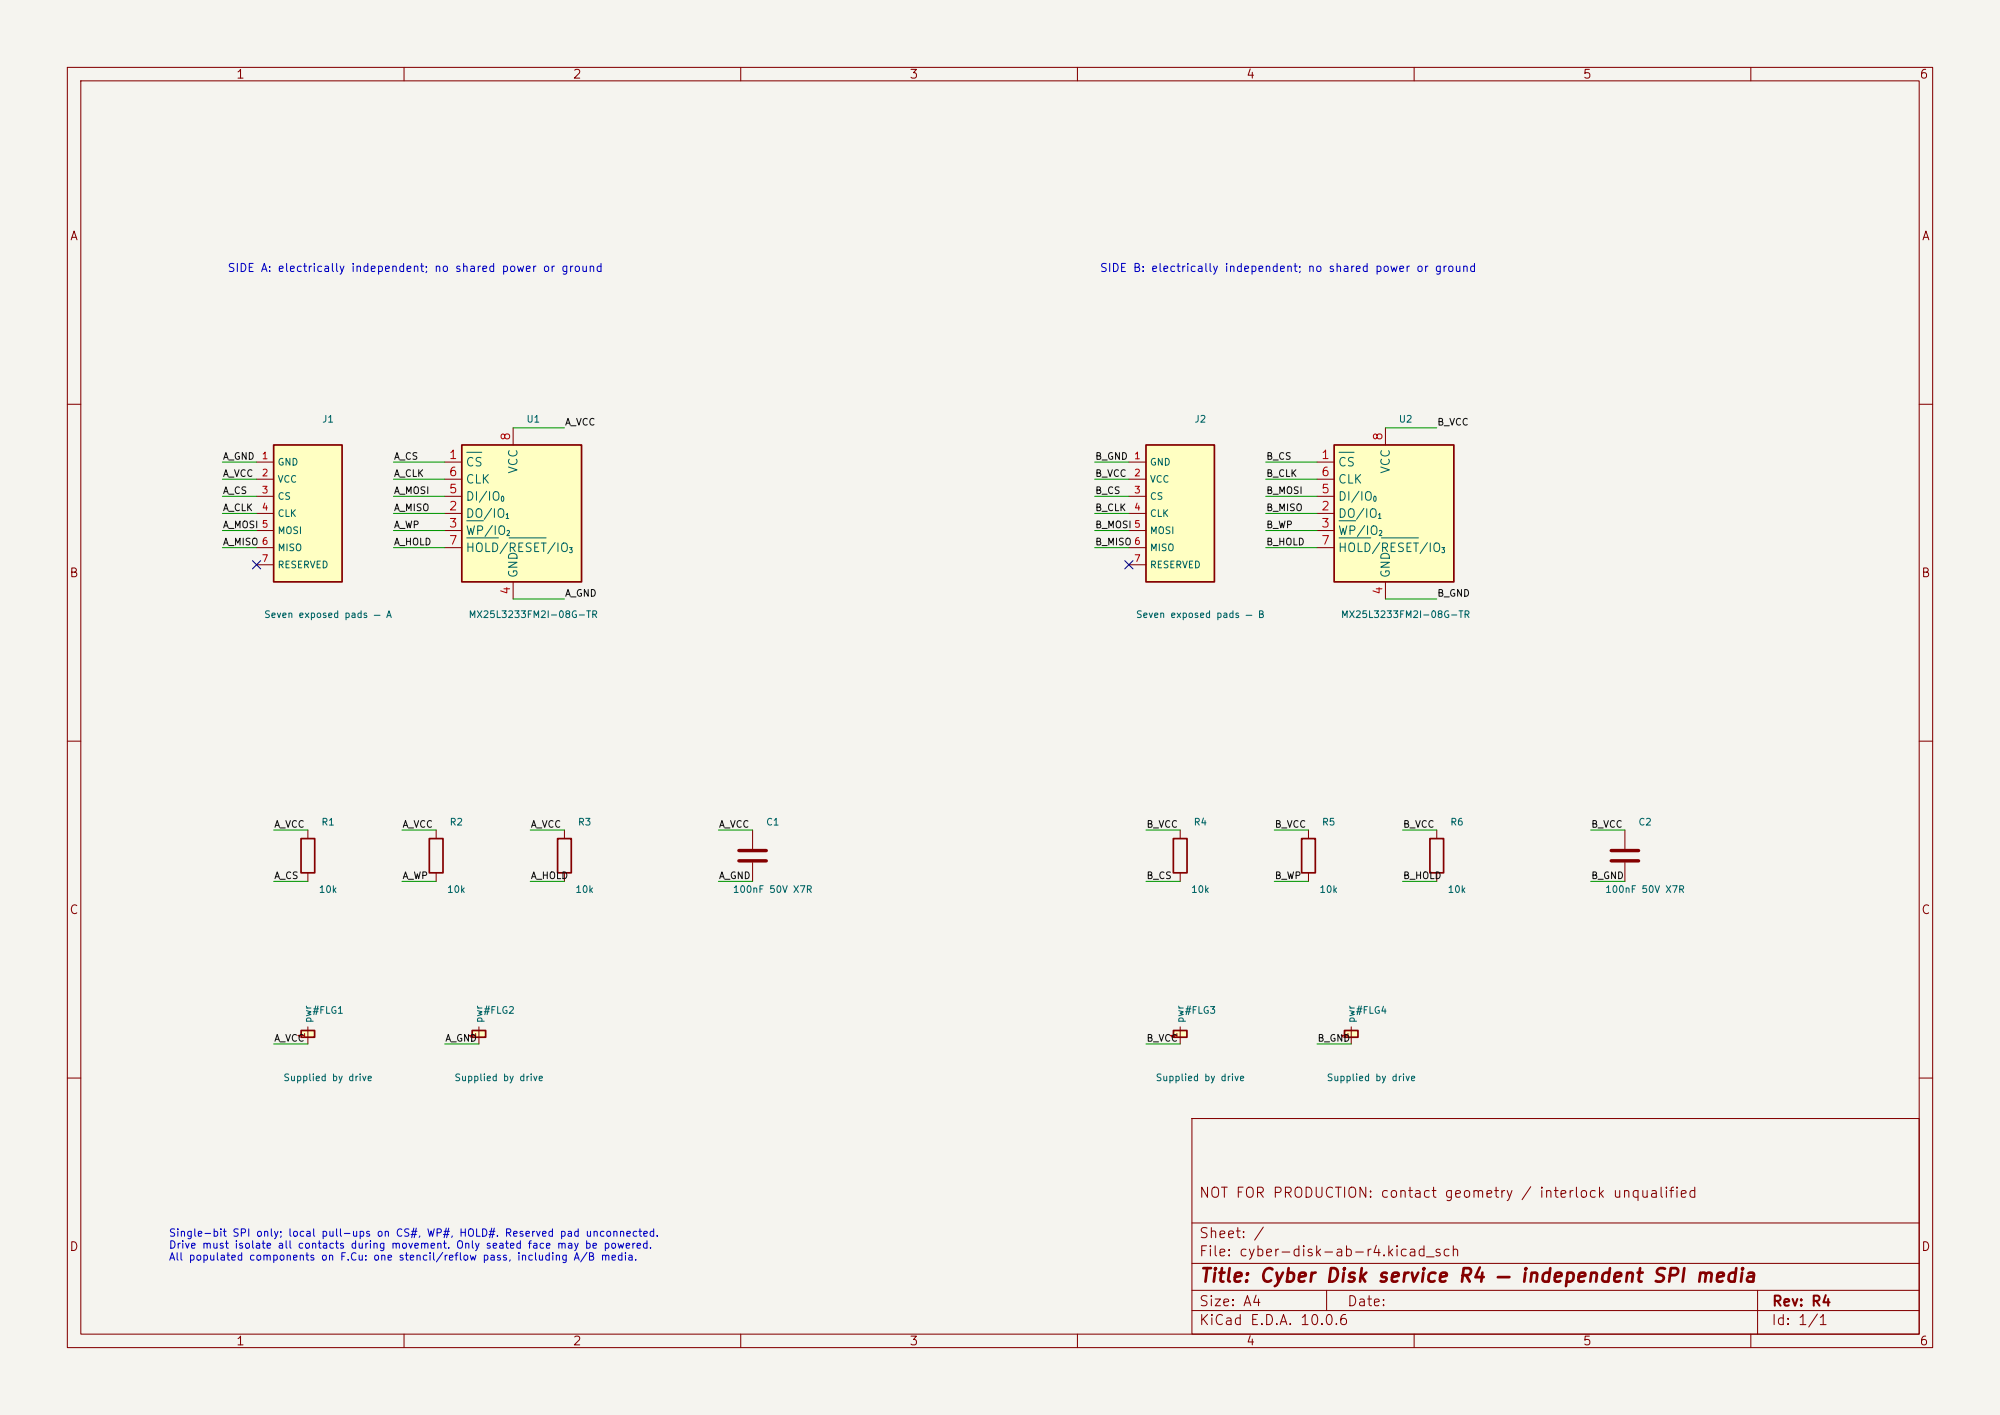
[picture p70: page 1]

4 DI/IO0 5 CLK 6 HOLD/RESET/IO3 7 VCC

Supplied by drive pwr 1 #FLG1

NOT FOR PRODUCTION: contact geometry / interlock unqualified

Single-bit SPI only; local pull-ups on CS#, WP#, HOLD#. Reserved pad unconnected. Drive must isolate all contacts during movement. Only seated face may be powered. All populated components on F.Cu: one stencil/reflow pass, including A/B media.

Sheet: /
File: cyber-disk-ab-r4.kicad_sch
Title: Cyber Disk service R4 — independent SPI media

Size: A4 | Rev: R4
KiCad E.D.A. 10.0.6 | Id: 1/1
