lionsarmor/cyber-disk-site/site/boards/external-r3/schematic.pdf

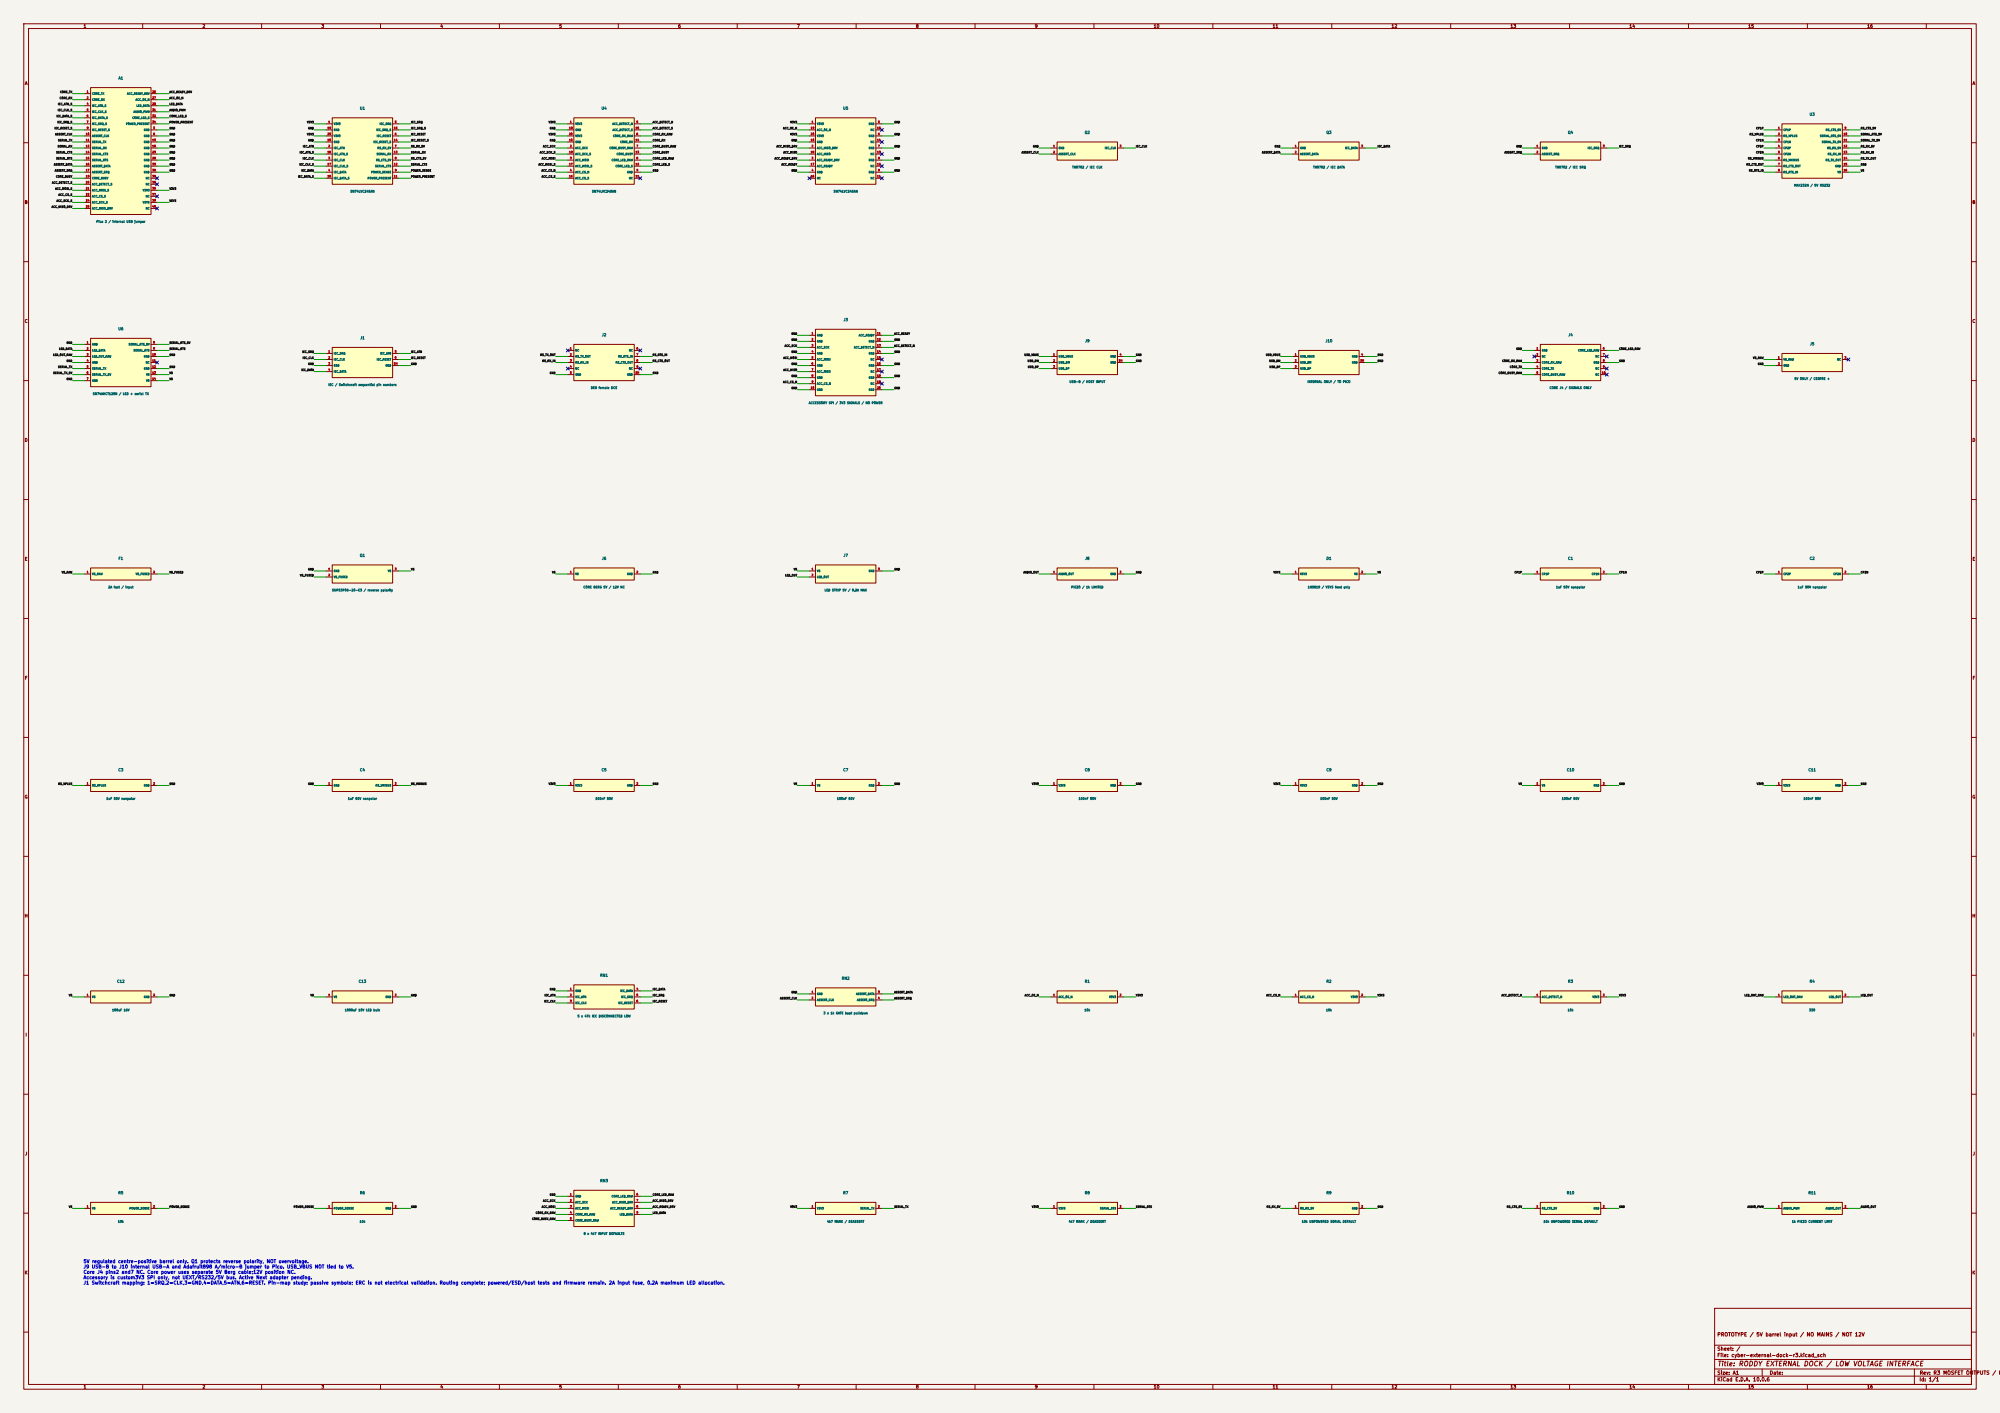
[picture p71: page 1]

Pico 2 / internal USB jumper

INTERNAL ONLY / TO PICO

ACCESSORY SPI / 3V3 SIGNALS / NO POWER

5V regulated centre-positive barrel only. Q1 protects reverse polarity, NOT overvoltage. J9 USB-B to J10 internal USB-A and Adafruit898 A/micro-B jumper to Pico. USB_VBUS NOT tied to V5. Core J4 pins2 and7 NC. Core power uses separate 5V Berg cable;12V position NC. Accessory is custom3V3 SPI only, not UEXT/RS232/5V bus. Active Next adapter pending. J1 Switchcraft mapping: 1=SRQ,2=CLK,3=GND,4=DATA,5=ATN,6=RESET. Pin-map study: passive symbols; ERC is not electrical validation. Routing complete; powered/ESD/host tests and firmware remain. 2A input fuse, 0.2A maximum LED allocation.

PROTOTYPE / 5V barrel input / NO MAINS / NOT 12V

Sheet: /
File: cyber-external-dock-r3.kicad_sch
Title: RODDY EXTERNAL DOCK / LOW VOLTAGE INTERFACE
KiCad E.D.A. 10.0.6
