lionsarmor/cyber-disk-site/site/boards/controller-r0/schematic.pdf

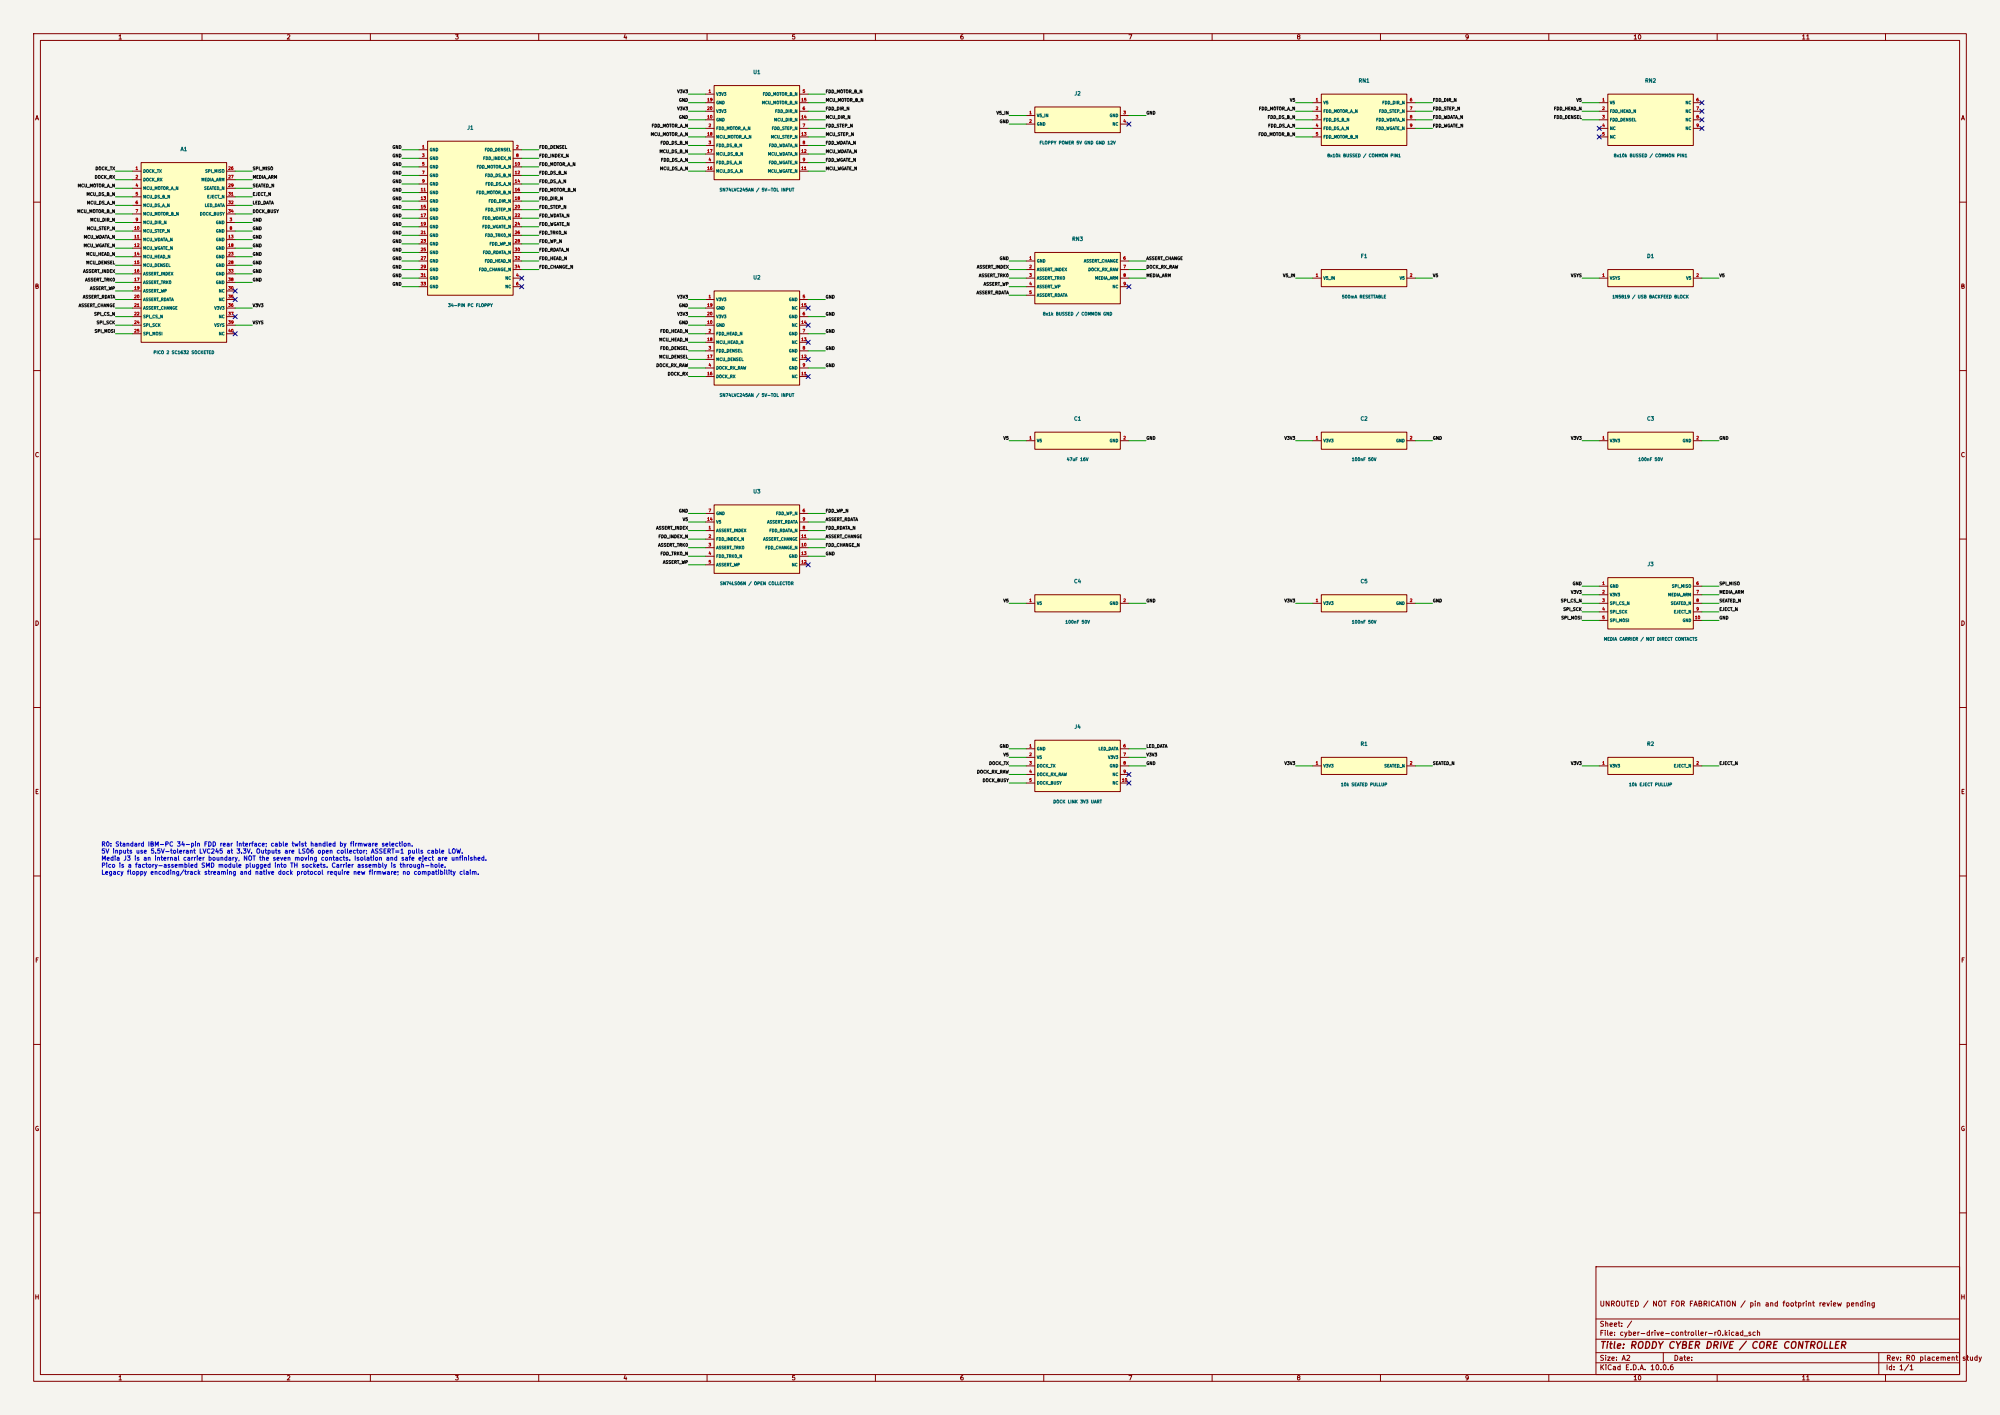
[picture p72: page 1]

FLOPPY POWER 5V GND GND 12V

FDD_CHANGE_N R0: Standard IBM-PC 34-pin FDD rear interface; cable twist handled by firmware selection. 5V inputs use 5.5V-tolerant LVC245 at 3.3V. Outputs are LS06 open collector; ASSERT=1 pulls cable LOW. Media J3 is an internal carrier boundary, NOT the seven moving contacts. Isolation and safe eject are unfinished. Pico is a factory-assembled SMD module plugged into TH sockets. Carrier assembly is through-hole.

MEDIA CARRIER / NOT DIRECT CONTACTS

Legacy floppy encoding/track streaming and native dock protocol require new firmware; no compatibility claim.

UNROUTED / NOT FOR FABRICATION / pin and footprint review pending

Sheet: /
File: cyber-drive-controller-r0.kicad_sch
Title: RODDY CYBER DRIVE / CORE CONTROLLER
KiCad E.D.A. 10.0.6
