lionsarmor/cyber-disk-site/site/boards/controller-r1/kicad/cyber-drive-controller-r1.kicad_pcb

## KiCad design site/boards/controller-r1/kicad/cyber-drive-controller-r1.kicad_pcb (2026-11-08)

Schematic: cyber-drive-controller-r1.kicad_sch, RODDY CYBER DRIVE / CORE CONTROLLER

Parts:
A1: PICO 2 SC1632 SOCKETED; Controller_A1
C1: 47uF 16V; Controller_C1
C2: 100nF 50V; Controller_C2
C3: 100nF 50V; Controller_C3
C5: 100nF 50V; Controller_C5
C6: 22uF 16V / OUTPUT; Controller_C6
C7: 100nF 50V; Controller_C7
C9: 1uF 50V X7R; Controller_C9
C10: 22nF AUDIO LP1; Controller_C10
C11: 22nF AUDIO LP2; Controller_C11
C12: 100nF AUDIO COUPLING; Controller_C12
C13: 100uF 16V / SPEAKER DC BLOCK; Controller_C13
C14: 47uF 16V / AMP RESERVOIR; Controller_C14
C15: 100nF AMP DECOUPLING; Controller_C15
C16: 100nF AUDIO STABILITY; Controller_C16
C17: 22uF 16V / AMP BYPASS; Controller_C17
D1: 1N5819 / USB BACKFEED BLOCK; Controller_D1
F1: 2A FAST / LOW DROP; Controller_F1
J1: 34-PIN PC FLOPPY; Controller_J1
J2: FLOPPY POWER 5V GND GND 12V; Controller_J2
J3: 1725708 / CONTACT WIRES 1 TO 7; Controller_J3
J4: DOCK LINK 3V3 UART; Controller_J4
J5: 3V3 OUT / INTERLOCK RETURN; Controller_J5
J6: SPEAKER 8 OHM / + GND; Controller_J6
Q1: IRLZ44N / HARD DISCHARGE; Controller_Q1
Q2: TN0702 / ARM PERMISSION; Controller_Q2
Q3: TN0702 / INTERLOCK PERMISSION; Controller_Q3
Q4: TN0702 / FDD INDEX; Controller_Q4
Q5: TN0702 / FDD TRK0; Controller_Q5
Q6: TN0702 / FDD WP; Controller_Q6
Q7: TN0702 / FDD RDATA; Controller_Q7
Q8: TN0702 / FDD CHANGE; Controller_Q8
Q9: SUP53P06 / MEDIA INPUT CUT; Controller_Q9
Q10: TN0702 / OE ARM; Controller_Q10
Q11: TN0702 / OE INTERLOCK; Controller_Q11
R1: 10k SPI CS DEFAULT; Controller_R1
R2: 10k MEDIA ERROR PULLUP; Controller_R2
R4: 15k 1%; Controller_R4
R5: 10k 1%; Controller_R5
R6: 68R FAILSAFE BLEED; Controller_R6
R7: 680R DEFAULT OFF; Controller_R7
R8: 2R2 DISCHARGE; Controller_R8
R9: 10k MISO DEFAULT; Controller_R9
R10: 1 OHM CAP ESR; Controller_R10
R11: 2k2 ARM GATE; Controller_R11
R12: 2k2 INTERLOCK GATE; Controller_R12
R13: 10k OE DEFAULT OFF; Controller_R13
R14: 47k AUDIO ATTENUATOR; Controller_R14
R15: 2k2 AUDIO BIAS; Controller_R15
R16: 2k2 AUDIO FILTER; Controller_R16
R17: 10R AUDIO STABILITY; Controller_R17
RN1: 8x10k BUSSED / COMMON PIN1; Controller_RN1
RN2: 8x10k BUSSED / COMMON PIN1; Controller_RN2
RN3: 8x1k BUSSED / COMMON GND; Controller_RN3
U1: SN74LVC245AN / 5V-TOL INPUT; Controller_U1
U2: SN74LVC245AN / 5V-TOL INPUT; Controller_U2
U4: SN74LVC245AN / SWITCHED MEDIA ISOLATION; Controller_U4
U6: LP2951ACN / SWITCHED 3V1 100mA; Controller_U6
U7: LM386N-1 / SAMPLE AUDIO; Controller_U7

Connections:
AMP_BYPASS: C17.1 (AMP_BYPASS), U7.7 (AMP_BYPASS)
AMP_OUT: C13.1 (AMP_OUT), C16.1 (AMP_OUT), U7.5 (AMP_OUT)
ARM_BASE: Q2.2 (ARM_BASE), Q10.2 (ARM_BASE), R11.2 (ARM_BASE)
ASSERT_CHANGE: A1.21 (ASSERT_CHANGE), Q8.2 (ASSERT_CHANGE), RN3.6 (ASSERT_CHANGE)
ASSERT_INDEX: A1.16 (ASSERT_INDEX), Q4.2 (ASSERT_INDEX), RN3.2 (ASSERT_INDEX)
ASSERT_RDATA: A1.20 (ASSERT_RDATA), Q7.2 (ASSERT_RDATA), RN3.5 (ASSERT_RDATA)
ASSERT_TRK0: A1.17 (ASSERT_TRK0), Q5.2 (ASSERT_TRK0), RN3.3 (ASSERT_TRK0)
ASSERT_WP: A1.19 (ASSERT_WP), Q6.2 (ASSERT_WP), RN3.4 (ASSERT_WP)
AUDIO_IN: C12.2 (AUDIO_IN), U7.3 (AUDIO_IN)
AUDIO_LP1: C10.1 (AUDIO_LP1), R14.2 (AUDIO_LP1), R15.1 (AUDIO_LP1), R16.1 (AUDIO_LP1)
AUDIO_LP2: C11.1 (AUDIO_LP2), C12.1 (AUDIO_LP2), R16.2 (AUDIO_LP2)
AUDIO_PWM: A1.32 (AUDIO_PWM), R14.1 (AUDIO_PWM)
AUDIO_ZOBEL: C16.2 (AUDIO_ZOBEL), R17.1 (AUDIO_ZOBEL)
DISCHARGE_C: Q1.2 (DISCHARGE_C), R8.2 (DISCHARGE_C)
DOCK_BUSY: A1.34 (DOCK_BUSY), J4.5 (DOCK_BUSY)
DOCK_RX: A1.2 (DOCK_RX), U2.16 (DOCK_RX)
DOCK_RX_RAW: J4.4 (DOCK_RX_RAW), RN3.7 (DOCK_RX_RAW), U2.4 (DOCK_RX_RAW)
DOCK_TX: A1.1 (DOCK_TX), J4.3 (DOCK_TX)
FDD_CHANGE_N: J1.34 (FDD_CHANGE_N), Q8.3 (FDD_CHANGE_N)
FDD_DENSEL: J1.2 (FDD_DENSEL), RN2.3 (FDD_DENSEL), U2.3 (FDD_DENSEL)
FDD_DIR_N: J1.18 (FDD_DIR_N), RN1.6 (FDD_DIR_N), U1.6 (FDD_DIR_N)
FDD_DS_A_N: J1.14 (FDD_DS_A_N), RN1.4 (FDD_DS_A_N), U1.4 (FDD_DS_A_N)
FDD_DS_B_N: J1.12 (FDD_DS_B_N), RN1.3 (FDD_DS_B_N), U1.3 (FDD_DS_B_N)
FDD_HEAD_N: J1.32 (FDD_HEAD_N), RN2.2 (FDD_HEAD_N), U2.2 (FDD_HEAD_N)
FDD_INDEX_N: J1.8 (FDD_INDEX_N), Q4.3 (FDD_INDEX_N)
FDD_MOTOR_A_N: J1.10 (FDD_MOTOR_A_N), RN1.2 (FDD_MOTOR_A_N), U1.2 (FDD_MOTOR_A_N)
FDD_MOTOR_B_N: J1.16 (FDD_MOTOR_B_N), RN1.5 (FDD_MOTOR_B_N), U1.5 (FDD_MOTOR_B_N)
FDD_RDATA_N: J1.30 (FDD_RDATA_N), Q7.3 (FDD_RDATA_N)
FDD_STEP_N: J1.20 (FDD_STEP_N), RN1.7 (FDD_STEP_N), U1.7 (FDD_STEP_N)
FDD_TRK0_N: J1.26 (FDD_TRK0_N), Q5.3 (FDD_TRK0_N)
FDD_WDATA_N: J1.22 (FDD_WDATA_N), RN1.8 (FDD_WDATA_N), U1.8 (FDD_WDATA_N)
FDD_WGATE_N: J1.24 (FDD_WGATE_N), RN1.9 (FDD_WGATE_N), U1.9 (FDD_WGATE_N)
FDD_WP_N: J1.28 (FDD_WP_N), Q6.3 (FDD_WP_N)
GND: A1.3 (GND), A1.8 (GND), A1.13 (GND), A1.18 (GND), A1.23 (GND), A1.28 (GND), A1.33 (GND), A1.38 (GND), C1.2 (GND), C2.2 (GND), C3.2 (GND), C5.2 (GND), C7.2 (GND), C9.2 (GND), C10.2 (GND), C11.2 (GND), C14.2 (GND), C15.2 (GND), C17.2 (GND), J1.1 (GND), J1.3 (GND), J1.5 (GND), J1.7 (GND), J1.9 (GND), J1.11 (GND), J1.13 (GND), J1.15 (GND), J1.17 (GND), J1.19 (GND), J1.21 (GND), J1.23 (GND), J1.25 (GND), J1.27 (GND), J1.29 (GND), J1.31 (GND), J1.33 (GND), J2.2 (GND), J2.3 (GND), J3.1 (GND), J4.1 (GND), J4.8 (GND), J6.2 (GND), Q1.3 (GND), Q3.1 (GND), Q4.1 (GND), Q5.1 (GND), Q6.1 (GND), Q7.1 (GND), Q8.1 (GND), Q11.1 (GND), R5.2 (GND), R6.2 (GND), R9.2 (GND), R10.2 (GND), R15.2 (GND), R17.2 (GND), RN3.1 (GND), U1.10 (GND), U1.19 (GND), U2.5 (GND), U2.6 (GND), U2.7 (GND), U2.8 (GND), U2.9 (GND), U2.10 (GND), U2.19 (GND), U4.6 (GND), U4.7 (GND), U4.8 (GND), U4.9 (GND), U4.10 (GND), U6.4 (GND), U7.2 (GND), U7.4 (GND)
INTERLOCK_OK: A1.29 (INTERLOCK_OK), J5.2 (INTERLOCK_OK), R12.1 (INTERLOCK_OK), RN3.9 (INTERLOCK_OK)
LOCK_BASE: Q3.2 (LOCK_BASE), Q11.2 (LOCK_BASE), R12.2 (LOCK_BASE)
MCU_DENSEL: A1.15 (MCU_DENSEL), U2.17 (MCU_DENSEL)
MCU_DIR_N: A1.9 (MCU_DIR_N), U1.14 (MCU_DIR_N)
MCU_DS_A_N: A1.6 (MCU_DS_A_N), U1.16 (MCU_DS_A_N)
MCU_DS_B_N: A1.5 (MCU_DS_B_N), U1.17 (MCU_DS_B_N)
MCU_HEAD_N: A1.14 (MCU_HEAD_N), U2.18 (MCU_HEAD_N)
MCU_MOTOR_A_N: A1.4 (MCU_MOTOR_A_N), U1.18 (MCU_MOTOR_A_N)
MCU_MOTOR_B_N: A1.7 (MCU_MOTOR_B_N), U1.15 (MCU_MOTOR_B_N)
MCU_STEP_N: A1.10 (MCU_STEP_N), U1.13 (MCU_STEP_N)
MCU_WDATA_N: A1.11 (MCU_WDATA_N), U1.12 (MCU_WDATA_N)
MCU_WGATE_N: A1.12 (MCU_WGATE_N), U1.11 (MCU_WGATE_N)
MEDIA_3V3: C6.1 (MEDIA_3V3), C7.1 (MEDIA_3V3), J3.2 (MEDIA_3V3), R4.1 (MEDIA_3V3), R6.1 (MEDIA_3V3), R8.1 (MEDIA_3V3), R13.1 (MEDIA_3V3), U4.1 (MEDIA_3V3), U4.20 (MEDIA_3V3), U6.1 (MEDIA_3V3)
MEDIA_ARM: A1.27 (MEDIA_ARM), R11.1 (MEDIA_ARM), RN3.8 (MEDIA_ARM)
MEDIA_CAP_RETURN: C6.2 (MEDIA_CAP_RETURN), R10.1 (MEDIA_CAP_RETURN)
MEDIA_CS_N: J3.3 (MEDIA_CS_N), U4.18 (MEDIA_CS_N)
MEDIA_ERROR_N: A1.31 (MEDIA_ERROR_N), R2.2 (MEDIA_ERROR_N), U6.5 (MEDIA_ERROR_N)
MEDIA_FB: R4.2 (MEDIA_FB), R5.1 (MEDIA_FB), U6.7 (MEDIA_FB)
MEDIA_MISO: J3.6 (MEDIA_MISO), U4.5 (MEDIA_MISO)
MEDIA_MOSI: J3.5 (MEDIA_MOSI), U4.16 (MEDIA_MOSI)
MEDIA_OE_N: Q10.3 (MEDIA_OE_N), R13.2 (MEDIA_OE_N), U4.19 (MEDIA_OE_N)
MEDIA_OFF: Q1.1 (MEDIA_OFF), Q2.3 (MEDIA_OFF), Q9.1 (MEDIA_OFF), R7.2 (MEDIA_OFF), U6.3 (MEDIA_OFF)
MEDIA_SCK: J3.4 (MEDIA_SCK), U4.17 (MEDIA_SCK)
OE_MID: Q10.1 (OE_MID), Q11.3 (OE_MID)
PERMISSION_MID: Q2.1 (PERMISSION_MID), Q3.3 (PERMISSION_MID)
SPI_CS_N: A1.22 (SPI_CS_N), R1.2 (SPI_CS_N), U4.2 (SPI_CS_N)
SPI_MISO: A1.26 (SPI_MISO), R9.1 (SPI_MISO), U4.15 (SPI_MISO)
SPI_MOSI: A1.25 (SPI_MOSI), U4.4 (SPI_MOSI)
SPI_SCK: A1.24 (SPI_SCK), U4.3 (SPI_SCK)
SPK_PLUS: C13.2 (SPK_PLUS), J6.1 (SPK_PLUS)
V3V3: A1.36 (V3V3), C2.1 (V3V3), C3.1 (V3V3), C5.1 (V3V3), J4.7 (V3V3), J5.1 (V3V3), R1.1 (V3V3), R2.1 (V3V3), U1.1 (V3V3), U1.20 (V3V3), U2.1 (V3V3), U2.20 (V3V3)
V5: C1.1 (V5), C9.1 (V5), C14.1 (V5), C15.1 (V5), D1.2 (V5), F1.2 (V5), J4.2 (V5), Q9.3 (V5), R7.1 (V5), RN1.1 (V5), RN2.1 (V5), U7.6 (V5)
V5_IN: F1.1 (V5_IN), J2.1 (V5_IN)
V5_MEDIA: Q9.2 (V5_MEDIA), U6.8 (V5_MEDIA)
VSYS: A1.39 (VSYS), D1.1 (VSYS)

Notes on the sheet:
R1: Standard IBM-PC 34-pin FDD rear interface; cable twist handled by firmware selection. 5V inputs use 5.5V-tolerant LVC245 at 3.3V. Outputs are TN0702 open drain; ASSERT=1 pulls cable LOW. J3 is the isolated seven-wire contact output. J5 series seat-NO/eject-NC loop MUST open before disk motion. 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

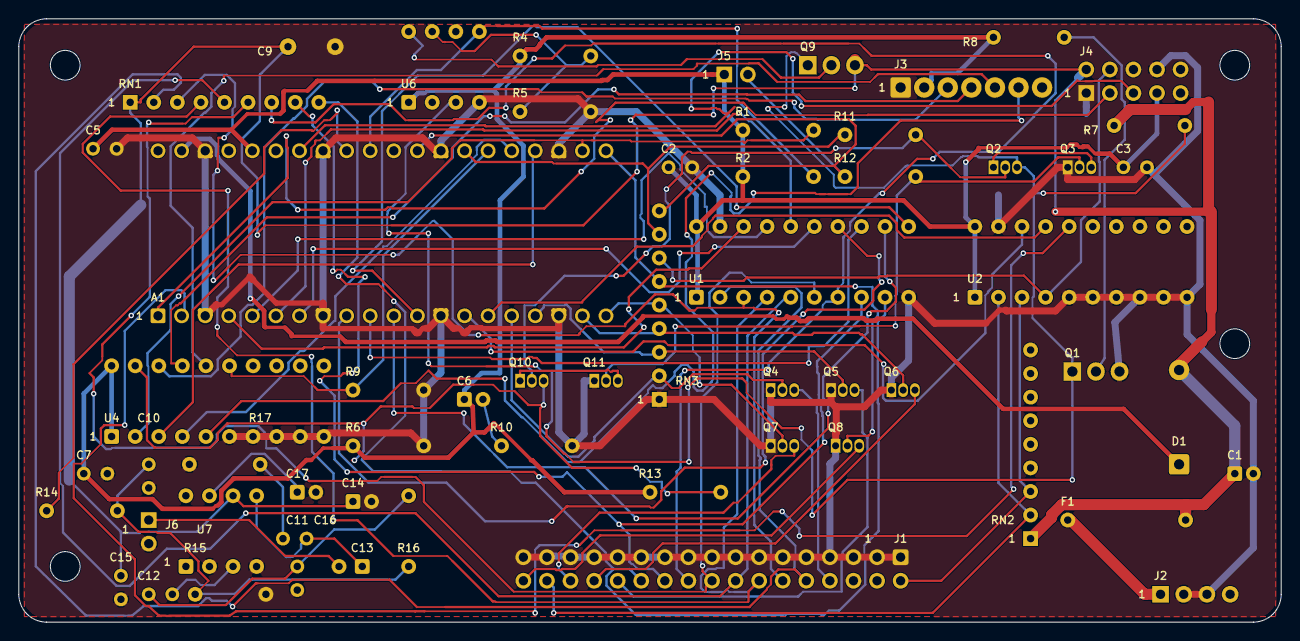
[picture p73: board cyber-drive-controller-r1.kicad_pcb from above]

Board: 2 copper layers, 136.0 x 65.0 mm, 63 parts (0 on the bottom side), 69 nets.

Other parts of the board:
H1: MountingHole_3.2mm_M3; Controller_H1
H2: MountingHole_3.2mm_M3; Controller_H2
H3: MountingHole_3.2mm_M3; Controller_H3
H4: MountingHole_3.2mm_M3; Controller_H4
