lionsarmor/cyber-disk-site/site/boards/contact-r1/kicad/cyber-drive-contact-r1.kicad_pcb

## KiCad design site/boards/contact-r1/kicad/cyber-drive-contact-r1.kicad_pcb (2026-11-08)

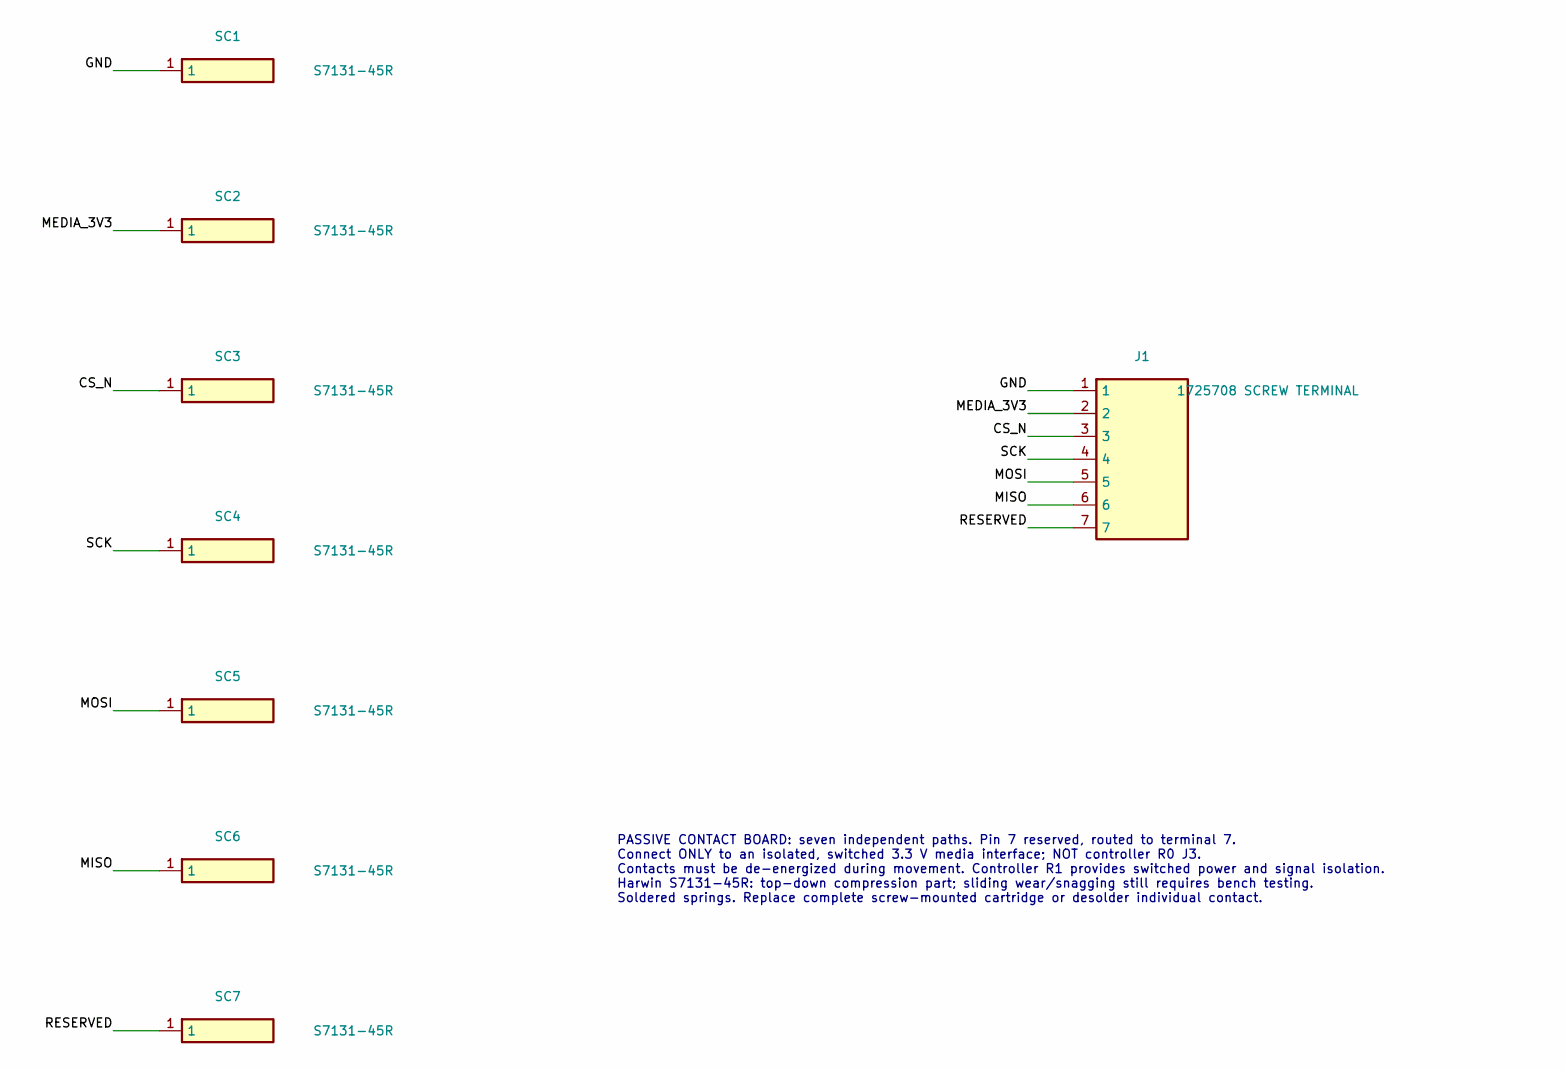
[picture p74: schematic cyber-drive-contact-r1.kicad_sch, RODDY / passive contact cartridge]

Parts:
J1: 1725708 SCREW TERMINAL; Terminal7_Phoenix1725708
SC1, SC2, SC3, SC4, SC5, SC6, SC7: S7131-45R; Contact__Harwin_S7131-45R

Connections:
/CS_N: J1.3, SC3.1
/GND: J1.1, SC1.1
/MEDIA_3V3: J1.2, SC2.1
/MISO: J1.6, SC6.1
/MOSI: J1.5, SC5.1
/RESERVED: J1.7, SC7.1
/SCK: J1.4, SC4.1

Notes on the sheet:
PASSIVE CONTACT BOARD: seven independent paths. Pin 7 reserved, routed to terminal 7. Connect ONLY to an isolated, switched 3.3 V media interface; NOT controller R0 J3. Contacts must be de-energized during movement. Controller R1 provides switched power and signal isolation. Harwin S7131-45R: top-d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

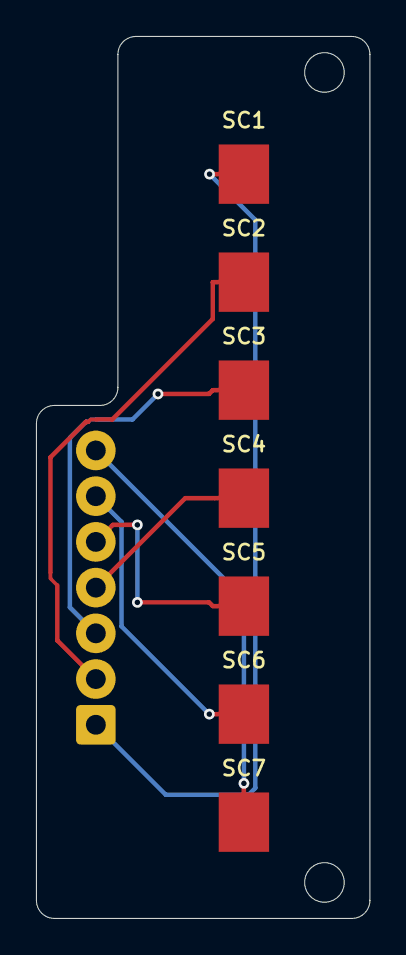
[picture p75: board cyber-drive-contact-r1.kicad_pcb from above]

Board: 2 copper layers, 18.5 x 49.0 mm, 10 parts (1 on the bottom side), 7 nets.

Other parts of the board:
H1: M2 NPTH; BoardMount_H1
H2: M2 NPTH; BoardMount_H2
