lionsarmor/cyber-disk-site/site/boards/external-r3/kicad/cyber-external-dock-r3.kicad_pcb

## KiCad design site/boards/external-r3/kicad/cyber-external-dock-r3.kicad_pcb (2026-11-08)

Schematic: cyber-external-dock-r3.kicad_sch, RODDY EXTERNAL DOCK / LOW VOLTAGE INTERFACE

Parts:
A1: Pico 2 / internal USB jumper; Module__RaspberryPi_Pico_Common_THT
C1, C2, C3, C4: 1uF 50V nonpolar; Dock__C330_P5.08
C5, C7, C8, C9, C10, C11: 100nF 50V; Dock__C315_P2.54
C12: 100uF 16V; Capacitor_THT__CP_Radial_D6.3mm_P2.50mm
C13: 1000uF 10V LED bulk; Capacitor_THT__CP_Radial_D10.0mm_P5.00mm
D1: 1N5819 / VSYS feed only; Diode_THT__D_DO-41_SOD81_P10.16mm_Horizontal
F1: 2A fast / input; Resistor_THT__R_Axial_DIN0309_L9.0mm_D3.2mm_P12.70mm_Horizo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
J1: IEC / Switchcraft sequential pin numbers; Dock__DIN_61PC6F
J2: DE9 female DCE; Dock__DE9_09661527612
J3: ACCESSORY SPI / 3V3 SIGNALS / NO POWER; Dock__WR_BHD_61202021721
J4: CORE J4 / SIGNALS ONLY; Connector_IDC__IDC-Header_2x05_P2.54mm_Vertical
J5: 5V ONLY / CENTRE +; Dock__BarrelJack_PJ102AH_2024
J6: CORE BERG 5V / 12V NC; Connector_PinHeader_2.54mm__PinHeader_1x02_P2.54mm_Vertical
J7: LED STRIP 5V / 0.2A MAX; Connector_PinHeader_2.54mm__PinHeader_1x03_P2.54mm_Vertical
J8: PIEZO / 1k LIMITED; Connector_PinHeader_2.54mm__PinHeader_1x02_P2.54mm_Vertical
J9: USB-B / HOST INPUT; Dock__USB_B_61729
J10: INTERNAL ONLY / TO PICO; Connector_USB__USB_A_Molex_67643_Horizontal
Q1: SUP53P06-20-E3 / reverse polarity; Package_TO_SOT_THT__TO-220-3_Vertical
Q2: TN0702 / IEC CLK; Package_TO_SOT_THT__TO-92_Inline
Q3: TN0702 / IEC DATA; Package_TO_SOT_THT__TO-92_Inline
Q4: TN0702 / IEC SRQ; Package_TO_SOT_THT__TO-92_Inline
R1, R2, R3, R5, R6: 10k; Resistor_THT__R_Axial_DIN0207_L6.3mm_D2.5mm_P7.62mm_Horizon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
R4: 330; Resistor_THT__R_Axial_DIN0207_L6.3mm_D2.5mm_P7.62mm_Horizon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
R7, R8: 4k7 MARK / DEASSERT; Resistor_THT__R_Axial_DIN0207_L6.3mm_D2.5mm_P7.62mm_Horizon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
R9, R10: 10k UNPOWERED SERIAL DEFAULT; Resistor_THT__R_Axial_DIN0207_L6.3mm_D2.5mm_P7.62mm_Horizon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
R11: 1k PIEZO CURRENT LIMIT; Resistor_THT__R_Axial_DIN0207_L6.3mm_D2.5mm_P7.62mm_Horizon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
RN1: 5 x 47k IEC DISCONNECTED LOW; Resistor_THT__R_Array_SIP6
RN2: 3 x 1k GATE boot pulldown; Resistor_THT__R_Array_SIP4
RN3: 8 x 4k7 INPUT DEFAULTS; Resistor_THT__R_Array_SIP9
U1, U4, U5: SN74LVC245AN; Package_DIP__DIP-20_W7.62mm
U3: MAX232N / 5V RS232; Package_DIP__DIP-16_W7.62mm
U6: SN74AHCT125N / LED + serial TX; Package_DIP__DIP-14_W7.62mm

Connections:
ACC_CS_N: J3.9 (ACC_CS_N), R2.1 (ACC_CS_N), U4.4 (ACC_CS_N)
ACC_CS_S: A1.22 (ACC_CS_S), U4.16 (ACC_CS_S)
ACC_DETECT_N: J3.13 (ACC_DETECT_N), R3.1 (ACC_DETECT_N), U4.5 (ACC_DETECT_N)
ACC_DETECT_S: A1.20 (ACC_DETECT_S), U4.15 (ACC_DETECT_S)
ACC_MISO: J3.7 (ACC_MISO), U5.18 (ACC_MISO)
ACC_MISO_DRV: A1.25 (ACC_MISO_DRV), RN3.7 (ACC_MISO_DRV), U5.2 (ACC_MISO_DRV)
ACC_MOSI: J3.5 (ACC_MOSI), RN3.3 (ACC_MOSI), U4.3 (ACC_MOSI)
ACC_MOSI_S: A1.21 (ACC_MOSI_S), U4.17 (ACC_MOSI_S)
ACC_OE_N: A1.27 (ACC_OE_N), R1.1 (ACC_OE_N), U5.19 (ACC_OE_N)
ACC_READY: J3.11 (ACC_READY), U5.17 (ACC_READY)
ACC_READY_DRV: A1.26 (ACC_READY_DRV), RN3.8 (ACC_READY_DRV), U5.3 (ACC_READY_DRV)
ACC_SCK: J3.3 (ACC_SCK), RN3.2 (ACC_SCK), U4.2 (ACC_SCK)
ACC_SCK_S: A1.24 (ACC_SCK_S), U4.18 (ACC_SCK_S)
ASSERT_CLK: A1.10 (ASSERT_CLK), Q2.2 (ASSERT_CLK), RN2.2 (ASSERT_CLK)
ASSERT_DATA: A1.16 (ASSERT_DATA), Q3.2 (ASSERT_DATA), RN2.3 (ASSERT_DATA)
ASSERT_SRQ: A1.17 (ASSERT_SRQ), Q4.2 (ASSERT_SRQ), RN2.4 (ASSERT_SRQ)
AUDIO_OUT: J8.1 (AUDIO_OUT), R11.2 (AUDIO_OUT)
AUDIO_PWM: A1.31 (AUDIO_PWM), R11.1 (AUDIO_PWM)
CORE_BUSY: A1.19 (CORE_BUSY), U4.13 (CORE_BUSY)
CORE_BUSY_RAW: J4.5 (CORE_BUSY_RAW), RN3.5 (CORE_BUSY_RAW), U4.7 (CORE_BUSY_RAW)
CORE_LED_RAW: J4.6 (CORE_LED_RAW), RN3.6 (CORE_LED_RAW), U4.8 (CORE_LED_RAW)
CORE_LED_S: A1.32 (CORE_LED_S), U4.12 (CORE_LED_S)
CORE_RX: A1.2 (CORE_RX), U4.14 (CORE_RX)
CORE_RX_RAW: J4.3 (CORE_RX_RAW), RN3.4 (CORE_RX_RAW), U4.6 (CORE_RX_RAW)
CORE_TX: A1.1 (CORE_TX), J4.4 (CORE_TX)
CP1N: C1.2 (CP1N), U3.3 (CP1N)
CP1P: C1.1 (CP1P), U3.1 (CP1P)
CP2N: C2.2 (CP2N), U3.5 (CP2N)
CP2P: C2.1 (CP2P), U3.4 (CP2P)
GND: A1.3 (GND), A1.8 (GND), A1.13 (GND), A1.18 (GND), A1.23 (GND), A1.28 (GND), A1.33 (GND), A1.38 (GND), C3.2 (GND), C4.1 (GND), C5.2 (GND), C7.2 (GND), C8.2 (GND), C9.2 (GND), C10.2 (GND), C11.2 (GND), C12.2 (GND), C13.2 (GND), J1.3 (GND), J1.SH (GND), J2.5 (GND), J2.SH (GND), J3.1 (GND), J3.2 (GND), J3.4 (GND), J3.6 (GND), J3.8 (GND), J3.10 (GND), J3.12 (GND), J3.14 (GND), J3.16 (GND), J3.18 (GND), J3.20 (GND), J4.1 (GND), J4.8 (GND), J5.2 (GND), J6.2 (GND), J7.3 (GND), J8.2 (GND), J9.4 (GND), J9.SH (GND), J10.4 (GND), J10.SH (GND), Q1.1 (GND), Q2.1 (GND), Q3.1 (GND), Q4.1 (GND), R6.2 (GND), R9.2 (GND), R10.2 (GND), RN1.1 (GND), RN2.1 (GND), RN3.1 (GND), U1.10 (GND), U1.19 (GND), U3.15 (GND), U4.9 (GND), U4.10 (GND), U4.19 (GND), U5.4 (GND), U5.5 (GND), U5.6 (GND), U5.7 (GND), U5.8 (GND), U5.9 (GND), U5.10 (GND), U6.1 (GND), U6.4 (GND), U6.7 (GND), U6.10 (GND), U6.12 (GND)
IEC_ATN: J1.5 (IEC_ATN), RN1.2 (IEC_ATN), U1.2 (IEC_ATN)
IEC_ATN_S: A1.4 (IEC_ATN_S), U1.18 (IEC_ATN_S)
IEC_CLK: J1.2 (IEC_CLK), Q2.3 (IEC_CLK), RN1.3 (IEC_CLK), U1.3 (IEC_CLK)
IEC_CLK_S: A1.5 (IEC_CLK_S), U1.17 (IEC_CLK_S)
IEC_DATA: J1.4 (IEC_DATA), Q3.3 (IEC_DATA), RN1.4 (IEC_DATA), U1.4 (IEC_DATA)
IEC_DATA_S: A1.6 (IEC_DATA_S), U1.16 (IEC_DATA_S)
IEC_RESET: J1.6 (IEC_RESET), RN1.6 (IEC_RESET), U1.6 (IEC_RESET)
IEC_RESET_S: A1.9 (IEC_RESET_S), U1.14 (IEC_RESET_S)
IEC_SRQ: J1.1 (IEC_SRQ), Q4.3 (IEC_SRQ), RN1.5 (IEC_SRQ), U1.5 (IEC_SRQ)
IEC_SRQ_S: A1.7 (IEC_SRQ_S), U1.15 (IEC_SRQ_S)
LED_DATA: A1.29 (LED_DATA), RN3.9 (LED_DATA), U6.2 (LED_DATA)
LED_OUT: J7.2 (LED_OUT), R4.2 (LED_OUT)
LED_OUT_RAW: R4.1 (LED_OUT_RAW), U6.3 (LED_OUT_RAW)
POWER_PRESENT: A1.34 (POWER_PRESENT), U1.11 (POWER_PRESENT)
POWER_SENSE: R5.2 (POWER_SENSE), R6.1 (POWER_SENSE), U1.9 (POWER_SENSE)
RS_CTS_5V: R10.1 (RS_CTS_5V), U1.8 (RS_CTS_5V), U3.9 (RS_CTS_5V)
RS_CTS_OUT: J2.8 (RS_CTS_OUT), U3.7 (RS_CTS_OUT)
RS_RTS_IN: J2.7 (RS_RTS_IN), U3.8 (RS_RTS_IN)
RS_RX_5V: R9.1 (RS_RX_5V), U1.7 (RS_RX_5V), U3.12 (RS_RX_5V)
RS_RX_IN: J2.3 (RS_RX_IN), U3.13 (RS_RX_IN)
RS_TX_OUT: J2.2 (RS_TX_OUT), U3.14 (RS_TX_OUT)
RS_VMINUS: C4.2 (RS_VMINUS), U3.6 (RS_VMINUS)
RS_VPLUS: C3.1 (RS_VPLUS), U3.2 (RS_VPLUS)
SERIAL_CTS: A1.14 (SERIAL_CTS), U1.12 (SERIAL_CTS)
SERIAL_RTS: A1.15 (SERIAL_RTS), R8.2 (SERIAL_RTS), U6.9 (SERIAL_RTS)
SERIAL_RTS_5V: U3.10 (SERIAL_RTS_5V), U6.8 (SERIAL_RTS_5V)
SERIAL_RX: A1.12 (SERIAL_RX), U1.13 (SERIAL_RX)
SERIAL_TX: A1.11 (SERIAL_TX), R7.2 (SERIAL_TX), U6.5 (SERIAL_TX)
SERIAL_TX_5V: U3.11 (SERIAL_TX_5V), U6.6 (SERIAL_TX_5V)
USB_DM: J9.2 (USB_DM), J10.2 (USB_DM)
USB_DP: J9.3 (USB_DP), J10.3 (USB_DP)
USB_VBUS: J9.1 (USB_VBUS), J10.1 (USB_VBUS)
V3V3: A1.36 (V3V3), C5.1 (V3V3), C8.1 (V3V3), C9.1 (V3V3), C11.1 (V3V3), R1.2 (V3V3), R2.2 (V3V3), R3.2 (V3V3), R7.1 (V3V3), R8.1 (V3V3), U1.1 (V3V3), U1.20 (V3V3), U4.1 (V3V3), U4.20 (V3V3), U5.1 (V3V3), U5.20 (V3V3)
V5: C7.1 (V5), C10.1 (V5), C12.1 (V5), C13.1 (V5), D1.2 (V5), J6.1 (V5), J7.1 (V5), Q1.3 (V5), R5.1 (V5), U3.16 (V5), U6.13 (V5), U6.14 (V5)
V5_FUSED: F1.2 (V5_FUSED), Q1.2 (V5_FUSED)
V5_RAW: F1.1 (V5_RAW), J5.1 (V5_RAW)
VSYS: A1.39 (VSYS), D1.1 (VSYS)

Notes on the sheet:
5V regulated centre-positive barrel only. Q1 protects reverse polarity, NOT overvoltage. J9 USB-B to J10 internal USB-A and Adafruit898 A/micro-B jumper to Pico. USB_VBUS NOT tied to V5. Core J4 pins2 and7 NC. Core power uses separate 5V Berg cable;12V position NC. Accessory is custom3V3 SPI only, 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

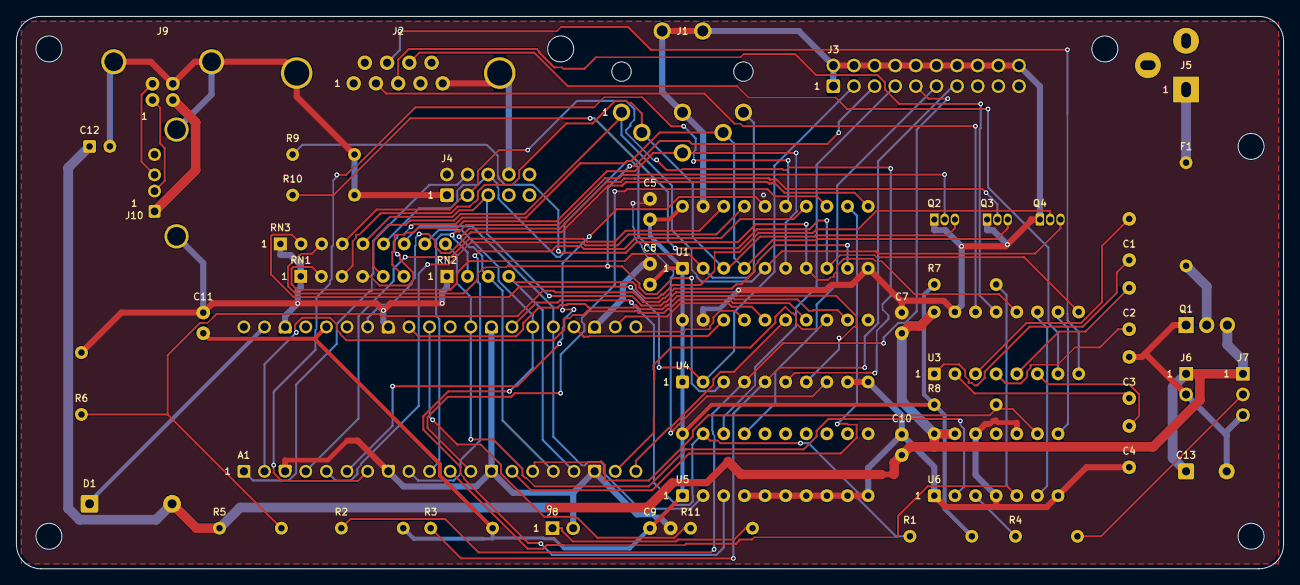
[picture p76: board cyber-external-dock-r3.kicad_pcb from above]

Board: 2 copper layers, 156.0 x 68.0 mm, 54 parts (0 on the bottom side), 67 nets.

Other parts of the board:
H1, H2, H3, H4, H5, H6: MountingHole_3.2mm_M3
