lionsarmor/cyber-disk-site/site/boards/single-r4/kicad/cyber-disk-single-r4.kicad_pcb

## KiCad design site/boards/single-r4/kicad/cyber-disk-single-r4.kicad_pcb (2026-11-08)

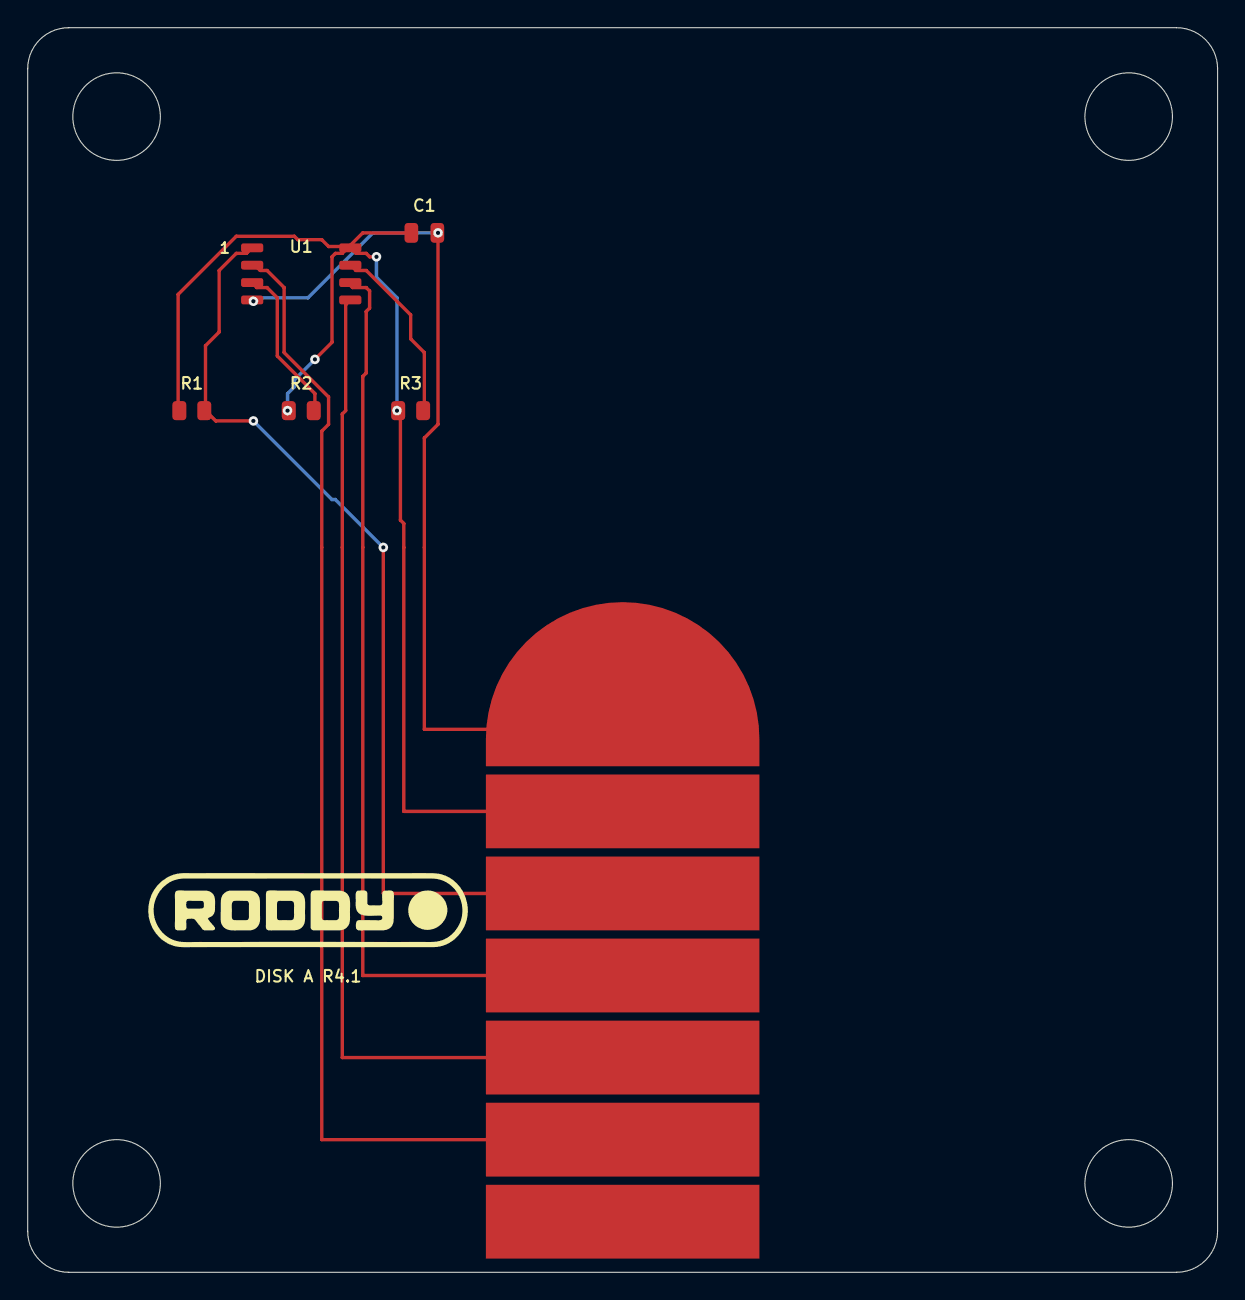
[picture p77: board cyber-disk-single-r4.kicad_pcb from above]

Board: 2 copper layers, 87.0 x 91.0 mm, 10 parts (0 on the bottom side), 8 nets.

Parts:
C1: 100nF; Capacitor_SMD__C_0805_2012Metric
H1: STRUCTURAL_POST_CLEARANCE_6.4; BoardMount_H1
H2: STRUCTURAL_POST_CLEARANCE_6.4; BoardMount_H2
H3: STRUCTURAL_POST_CLEARANCE_6.4; BoardMount_H3
H4: STRUCTURAL_POST_CLEARANCE_6.4; BoardMount_H4
J1: Contact7_F; Roddy__Contact7_F
R1, R2, R3: 10k; Resistor_SMD__R_0805_2012Metric
U1: MX25L3233FM2I-08G-TR; Package_SO__SOIC-8_5.3x5.3mm_P1.27mm

Connections:
A_CLK: J1.4, U1.6
A_CS: J1.3, R1.2, U1.1
A_GND: C1.2, J1.1, U1.4
A_HOLD: R3.2, U1.7
A_MISO: J1.6, U1.2
A_MOSI: J1.5, U1.5
A_VCC: C1.1, J1.2, R1.1, R2.1, R3.1, U1.8
A_WP: R2.2, U1.3
