lionsarmor/cyber-disk-site/site/boards/ab-r4/kicad/cyber-disk-ab-r4.kicad_pcb

## KiCad design site/boards/ab-r4/kicad/cyber-disk-ab-r4.kicad_pcb (2026-11-08)

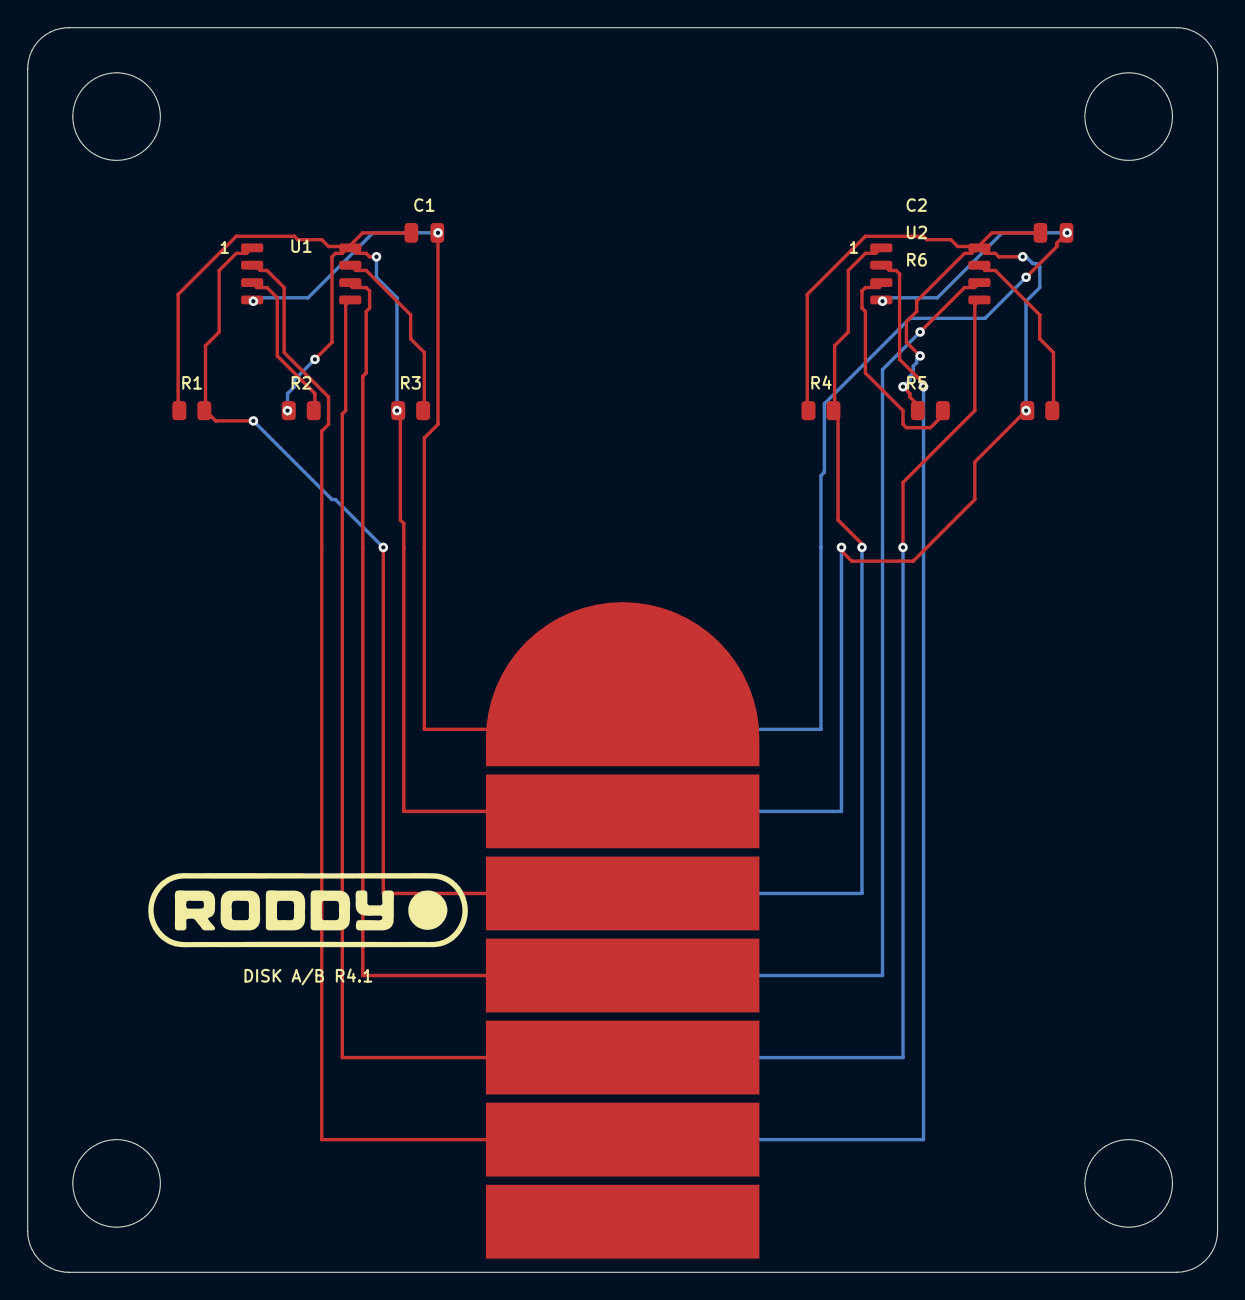
[picture p78: board cyber-disk-ab-r4.kicad_pcb from above]

Board: 2 copper layers, 87.0 x 91.0 mm, 16 parts (1 on the bottom side), 16 nets.

Parts:
C1, C2: 100nF; Capacitor_SMD__C_0805_2012Metric
H1: STRUCTURAL_POST_CLEARANCE_6.4; BoardMount_H1
H2: STRUCTURAL_POST_CLEARANCE_6.4; BoardMount_H2
H3: STRUCTURAL_POST_CLEARANCE_6.4; BoardMount_H3
H4: STRUCTURAL_POST_CLEARANCE_6.4; BoardMount_H4
J1: Contact7_F; Roddy__Contact7_F
J2: Contact7_B; Roddy__Contact7_B
R1, R2, R3, R4, R5, R6: 10k; Resistor_SMD__R_0805_2012Metric
U1, U2: MX25L3233FM2I-08G-TR; Package_SO__SOIC-8_5.3x5.3mm_P1.27mm

Connections:
A_CLK: J1.4, U1.6
A_CS: J1.3, R1.2, U1.1
A_GND: C1.2, J1.1, U1.4
A_HOLD: R3.2, U1.7
A_MISO: J1.6, U1.2
A_MOSI: J1.5, U1.5
A_VCC: C1.1, J1.2, R1.1, R2.1, R3.1, U1.8
A_WP: R2.2, U1.3
B_CLK: J2.4, U2.6
B_CS: J2.3, R4.2, U2.1
B_GND: C2.2, J2.1, U2.4
B_HOLD: R6.2, U2.7
B_MISO: J2.6, U2.2
B_MOSI: J2.5, U2.5
B_VCC: C2.1, J2.2, R4.1, R5.1, R6.1, U2.8
B_WP: R5.2, U2.3
