lionsarmor/cyber-disk-site/(commit log)

2026-11-07 Publish Cyber Disk inspector at disk.roddy.world
    [basic-ab-assembly.step, basic-ab-body-lower-print.stl, basic-ab-body-upper-print.stl, basic-single-assembly.step, basic-single-body-lower-print.stl, basic-single-body-upper-print.stl, cyber-runner-ab-accent-left-A-print.stl, cyber-runner-ab-accent-left-B-print.stl]
2026-11-07 Add first drive assembly CAD inspection views
    [drive-r0-01-base-tray.stl, drive-r0-02-top-cover.stl, drive-r0-03-bezel.stl, drive-r0-04-door-flap.stl, drive-r0-05-left-guide.stl, drive-r0-06-right-guide.stl, drive-r0-07-left-eject-sled-and-keeper.stl, drive-r0-07b-right-eject-sled.stl]
2026-11-07 Refine drive R1 underside contacts, flap bearings and mounting fit
    [drive-r1-01-base-tray.stl, drive-r1-02-top-cover.stl, drive-r1-03-bezel.stl, drive-r1-04-door-flap.stl, drive-r1-04b-left-hinge-bearing-cap.stl, drive-r1-04b-right-hinge-bearing-cap.stl, drive-r1-05-left-guide.stl, drive-r1-06-right-guide.stl]
2026-11-07 Add drive motion scrubber, flap-first eject CAD and KiCad PCB views
    [drive-r2-01-base-tray.stl, drive-r2-02-top-cover.stl, drive-r2-03-bezel.stl, drive-r2-04-door-flap.stl, drive-r2-04b-left-hinge-bearing-cap.stl, drive-r2-04b-right-hinge-bearing-cap.stl, drive-r2-05-left-guide.stl, drive-r2-06-right-guide.stl]
2026-11-07 Show flap actuator from inside the bezel
2026-11-07 Publish simplified right-side eject mechanism and updated animation
    [drive-r3-01-base-tray.stl, drive-r3-02-top-cover.stl, drive-r3-03-bezel.stl, drive-r3-04-door-flap.stl, drive-r3-04b-left-hinge-bearing-cap.stl, drive-r3-04b-right-hinge-bearing-cap.stl, drive-r3-05-left-guide.stl, drive-r3-06-right-guide.stl]
2026-11-07 Publish reinforced R4 drive with rounded bezel and visible wiring
    [drive-r4-01-base-tray.stl, drive-r4-02-top-cover.stl, drive-r4-03-bezel.stl, drive-r4-04-door-flap.stl, drive-r4-04b-left-hinge-bearing-cap.stl, drive-r4-04b-right-hinge-bearing-cap.stl, drive-r4-05-left-guide.stl, drive-r4-06-right-guide.stl]
2026-11-07 Publish corrected CD bay face with nearly square corners
    [drive-r4-bay-face-01-base-tray.stl, drive-r4-bay-face-02-top-cover.stl, drive-r4-bay-face-03-bezel.stl, drive-r4-bay-face-04-door-flap.stl, drive-r4-bay-face-04b-left-hinge-bearing-cap.stl, drive-r4-bay-face-04b-right-hinge-bearing-cap.stl, drive-r4-bay-face-05-left-guide.stl, drive-r4-bay-face-06-right-guide.stl]
2026-11-07 Publish routed leaf-spring contact PCB and matching cassette fit
    [drive-r4-contact-r1-01-base-tray.stl, drive-r4-contact-r1-02-top-cover.stl, drive-r4-contact-r1-03-bezel.stl, drive-r4-contact-r1-04-door-flap.stl, drive-r4-contact-r1-04b-left-hinge-bearing-cap.stl, drive-r4-contact-r1-04b-right-hinge-bearing-cap.stl, drive-r4-contact-r1-05-left-guide.stl, drive-r4-contact-r1-06-right-guide.stl]
2026-11-07 Publish supplier master BOM and updated PCB inspection models
    [master-bom.csv, pcb-ab-sourcing-r1.step, pcb-controller-sourcing-r1.step, pcb-single-sourcing-r1.step]
2026-11-07 Publish per-board KiCad projects, drawings and fabrication archives
    [BOM-candidates.csv, BOM.csv, S7131-45R-envelope.step, board-outline.step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]
2026-11-07 Publish eject button that remains outside bezel at full press
    [drive-r4-button-r2-01-base-tray.stl, drive-r4-button-r2-02-top-cover.stl, drive-r4-button-r2-03-bezel.stl, drive-r4-button-r2-04-door-flap.stl, drive-r4-button-r2-04b-left-hinge-bearing-cap.stl, drive-r4-button-r2-04b-right-hinge-bearing-cap.stl, drive-r4-button-r2-05-left-guide.stl, drive-r4-button-r2-06-right-guide.stl]
2026-11-07 Publish external dock case and daughterboard inspection package
    [BOM-candidates.csv, C330-envelope.step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]
2026-11-07 Publish slim barrel-powered external dock R1 previews and files
    [BOM-candidates.csv, C330-envelope.step, PJ102AH-envelope.step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]
2026-11-07 Publish Basic R2 external case CAD and inspection scenes
    [external-r2-01-front-chassis.stl, external-r2-02-rear-chassis.stl, external-r2-03-underfloor-joint-bridge.stl, external-r2-04-core-slide-carrier.stl, external-r2-05-lightwell.stl, external-r2-06-opal-base-diffuser.stl, external-r2-07-daughterboard-slide-tray.stl, external-r2-10-front-lid.stl]
2026-11-07 Make external label colour follow shell plastic
    [master-bom.csv]
2026-11-07 Publish board-mounted dock ports, R3 case and R2 board downloads
    [BOM-candidates.csv, C330-envelope.step, DE9_09661527612.step, DIN_61PC6F.step, PJ102AH-envelope.step, USB_B_61729.step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]
2026-11-07 Publish labeled drive-to-dock wiring and revised cable-exit CAD
    [external-r3-core-base-with-dock-cable-exit.stl, master-bom.csv]
2026-11-07 Publish serviceable cable exit and final wiring review assets
    [external-r3-core-base-with-dock-cable-exit.stl]
2026-11-07 Publish electrical review, corrected controller and updated floppy compatibility targets
    [BOM-candidates.csv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]
2026-11-08 Publish routed controller and dock, firmware and electrical R2 review
    [BOM-candidates.csv, C330-envelope.step, DE9_09661527612.step, DIN_61PC6F.step, PJ102AH-envelope.step, USB_B_61729.step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]
2026-11-08 Refresh current electrical manifests for returning visitors
2026-11-08 Refresh BOM script cache
2026-11-08 Publish branded routed PCBs, R5 drive hardware and current fabrication library
    [BOM-candidates.csv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]
2026-11-08 Publish screw-terminal contact harness, power connector and current board files
    [BOM-candidates.csv, BOM.csv, TE1718264-floppy-power.step, Terminal7_Phoenix1725708.step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]
2026-11-08 Show the current controller and power header in dock wiring view
2026-11-08 Publish drive speaker hardware, removable cradle and audio inspection views
    [BOM-candidates.csv, KEMET-C315-envelope.step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]
